muJoseph/Emma-Mk1-DRSSTC/hardware/electrical/Emma Mk1 DRSSTC GDT Driver Rev D/Emma Mk1 DRSSTC GDT Driver Rev D Bottom.png

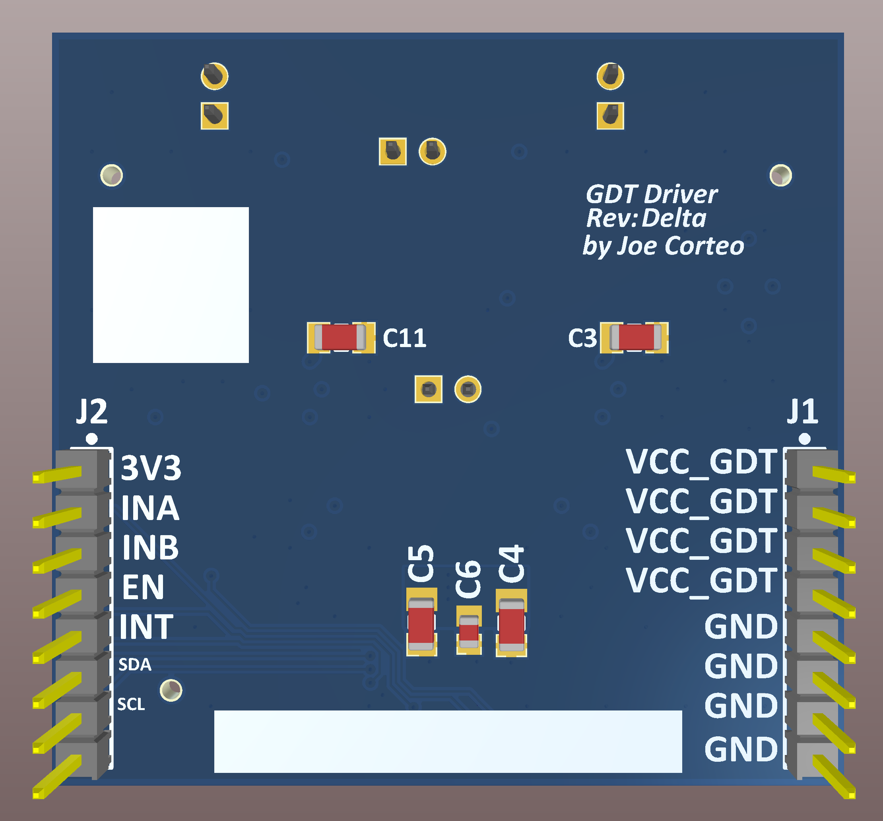
hardware/electrical/Emma Mk1 DRSSTC GDT Driver Rev D/Emma Mk1 DRSSTC GDT Driver Rev D Bottom.png
