muJoseph/Emma-Mk1-DRSSTC/hardware/electrical/Emma Mk1 DRSSTC MB Rev A/Emma Mk1 DRSSTC MB Rev A + GDT Driver Rev D.png

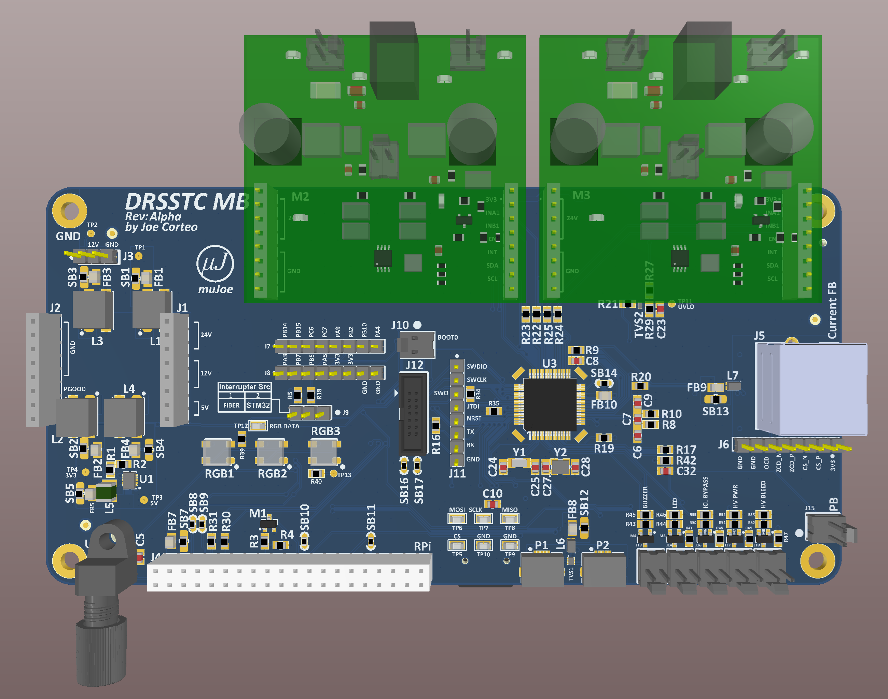
hardware/electrical/Emma Mk1 DRSSTC MB Rev A/Emma Mk1 DRSSTC MB Rev A + GDT Driver Rev D.png
