muJoseph/Emma-Mk1-DRSSTC/hardware/electrical/Emma Mk1 DRSSTC MB Rev A/Emma Mk1 DRSSTC MB Rev A Bottom.png

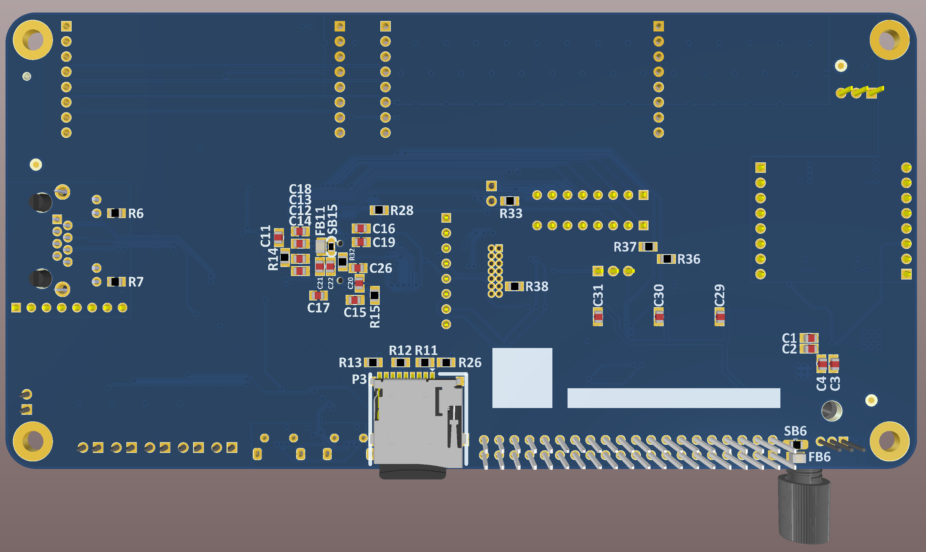
hardware/electrical/Emma Mk1 DRSSTC MB Rev A/Emma Mk1 DRSSTC MB Rev A Bottom.png
