muJoseph/Emma-Mk1-DRSSTC/hardware/electrical/Emma Mk1 DRSSTC MB Rev A/Emma Mk1 DRSSTC MB Rev A Top.png

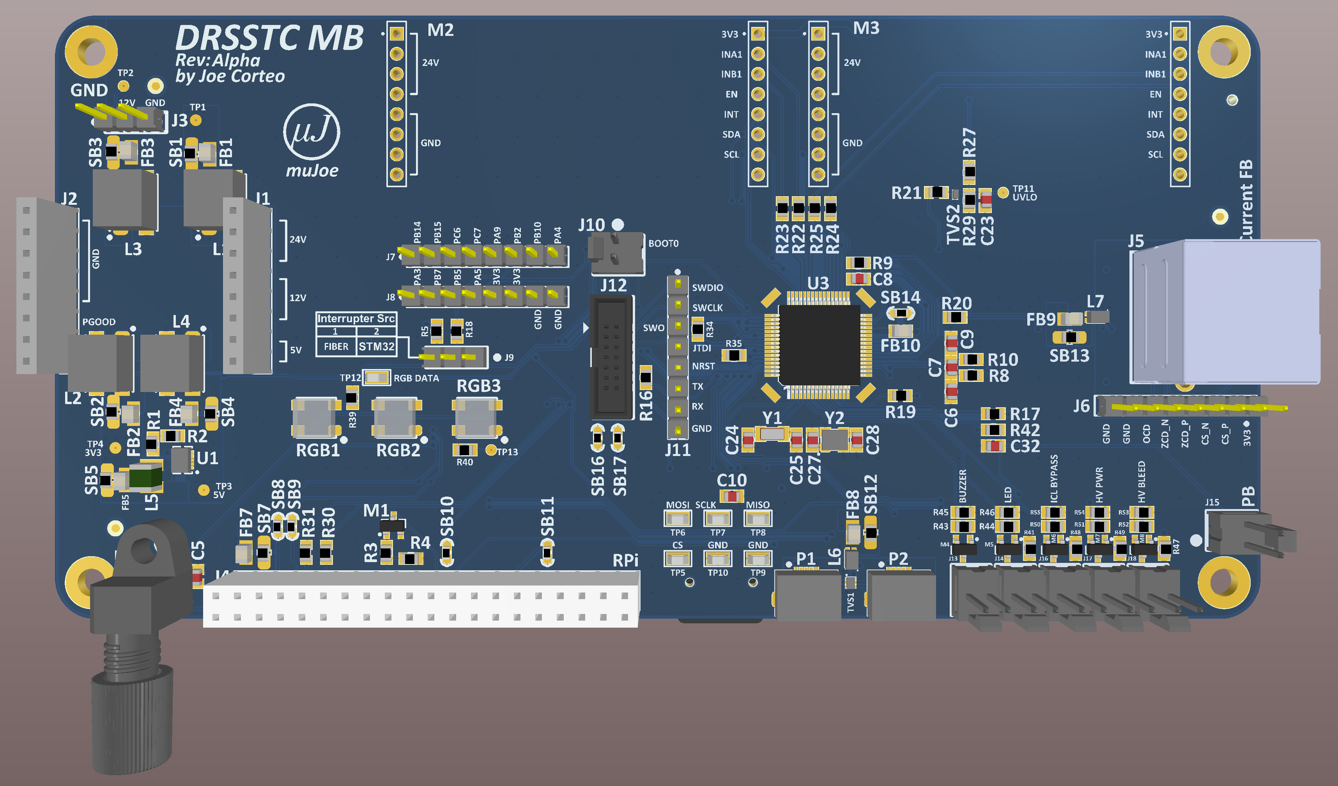
hardware/electrical/Emma Mk1 DRSSTC MB Rev A/Emma Mk1 DRSSTC MB Rev A Top.png
