muJoseph/Emma-Mk1-DRSSTC/hardware/electrical/img/emma-mk1-drsstc-gdt-driver-revd-bottom.png

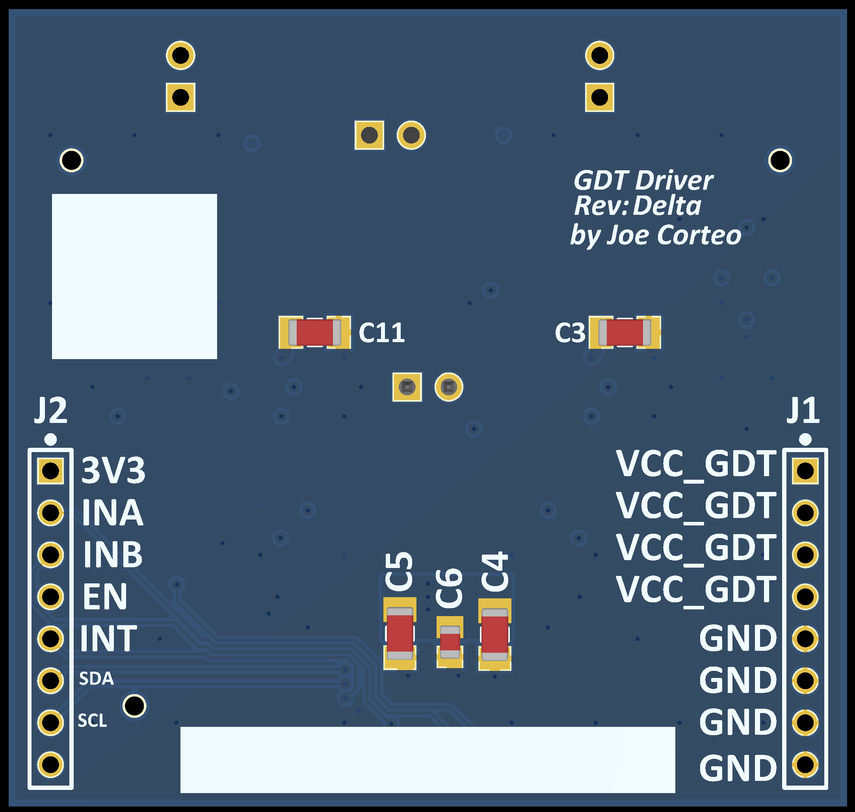
hardware/electrical/img/emma-mk1-drsstc-gdt-driver-revd-bottom.png
