muJoseph/Emma-Mk1-DRSSTC/hardware/electrical/img/emma-mk1-drsstc-gdt-driver-revd-top.png

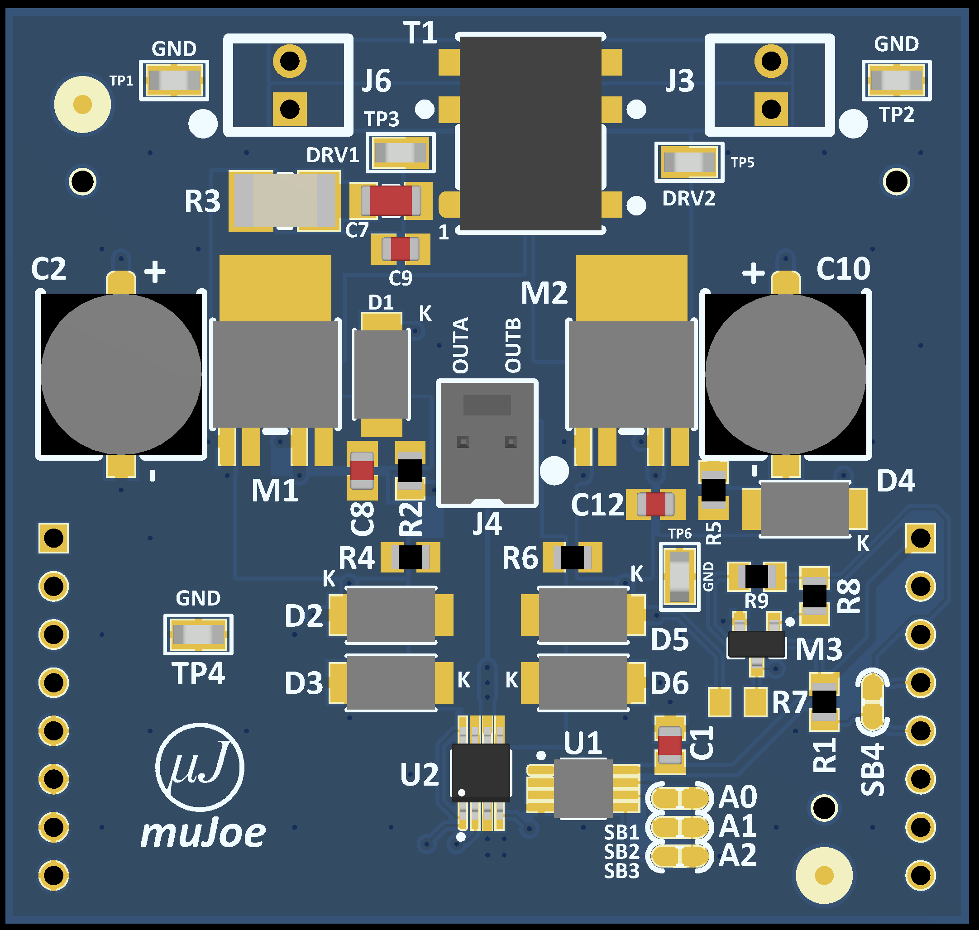
hardware/electrical/img/emma-mk1-drsstc-gdt-driver-revd-top.png
