muJoseph/Emma-Mk1-DRSSTC/hardware/electrical/img/emma-mk1-drsstc-half-bridge-bottom.png

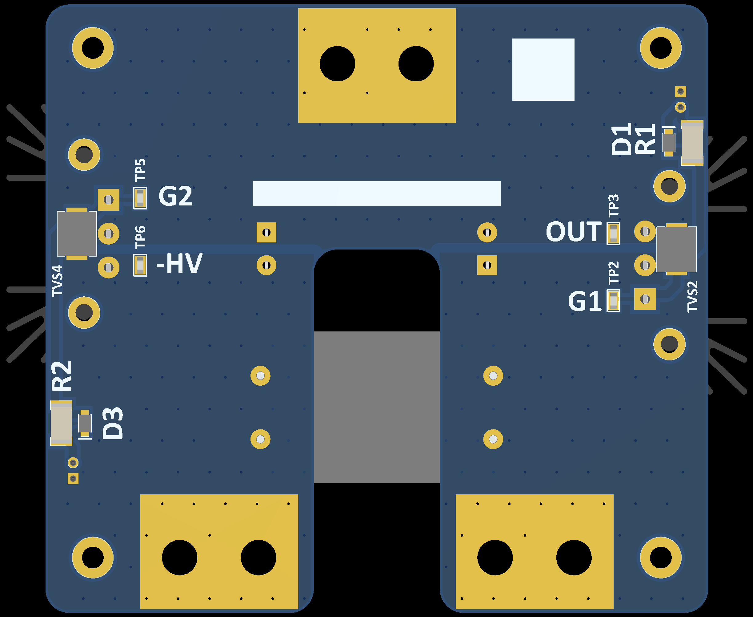
hardware/electrical/img/emma-mk1-drsstc-half-bridge-bottom.png
