muJoseph/Emma-Mk1-DRSSTC/hardware/electrical/img/emma-mk1-drsstc-half-bridge-top.png

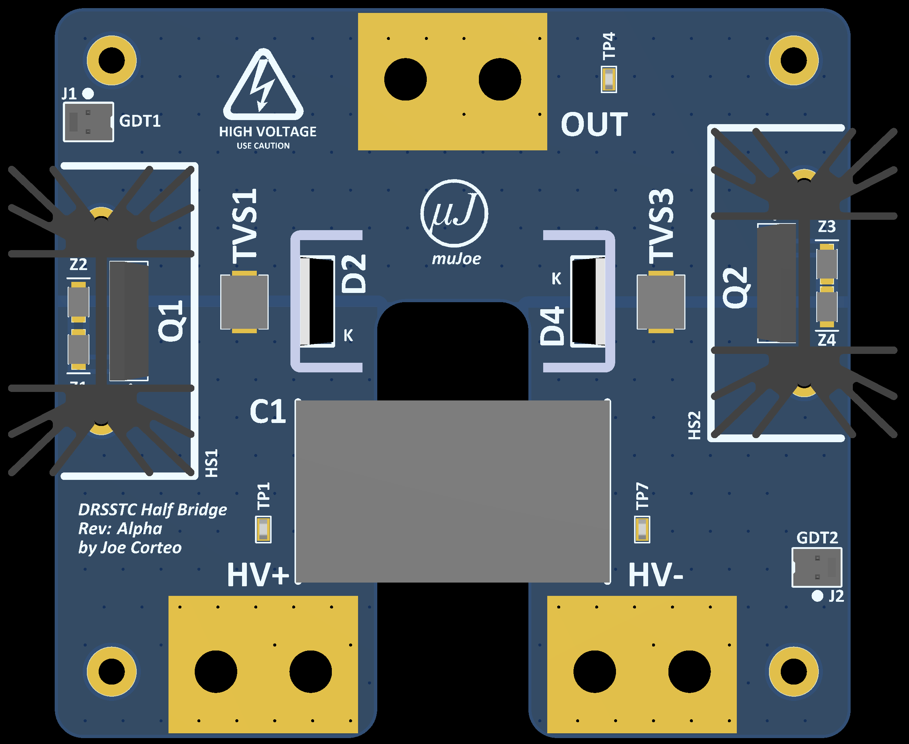
hardware/electrical/img/emma-mk1-drsstc-half-bridge-top.png
