muJoseph/Emma-Mk1-DRSSTC/hardware/electrical/img/emma-mk1-drsstc-mmc-revb-bottom.png

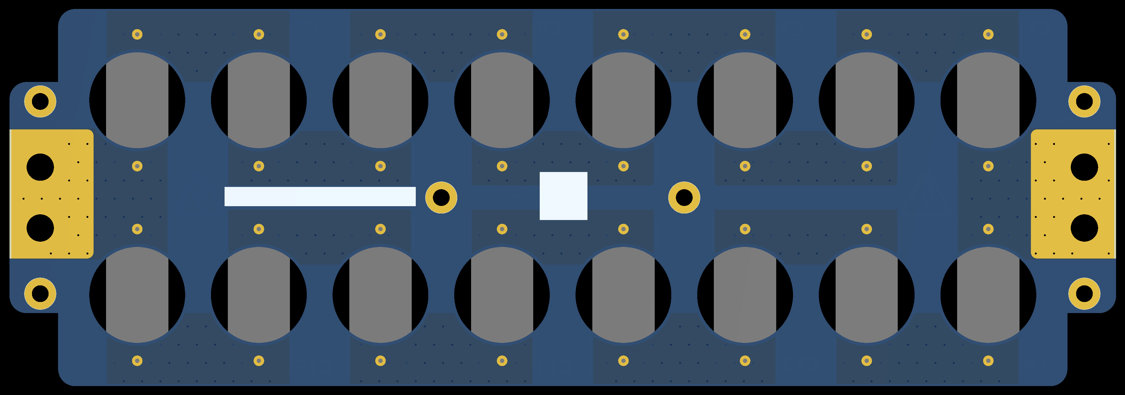
hardware/electrical/img/emma-mk1-drsstc-mmc-revb-bottom.png
