muJoseph/Emma-Mk1-DRSSTC/hardware/electrical/img/emma-mk1-drsstc-motherboard-reva-top.png

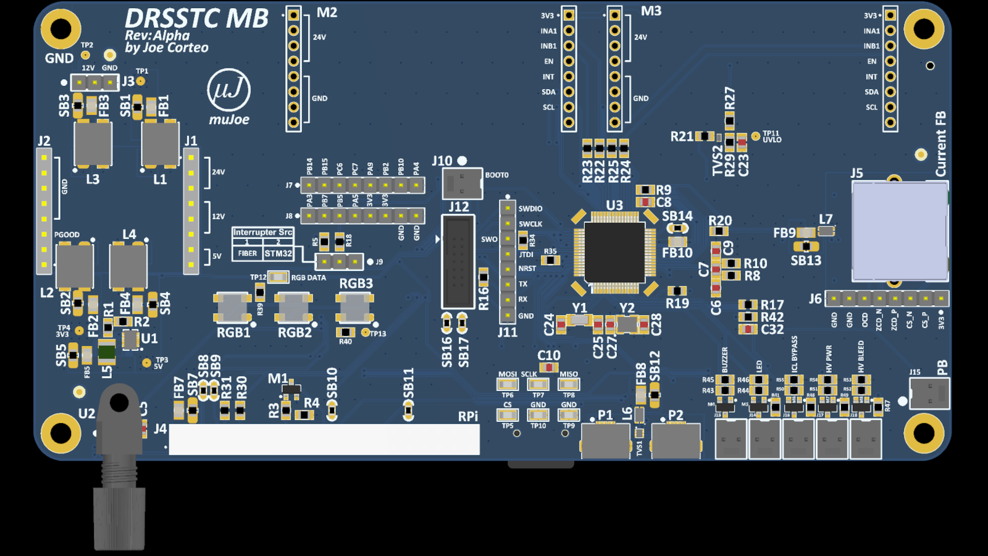
hardware/electrical/img/emma-mk1-drsstc-motherboard-reva-top.png
