muJoseph/Emma-Mk1-DRSSTC/hardware/electrical/img/emma-mk1-drsstc-vdoubler-reva-bottom.png

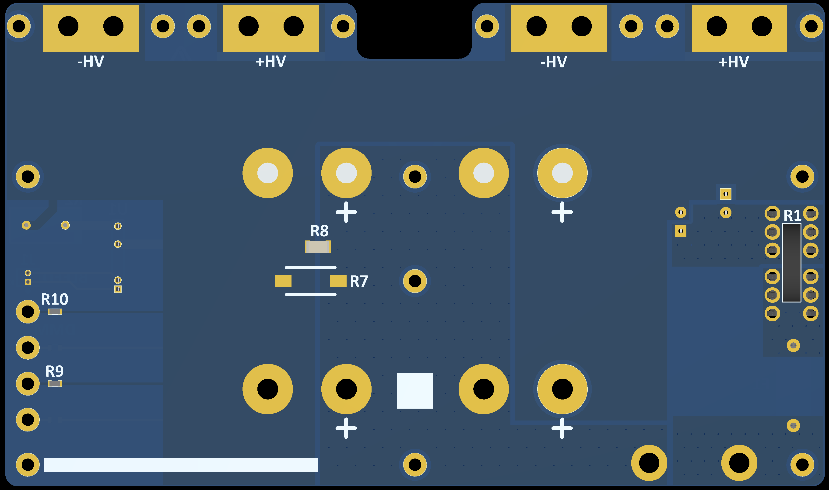
hardware/electrical/img/emma-mk1-drsstc-vdoubler-reva-bottom.png
