muJoseph/Emma-Mk1-DRSSTC/hardware/electrical/img/emma-mk1-drsstc-vdoubler-reva-top.png

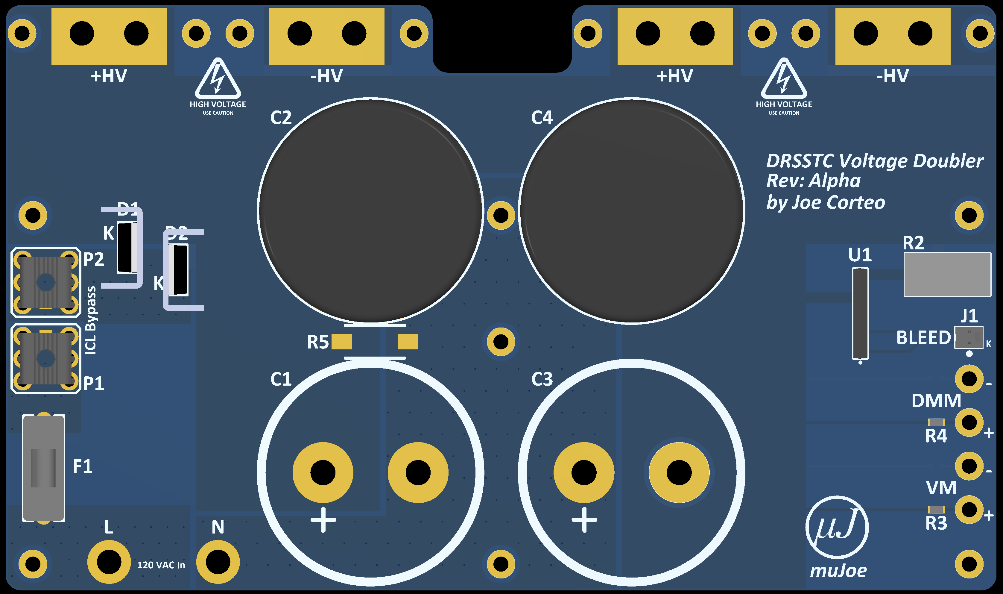
hardware/electrical/img/emma-mk1-drsstc-vdoubler-reva-top.png
