muJoseph/Emma-Mk1-DRSSTC/hardware/mechanical/img/emma-mk1-drsstc-back.png

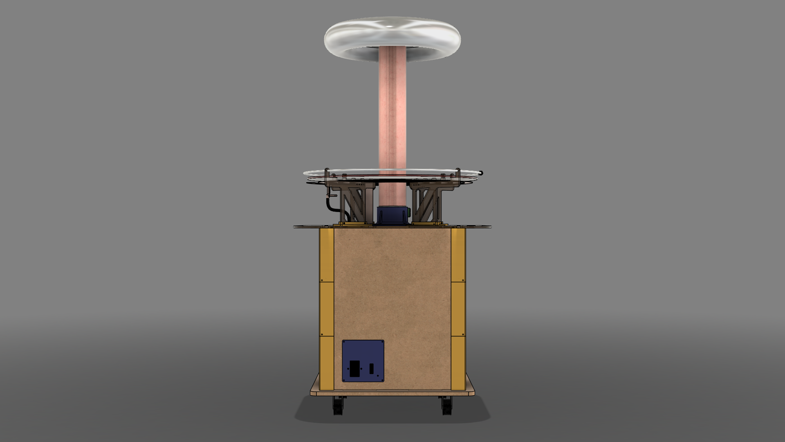
hardware/mechanical/img/emma-mk1-drsstc-back.png
