muJoseph/Emma-Mk1-DRSSTC/hardware/mechanical/img/emma-mk1-drsstc-front.png

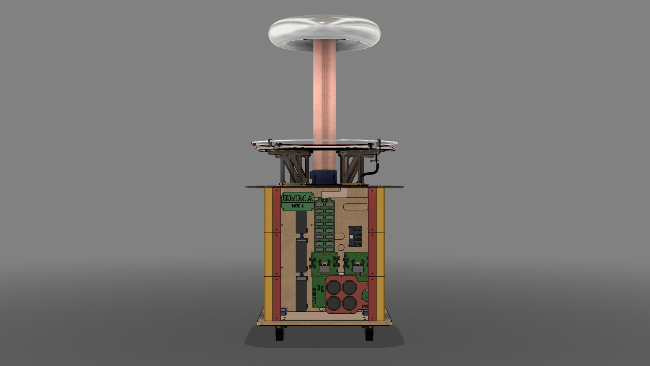
hardware/mechanical/img/emma-mk1-drsstc-front.png
