muJoseph/Emma-Mk1-DRSSTC/hardware/electrical/Emma Mk1 DRSSTC MMC Bank Rev B/BOM-Emma Mk1 DRSSTC MMC Bank Rev B.xlsx

Part Description | Value | MFG P/N | MFG | Designator | Footprint | Quantity | JLCPCB Part #
0.18 µF Film Capacitor 650V 1600V (1.6kV) Polypropylene (PP), Metallized Radial | 0.18uF, 1.6kVDC | R75TR318050H2J | KEMET | C1, C2, C3, C4, C5, C6, C7, C8, C9, C10, C11, C12, C13, C14, C15, C16 | R75TR318050H2J | 16
