muJoseph/Emma-Mk1-DRSSTC/hardware/electrical/Emma Mk1 DRSSTC GDT Driver Rev D/BOM-Emma Mk1 DRSSTC GDT Driver Rev D.xlsx

Part Description | Value | MFG P/N | MFG | Designator | Footprint | Quantity | JLCPCB Part #
100nF 50V X7R ±10% 0805 Multilayer Ceramic Capacitors MLCC - SMD/SMT ROHS | 0.1uF,50V | CL21B104KBCNNNC | Samsung Electro-Mechanics | C1, C6, C8, C12 | CAPC0805(2012)100_N | 4 | C1711
-55℃~+105℃ 10.5mm 100uF 150mA@120Hz 5000hrs@105℃ 50V 8mm ±20% SMD,D8xL10mm Aluminum Electrolytic Capacitors - SMD ROHS | 100uF, 50V | UUD1H101MNL1GS | Nichicon | C2, C10 | UUD1H101MNL1GS | 2 | C116241
4.7µF ±10% 50V Ceramic Capacitor X7R 1206 (3216 Metric) | 4.7uF,50V | CL31B475KBHNNNE | Samsung Electro-Mechanics | C3, C4, C11 | CAPC1206(3216) | 3 | C51205
1µF ±10% 50V Ceramic Capacitor X7R 1206 (3216 Metric) | 1uF,50V | C1206C105K5RACTU | KEMET | C5, C7 | CAPC1206(3216) | 2 | C2167287
2.2uF 50V X5R ±10% 0805 Multilayer Ceramic Capacitors MLCC - SMD/SMT ROHS | 2.2uF,50V | CL21A225KBQNNNE | Samsung Electro-Mechanics | C9 | CAPC0805(2012)100_N | 1 | C377773
-55℃~+125℃ 300uA@60V 3A 500mV@3A 60V 80A Independent SMA Schottky Diodes ROHS |  | SSL36 | hongjiacheng | D1, D2, D3, D4, D5, D6 | SSL36 | 6 | C28646286
Connector Header Through Hole 8 position 0.100" (2.54mm) |  | TSW-108-07-T-S | Samtec Inc. | J1, J2 | TSW-108-07-T-S | 2
Connector Header Through Hole 2 position 0.100" (2.54mm) |  | 22-23-2021 | Molex | J3, J4, J5, J6 | 22-23-2021 | 4 | C234180
-55℃~+150℃ 1 N-Channel + 1 P-Channel 1.5nF 135pF 20A 215pF 24mΩ@10V 24nC@10V 2V@250uA 40V 40W N-Channel + P-Channel TO-252-4L MOSFETs ROHS |  | FDD8424H-HXY | HXY MOSFET | M1, M2 | FDD8424H-HXY | 2 | C22366760
-55℃~+150℃ 1 N-Channel 22pF@25V 2pF@25V 310mA 3V@250uA 4Ω@5V 540mW 60V 870pC@10V SOT-23 MOSFETs ROHS |  | DMN65D8L-7 |  | M3 | DMN65D8L-7_STEP | 1 | C155341
-55℃~+155℃ 125mW 150V 1kΩ Thick Film Resistor ±1% ±100ppm/℃ 0805 Chip Resistor - Surface Mount ROHS | 1k,1/8W | 0805W8F1001T5E | UNI-ROYAL(Uniroyal Elec) | R1, R2, R5, R7, R9 | RESC0805(2012)_N | 5 | C17513
-55℃~+155℃ 15Ω 200V 750mW Thick Film Resistor ±1% ±100ppm/℃ 2010 Chip Resistor - Surface Mount ROHS | 15,3/4W | FRC2010F15R0TS | FOJAN | R3 | RES_2010_Power_Resistor | 1 | C3013300
0 Ohms Jumper Chip Resistor 0805 (2012 Metric) Automotive AEC-Q200 Thick Film | 0 | RMCF0805ZT0R00 | Stackpole Electronics | R4, R6, R8 | RESC0805(2012)_N | 3 | C237773
0 Ohms Jumper 0.1W, 1/10W Chip Resistor 0603 (1608 Metric) Automotive AEC-Q200 Thick Film | 0 | RMCF0603ZT0R00 | Stackpole Electronics | SB1, SB2, SB3, SB4 | SOLDER-BRIDGE-NO-RES0603 | 4
4mH Gate Drive Pulse Transformer 1:1:1 Surface Mount |  | PH9572.111ANLT | Pulse Electronics | T1 | PH9572.111ANLT | 1 | C6147304
2.67mmx1.02mm Ferrite Ring (SMD) Non-Plastic - Test Points / Test Rings ROHS |  | RH-5015 | ronghe | TP1, TP2, TP3, TP4, TP5, TP6 | RH-5015 | 6 | C5199798
Temperature Sensor Digital, Local -55°C ~ 125°C 11 b 8-TSSOP |  | PCT2075DP,118 | NXP USA Inc. | U1 | PCT2075DP,118 | 1 | C192518
-40℃~+150℃ 1.8V~2.3V 2 4.5V~26V 450uA 5A 5A 6ns 800mV~1.2V 9ns IGBT Low Side Under Voltage Protection HVSSOP-8 Gate Drivers ROHS |  | UCC27624DGNR | Texas Instruments | U2 | UCC27624DGNR_JLCPCB | 1 | C6581862
