muJoseph/Emma-Mk1-DRSSTC/hardware/electrical/Emma Mk1 DRSSTC VDoubler Rev A/BOM-Emma Mk1 DRSSTC VDoubler Rev A.xlsx

Part Description | Value | MFG P/N | MFG | Designator | Footprint | Quantity | JLCPCB Part #
3600µF 250V Aluminum Electrolytic Capacitors Radial, Can - Screw Terminals 74mOhm @ 100Hz 18000 Hrs @ 85°C | 3600uF,250V | ALS70A362KE250 | ALS70A362KE250 | C1, C2, C3, C4 | ALS70A362KE250 | 4
Diode Standard 600V 15A Through Hole TO-220AC |  | VS-15ETX06-M3 | Vishay Semiconductor Diodes Division | D1, D2 | VS-15ETX06-M3_WITH_507302B00000G | 2
Fuse Block 20A 250V 1 Circuit Cartridge Through Hole | 20A | 696108003002 | Würth Elektronik | F1 | 696108003002 | 1
Connector Header Through Hole 2 position 0.100" (2.54mm) |  | 22-23-2021 | Molex | J1 | 22-23-2021 | 1
6 Pin Screw Terminal, Power Tap M5 Through Hole |  | 7807 | Keystone Electronics | P1, P2 | 7807 | 2
Inrush Current Limiter 20 Ohms ±25% 7A 0.866" (22.00mm) | 20 | SL22 20007 | Ametherm | R1 | SL22 20007 | 1
1.1 kOhms ±5% 10W Through Hole Resistor Radial Cement Coated, Flame Proof, Moisture Resistant, Safety Wirewound | 1.1k,10W | SQMBW101K1J | TE Connectivity Passive Product | R2 | SQMBW101K1J | 1
60.4 kOhms ±1% 1W Chip Resistor 1206 (3216 Metric) Automotive AEC-Q200, Pulse Withstanding Thick Film | 60.4k,1W | RCS120660K4FKEA | Vishay Dale | R4, R10 | RES1206R | 2
20 kOhms ±5% 5W Chip Resistor 5329 (13573 Metric), J-Lead Flame Retardant Coating, Safety Metal Film | 20k, 5W | SMF520KJT | TE Connectivity Passive Product | R5, R7 | SMF520KJT | 2
60.4 kOhms ±1% 1W Chip Resistor 2512 (6332 Metric) Automotive AEC-Q200 Thick Film | 60.4k,1W | RMCF2512FT60K4 | Stackpole Electronics Inc | R6, R8 | RES2512R | 2 | C2491819
Solid State Photo-Coupled Relay (Photorelay) SPST-NO (1 Form A) 8-SIP, 4 Leads |  | CPC1983Y | IXYS Integrated Circuits Division | U1 | CPC1983Y | 1
