muJoseph/Emma-Mk1-DRSSTC/hardware/electrical/Emma Mk1 DRSSTC CS Rev B/BOM-Emma Mk1 DRSSTC CS Rev B(Low Diff Gain).xlsx

Part Description | Value | MFG P/N | MFG | Designator | Footprint | Quantity | JLCPCB Part #
100nF 50V X7R ±10% 0805 Multilayer Ceramic Capacitors MLCC - SMD/SMT ROHS | 0.1uF,50V | CL21B104KBCNNNC | Samsung Electro-Mechanics | C1, C2, C4 | CAPC0805(2012)100_N | 3 | C1711
Diode 30 V 100mA Surface Mount EMD2 |  | RB500SM-30FHT2R | Rohm Semiconductor | D2, D3, D4, D5, D10, D11 | RB500SM-30FHT2R_JLCPCB | 6 | C5336584
Diode 30 V 2A Surface Mount M-FLAT (2.4x3.8) |  | CMS06(TE12L,Q,M) | Toshiba Semiconductor and Storage | D6, D7, D8, D9 | CMS06(TE12L,Q,M)_JLCPCB | 4 | C261920
600 Ohms @ 100 MHz 1 Power Line Ferrite Bead 0805 (2012 Metric) 2A 90mOhm |  | WLBD2012HCU601TH | Walsin Technology Corporation | FB1 | FERRITE_BEAD_0805 | 1 | C3716924
2 Line Common Mode Choke Surface Mount 90 Ohms @ 100 MHz 500mA DCR 300mOhm |  | BWCU00201212900Y03 | Pulse Electronics | L1 | BWCU00201212900Y03 | 1 | C2838272
1.3 kOhms ±0.1% 0.125W, 1/8W Chip Resistor 0805 (2012 Metric) Automotive AEC-Q200 Thin Film | 1k3, 0.1% | ERA-6AEB132V | Panasonic Electronic Components | R1, R2, R7, R8, R14, R16 | RESC0805(2012)_N | 6 | C473285
500 mOhms ±1% 0.5W, 1/2W Chip Resistor 1206 (3216 Metric) Current Sense Thick Film | 500m, 1/2W | CSR1206FTR500 | Stackpole Electronics Inc | R4, R9, R10 | RES1206R | 3 | C346764
10 kOhms ±0.1% 0.125W, 1/8W Chip Resistor 0805 (2012 Metric) Thin Film | 10k, 0.1% | RT0805BRD0710KL | YAGEO | R5, R6, R11, R12 | RESC0805(2012)_N | 4 | C110775
-55℃~+155℃ 100V 100mW 3.92kΩ Thin Film Resistor ±0.1% ±10ppm/℃ 0805 Chip Resistor - Surface Mount ROHS | 3.92k, 0.1% | RN73C2A3K92BTD | TE Connectivity | R13, R17 | RESC0805(2012)_N | 2 | C2089962
33 mOhms ±1% 0.25W, 1/4W Chip Resistor 0805 (2012 Metric) Automotive AEC-Q200, Current Sense, Moisture Resistant Thick Film | 33m, 1/4W | RCWE080533L0FNEA | Vishay Dale | R15 | RESC0805(2012)_N | 1 | C3989910
2.67mmx1.02mm Ferrite Ring (SMD) Non-Plastic - Test Points / Test Rings ROHS |  | RH-5015 | ronghe | TP1, TP2, TP3, TP4, TP5, TP6, TP7, TP8, TP9 | RH-5015 | 9 | C5199798
6.2V Clamp 17A (8/20µs) Ipp Tvs Diode Surface Mount 0402C/SOD-923F | 3V3 | CPDQC3V3T-HF | Comchip Technology | TVS1, TVS2, TVS3, TVS4 | CPDQC3V3T-HF | 4 | C2443363
CMOS Amplifier 2 Circuit Rail-to-Rail 8-SOIC |  | TLV9062IDR | Texas Instruments | U1, U2 | TLV9062IDR | 2 | C398355
