muJoseph/Emma-Mk1-DRSSTC/hardware/electrical/Emma Mk1 DRSSTC CS Rev B/BOM-Emma Mk1 DRSSTC CS Rev B.xlsx

Part Description | Value | MFG P/N | MFG | Designator | Footprint | Quantity | JLCPCB Part #
100nF 50V X7R ±10% 0805 Multilayer Ceramic Capacitors MLCC - SMD/SMT ROHS | 0.1uF,50V | CL21B104KBCNNNC | Samsung Electro-Mechanics | C1, C2, C4 | CAPC0805(2012)100_N | 3 | C1711
Yellow-Green 572nm LED Indication - Discrete 2.2V 0603 (1608 Metric) |  | SML-D12M1WT86 | Rohm Semiconductor | D1 | SML-D12M1WT86 | 1
Diode 30 V 100mA Surface Mount EMD2 |  | RB500SM-30FHT2R | Rohm Semiconductor | D2, D3, D4, D5, D10, D11 | RB500SM-30FHT2R_JLCPCB | 6 | C5336584
Diode 30 V 2A Surface Mount M-FLAT (2.4x3.8) |  | CMS06(TE12L,Q,M) | Toshiba Semiconductor and Storage | D6, D7, D8, D9 | CMS06(TE12L,Q,M)_JLCPCB | 4 | C261920
600 Ohms @ 100 MHz 1 Power Line Ferrite Bead 0805 (2012 Metric) 2A 90mOhm |  | WLBD2012HCU601TH | Walsin Technology Corporation | FB1 | FERRITE_BEAD_0805 | 1 | C3716924
Jack Modular Connector 8p8c (RJ45, Ethernet) 90° Angle (Right) Shielded |  | MTJ-88ARX1-FSM-LG | Adam Tech | J1 | MTJ-88ARX1-FSM-LG | 1
Connector Header Through Hole 8 position 0.100" (2.54mm) |  | TSW-108-07-T-S | Samtec Inc. | J2 | TSW-108-07-T-S | 1
Connector Header Through Hole 2 position 0.100" (2.54mm) |  | 22-23-2021 | Molex | J3, J4, J5 | 22-23-2021 | 3
2 Line Common Mode Choke Surface Mount 90 Ohms @ 100 MHz 500mA DCR 300mOhm |  | BWCU00201212900Y03 | Pulse Electronics | L1 | BWCU00201212900Y03 | 1 | C2838272
1.3 kOhms ±0.1% 0.125W, 1/8W Chip Resistor 0805 (2012 Metric) Automotive AEC-Q200 Thin Film | 1k3, 0.1% | ERA-6AEB132V | Panasonic Electronic Components | R1, R2, R3, R7, R8, R14, R16 | RESC0805(2012)_N | 7 | C473285
500 mOhms ±1% 0.5W, 1/2W Chip Resistor 1206 (3216 Metric) Current Sense Thick Film | 500m, 1/2W | CSR1206FTR500 | Stackpole Electronics Inc | R4, R9, R10 | RES1206R | 3 | C346764
10 kOhms ±0.1% 0.125W, 1/8W Chip Resistor 0805 (2012 Metric) Thin Film | 10k, 0.1% | RT0805BRD0710KL | YAGEO | R5, R6, R11, R12 | RESC0805(2012)_N | 4 | C110775
21 kOhms ±0.1% 0.125W, 1/8W Chip Resistor 0805 (2012 Metric) Automotive AEC-Q200 Thin Film | 21k, 0.1% | ERA-6AEB2102V | Panasonic Electronic Components | R13, R17 | RESC0805(2012)_N | 2
33 mOhms ±1% 0.25W, 1/4W Chip Resistor 0805 (2012 Metric) Automotive AEC-Q200, Current Sense, Moisture Resistant Thick Film | 33m, 1/4W | RCWE080533L0FNEA | Vishay Dale | R15 | RESC0805(2012)_N | 1 | C3989910
0 Ohms Jumper 0.1W, 1/10W Chip Resistor 0603 (1608 Metric) Automotive AEC-Q200 Thick Film | 0 | RMCF0603ZT0R00 | Stackpole Electronics | SB1, SB2 | SOLDER-BRIDGE-NO-RES0603 | 2 | C2441282
110 A Current Sense Transformer 20kHz ~ 200kHz 580mOhm Max 14 mH Through Hole |  | CST206-1A | Triad Magnetics | T1, T2, T3 | CST206-1A | 3
2.67mmx1.02mm Ferrite Ring (SMD) Non-Plastic - Test Points / Test Rings ROHS |  | RH-5015 | ronghe | TP1, TP2, TP3, TP4, TP5, TP6, TP7, TP8, TP9 | RH-5015 | 9 | C5199798
6.2V Clamp 17A (8/20µs) Ipp Tvs Diode Surface Mount 0402C/SOD-923F | 3V3 | CPDQC3V3T-HF | Comchip Technology | TVS1, TVS2, TVS3, TVS4 | CPDQC3V3T-HF | 4 | C2443363
CMOS Amplifier 2 Circuit Rail-to-Rail 8-SOIC |  | TLV9062IDR | Texas Instruments | U1, U2 | TLV9062IDR | 2 | C398355
