muJoseph/Emma-Mk1-DRSSTC/hardware/electrical/Emma Mk1 DRSSTC Half Bridge Rev A/BOM-Emma Mk1 DRSSTC Half Bridge Rev A(IGBT Screw On Heatsink).xlsx

Part Description | Value | MFG P/N | MFG | Designator | Footprint | Quantity | JLCPCB Part #
5 µF Film Capacitor 1000V (1kV) Polypropylene (PP), Metallized Radial - 4 Leads | 5uF, 1kVDC | C4AQNLW4500M33J | KEMET | C1 | C4AQNLW4500M33J | 1
Diode Schottky 50V 1A Surface Mount SOD-123FL |  | DSS15UTR | SMC Diode Solutions | D1, D3 | DSS15UTR | 2
Diode Standard 600V 15A Through Hole TO-220AC |  | VS-15ETX06-M3 | Vishay Semiconductor Diodes Division | D2, D4 | VS-15ETX06-M3_WITH_507302B00000G | 2
Heat Sink TO-218, TO-220, TO-247 Aluminum Alloy 6.5W @ 75°C Board Level, Vertical |  | HSE17-252525P | Same Sky (Formerly CUI Devices) | HS1, HS2 | HSE17-252525P | 2
Connector Header Through Hole 2 position 0.100" (2.54mm) |  | 22-23-2021 | Molex | J1, J2 | 22-23-2021 | 2
IGBT Trench Field Stop 600 V 140 A 714 W Through Hole PG-TO247-3 |  | IGW100N60H3FKSA1 | Infineon Technologies | Q1, Q2 | IGW100N60H3FKSA1 | 2
15 Ohms ±5% 2W Chip Resistor 2512 (6432 Metric) Thick Film | 15,2W | CRGH2512J15R | TE Connectivity Passive Product | R1, R2 | RES2512R | 2
2.67mmx1.02mm Ferrite Ring (SMD) Non-Plastic - Test Points / Test Rings ROHS |  | RH-5015 | ronghe | TP1, TP2, TP3, TP4, TP5, TP6, TP7 | RH-5015 | 7 | C5199798
567V Clamp 2.6A Ipp Tvs Diode Surface Mount DO-214AB (SMCJ) | 350V | SMCJ350CA | Littelfuse Inc. | TVS1, TVS3 | SMCJ350CA | 2
45.7V Clamp 33.3A Ipp Tvs Diode Surface Mount DO-214AB (SMCJ) | 28V2 | 1.5SMC33CA | Littelfuse Inc. | TVS2, TVS4 | 1.5SMC33CA | 2
Zener Diode 33V 1W ±6.06% Surface Mount PMDTM | 33V | PDZVTFTR33B | Rohm Semiconductor | Z1, Z2, Z3, Z4 | PDZVTFTR33B | 4
