muJoseph/Emma-Mk1-DRSSTC/hardware/electrical/Emma Mk1 DRSSTC MB Rev A/BOM-Emma Mk1 DRSSTC MB Rev A(JLCPCB Fabrication).xlsx

Part Description | Value | MFG P/N | MFG | Designator | Footprint | Quantity | JLCPCB Part #
2.2 µF ±10% 16V Ceramic Capacitor X7R 0805 (2012 Metric) | 2.2uF, 16V | CL21B225KOFNNNE | Samsung Electro-Mechanics | C2 | CAPC0805(2012)100_N | 1 | C28234
22µF ±20% 16V Ceramic Capacitor X5R 0805 (2012 Metric) | 22uF,16V | CL21A226MOCLRNC | Samsung Electro-Mechanics | C3 | CAPC0805(2012)100_N | 1 | C398815
100nF 50V X7R ±10% 0805 Multilayer Ceramic Capacitors MLCC - SMD/SMT ROHS | 0.1uF,50V | CL21B104KBCNNNC | Samsung Electro-Mechanics | C5, C10, C11, C13, C14, C17, C18, C19, C20, C21, C23, C26, C32 | CAPC0805(2012)100_N | 13 | C1711
1.2nF 50V NP0 ±2% 0805 Multilayer Ceramic Capacitors MLCC - SMD/SMT ROHS | 1.2nF,50V | CC0805GRNPO9BN122 | YAGEO | C6, C8, C9 | CAPC0805(2012)100_N | 3 | C541552
50V 6.8nF C0G ±5% 0805 Multilayer Ceramic Capacitors MLCC - SMD/SMT ROHS | 6.8nF,50V | GRM2195C1H682JA01D | Murata Electronics | C7 | CAPC0805(2012)100_N | 1 | C77068
1uF 50V X7R ±10% 0805 Multilayer Ceramic Capacitors MLCC - SMD/SMT ROHS | 1uF,50V | CL21B105KBFNNNE | Samsung Electro-Mechanics | C12, C15, C22, C29, C30, C31 | CAPC0805(2012)100_N | 6 | C28323
35V 4.7uF X7R ±10% 0805 Multilayer Ceramic Capacitors MLCC - SMD/SMT ROHS | 4.7uF,35V | CGA0805X7R475K350MT | HRE | C16 | CAPC0805(2012)100_N | 1 | C6119943
5.1pF 50V C0G 0805 Multilayer Ceramic Capacitors MLCC - SMD/SMT ROHS | 5.1pF,50V | 0805CG5R1C500NT | FH (Guangdong Fenghua Advanced Tech) | C24, C25 | CAPC0805(2012)100_N | 2 | C1825
10pF 50V C0G ±5% 0805 Multilayer Ceramic Capacitors MLCC - SMD/SMT ROHS | 10pF,50V | 0805CG100J500NT | FH (Guangdong Fenghua Advanced Tech) | C27, C28 | CAPC0805(2012)100_N | 2 | C157608
1 100Ω@100MHz 150mΩ 800mA ±25% 0805 Ferrite Beads ROHS |  | GZ2012D101TF | Sunlord | FB1, FB2, FB3, FB4, FB5, FB8, FB9, FB10, FB11 | FERRITE_BEAD_0805 | 9 | C1015
-40℃~+125℃ 1.02kΩ 10MΩ 125V 17mΩ 2 3A SMD,7x6mm Common Mode Filters ROHS |  | SMCM7060-102T | SXN(Shun Xiang Nuo Elec) | L1, L2, L3, L4 | SMCM7060-102T | 4 | C381615
10µH Unshielded Wirewound Inductor 900mA 172.9mOhm Max 1210 (3225 Metric) | 10 uH | CBC3225T100KR | Taiyo Yuden | L5 | IND1210 (3225 Metric) | 1 | C90321
2 Line Common Mode Choke Surface Mount 90 Ohms @ 100 MHz 500mA DCR 300mOhm |  | BWCU00201212900Y03 | Pulse Electronics | L6, L7 | BWCU00201212900Y03 | 2 | C2838272
-55℃~+150℃ 1 N-Channel 22pF@25V 2pF@25V 310mA 3V@250uA 4Ω@5V 540mW 60V 870pC@10V SOT-23 MOSFETs ROHS |  | DMN65D8L-7 |  | M1, M4, M5, M6, M7, M8 | DMN65D8L-7_STEP | 6 | C155341
-20℃~+85℃ 1 1.8A 30V 5,000 times 5P Black Female Micro-B Surface Mount, Right Angle USB 2.0 SMD USB Connectors ROHS |  | MicroXNJ | SHOU HAN | P1, P2 | MicroXNJ | 2 | C404969
1.85mm Connector and Ejector MicroSD Card (TF Card) Push-Push With Locating Post SMD SD Card / Memory Card Connector ROHS |  | TF-01A | Korean Hroparts Elec | P3 | TF-01A | 1 | C91145
0 Ohms Jumper Chip Resistor 0805 (2012 Metric) Automotive AEC-Q200 Thick Film | 0 | RMCF0805ZT0R00 | Stackpole Electronics | R2, R3, R14, R15, R17, R18, R19, R20, R21, R22, R23, R24, R25, R26, R28, R30, R31, R39, R40, R43, R44, R50, R51, R52 | RESC0805(2012)_N | 24 | C237773
-55℃~+155℃ 125mW 150V 1kΩ Thick Film Resistor ±1% ±100ppm/℃ 0805 Chip Resistor - Surface Mount ROHS | 1k,1/8W | 0805W8F1001T5E | UNI-ROYAL(Uniroyal Elec) | R4, R36, R37, R42, R45, R46, R53, R54, R55 | RESC0805(2012)_N | 9 | C17513
-55℃~+155℃ 125mW 150V 300Ω Thick Film Resistor ±1% ±100ppm/℃ 0805 Chip Resistor - Surface Mount ROHS | 300,1/8W | 0805W8F3000T5E | UNI-ROYAL(Uniroyal Elec) | R5, R41, R47, R48, R49 | RESC0805(2012)_N | 5 | C17617
1.3 kOhms ±0.1% 0.125W, 1/8W Chip Resistor 0805 (2012 Metric) Automotive AEC-Q200 Thin Film | 1k3, 0.1% | ERA-6AEB132V | Panasonic Electronic Components | R6, R7 | RESC0805(2012)_N | 2
-55℃~+155℃ 100Ω 125mW 150V Thick Film Resistor ±1% ±100ppm/℃ 0805 Chip Resistor - Surface Mount ROHS | 100,1/8W | 0805W8F1000T5E | UNI-ROYAL(Uniroyal Elec) | R8, R9, R10, R38 | RESC0805(2012)_N | 4 | C17408
10 kOhms ±1% 0.125W, 1/8W Chip Resistor 0805 (2012 Metric) Automotive AEC-Q200 Thick Film | 10k | RMCF0805FT10K0 | Stackpole Electronics Inc | R13, R33 | RESC0805(2012)_N | 2 | C237755
-40℃~+85℃ 0.25mA 1.6mm 2000V 3.7V~5.5V 4.8mm 4kHz 5mm 620nm~625nm 800Kbit/s G:815mcd~1275mcd SMD5050-4P RGB LEDs(Built-in IC) ROHS |  | SKC6812RV | OPSCO Optoelectronics | RGB1, RGB2, RGB3 | SKC6812RV | 3 | C2890040
-55℃~+155℃ 0Ω 125mW 150V Thick Film Resistor ±1% ±800ppm/℃ 0805 Chip Resistor - Surface Mount ROHS | 0 | 0805W8F0000T5E | UNI-ROYAL(Uniroyal Elec) | SB1, SB3, SB6, SB7, SB12 | SOLDER-BRIDGE-NO-RES0805 | 5 | C17477
0 Ohms Jumper 0.1W, 1/10W Chip Resistor 0603 (1608 Metric) Automotive AEC-Q200 Thick Film | 0 | RMCF0603ZT0R00 | Stackpole Electronics | SB8, SB9, SB10, SB11, SB16, SB17 | SOLDER-BRIDGE-NO-RES0603 | 6 | C2441282, [NoParam]
2.67mmx1.02mm Ferrite Ring (SMD) Non-Plastic - Test Points / Test Rings ROHS |  | RH-5015 | ronghe | TP5, TP6, TP7, TP8, TP9, TP10, TP12 | RH-5015 | 7 | C5199798
ESD SON-6(1x1.5) ESD and Surge Protection (TVS/ESD) ROHS |  | TPD4E004DRYR-TP | TECH PUBLIC | TVS1 | TPD4E004DRYR-TP | 1 | C2937000
6.2V Clamp 17A (8/20µs) Ipp Tvs Diode Surface Mount 0402C/SOD-923F | 3V3 | CPDQC3V3T-HF | Comchip Technology | TVS2 | CPDQC3V3T-HF | 1 | C2443363
Buck Switching Regulator IC Positive Fixed 3.3V 1 Output 500mA 10-WFDFN Exposed Pad |  | TPS62177DQCR | Texas Instruments | U1 | TPS62175DQCR | 1 | C91241
ARM® Cortex®-M4F STM32G4 Microcontroller IC 32-Bit 170MHz 512KB (512K x 8) FLASH 64-LQFP (10x10) |  | STM32G474RET6 | STMicroelectronics | U3 | ICC_LQFP64_10X10_P050_SOCKET_YAMAICHI_IC149-064-069-B5_NM | 1 | C521608
-40℃~+85℃ 32.768kHz 50kΩ 6pF SMD3215-2P Crystals ROHS | 32.768kHz | NX3215SA 32.768KHZ EXS00A-MU00525 | NDK | Y1 | NX3215SA 32.768KHZ EXS00A-MU00525 | 1 | C528987
-20℃~+70℃ 24MHz 30Ω 9pF Crystal Oscillator ±10ppm ±10ppm SMD3225-4P Crystals ROHS | 24MHz | XTM32024000FT00351001 | TOGNJING | Y2 | XTM32024000FT00351001 | 1 | C41383244
