muJoseph/Emma-Mk1-DRSSTC/hardware/mechanical/fab/PCB Standoffs/DRSSTC PCB Standoff Kit Complete Rev A1.3mf

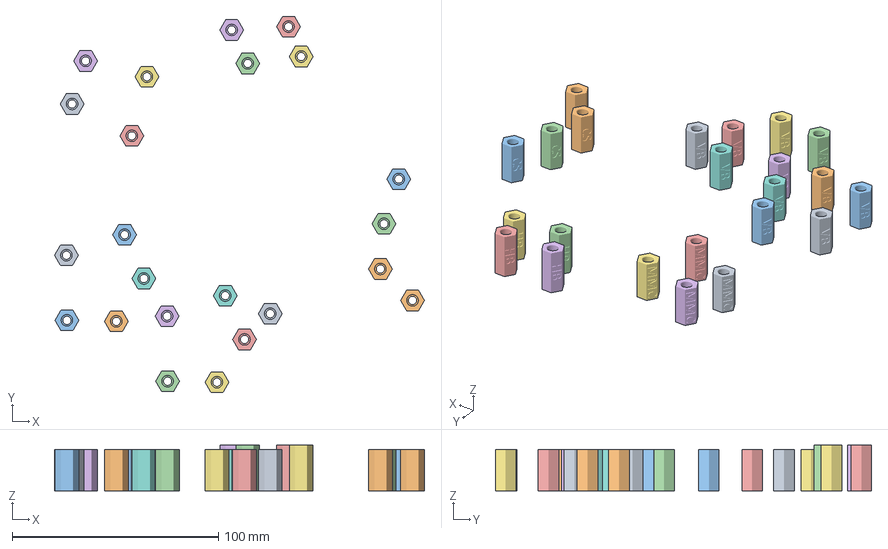
[picture p22: CAD file, 2026-07-29]
hardware/mechanical/fab/PCB Standoffs/DRSSTC PCB Standoff Kit Complete Rev A1.3mf
179.6 x 182.6 x 22.1 mm
MMC Bank PCB Standoff Rev A1 x 4
CS PCB Standoff Rev A1 x 4
VDoubler PCB Standoff Rev A1 x 11
HB Standoff Rev A1 x 4
