muJoseph/Emma-Mk1-DRSSTC/hardware/mechanical/fab/Air Vent Cover/Air Vent Cover Rev A1.3mf

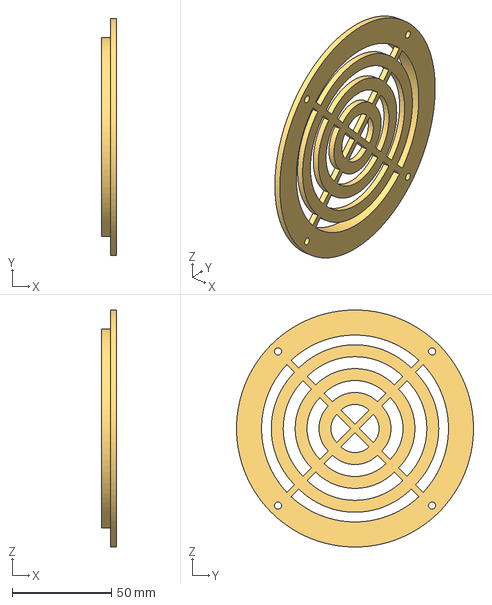
[picture p23: CAD file, 2026-07-29]
hardware/mechanical/fab/Air Vent Cover/Air Vent Cover Rev A1.3mf
7.50 x 119.2 x 119.2 mm
