muJoseph/Emma-Mk1-DRSSTC/hardware/mechanical/fab/Cap Cradle/Cap Cradle Top Foot Rev A1.3mf

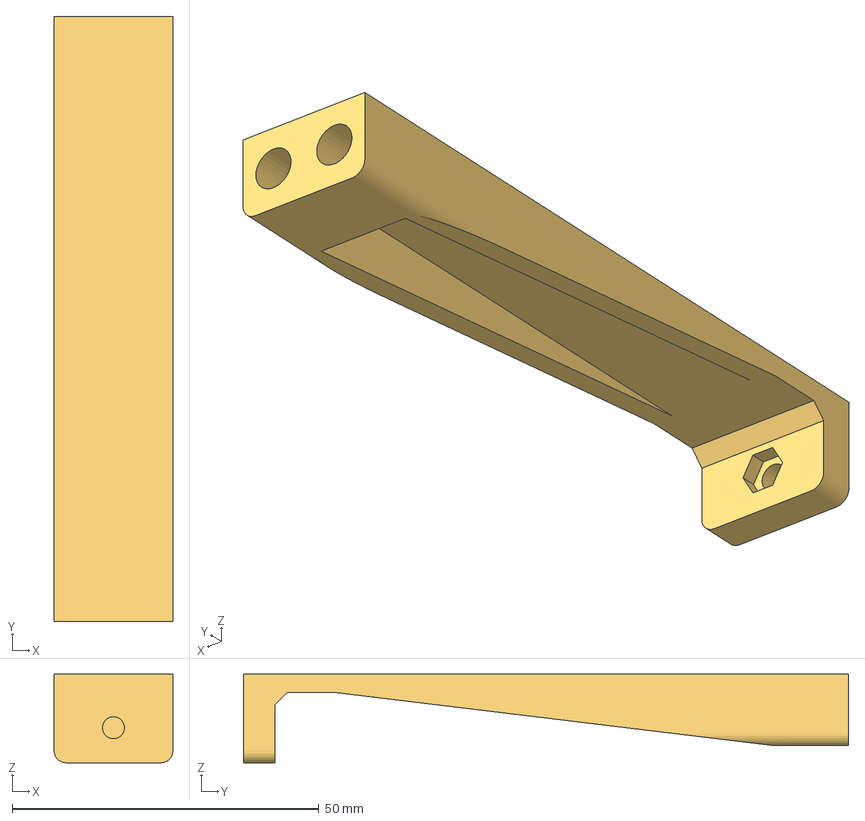
[picture p24: CAD file, 2026-07-29]
hardware/mechanical/fab/Cap Cradle/Cap Cradle Top Foot Rev A1.3mf
19.4 x 98.6 x 14.5 mm
