muJoseph/Emma-Mk1-DRSSTC/hardware/mechanical/fab/Cooling Fan Mount/Cooling Fan Mount B Rev A2.3mf

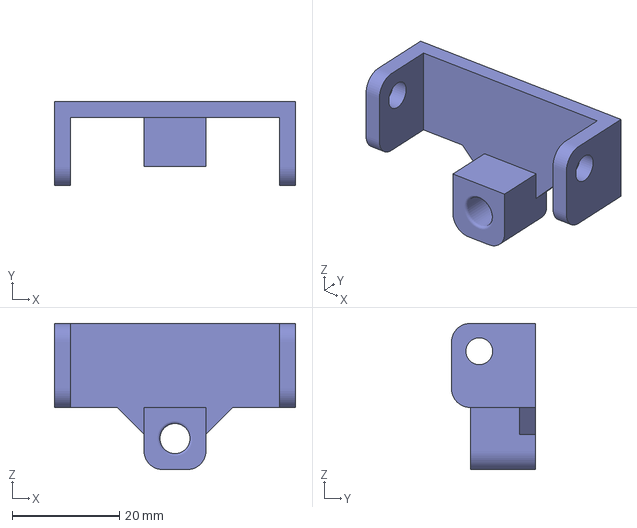
[picture p25: CAD file, 2026-07-29]
hardware/mechanical/fab/Cooling Fan Mount/Cooling Fan Mount B Rev A2.3mf
45.0 x 15.7 x 27.3 mm
