muJoseph/Emma-Mk1-DRSSTC/hardware/mechanical/fab/Ebox Back Hatch/Back Hatch Rev A2.3mf

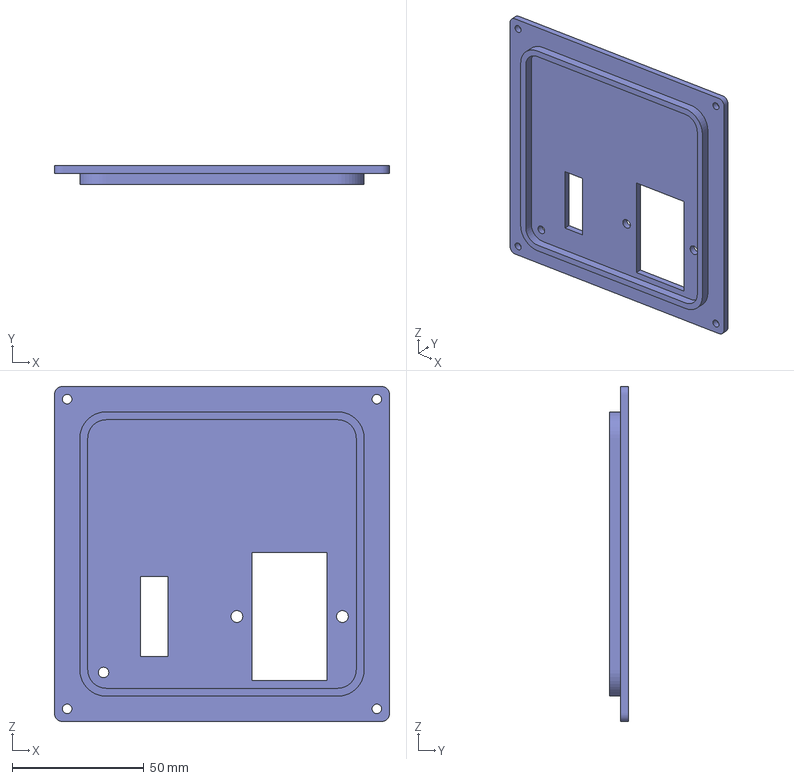
[picture p26: CAD file, 2026-07-29]
hardware/mechanical/fab/Ebox Back Hatch/Back Hatch Rev A2.3mf
127.0 x 7.17 x 127.0 mm
