muJoseph/Emma-Mk1-DRSSTC/hardware/mechanical/fab/Ebox Back/DRSSTC Alpha Ebox Back Rev A1.step

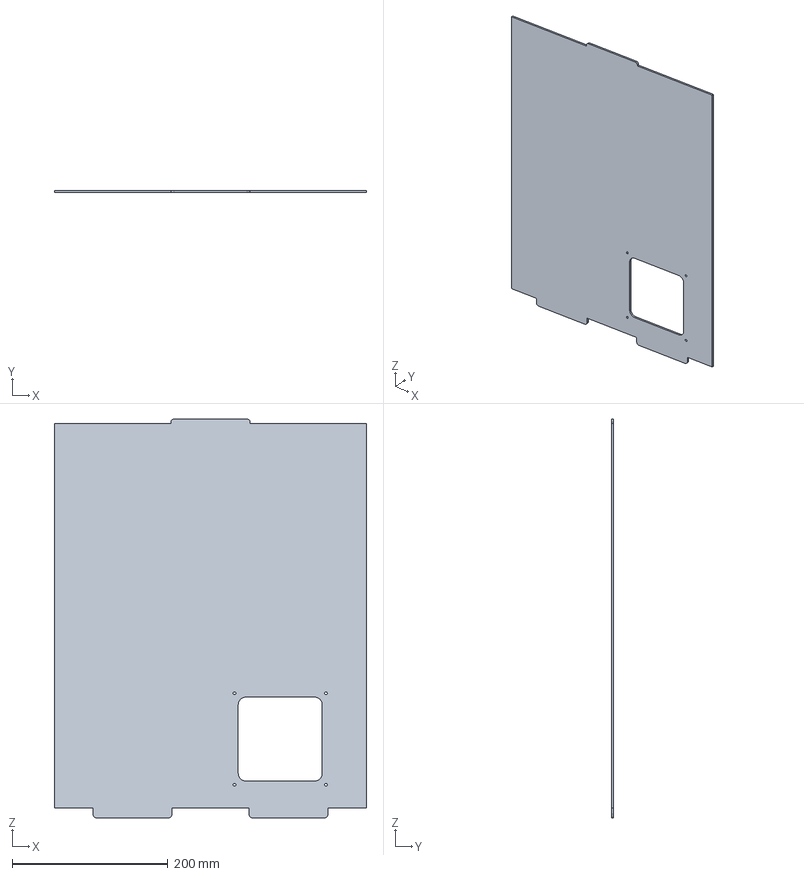
[picture p27: CAD file, 2026-07-29]
hardware/mechanical/fab/Ebox Back/DRSSTC Alpha Ebox Back Rev A1.step
400.6 x 3.18 x 512.1 mm
