muJoseph/Emma-Mk1-DRSSTC/hardware/mechanical/fab/Ebox Bottom/DRSSTC Alpha Ebox Bottom Rev A2.step

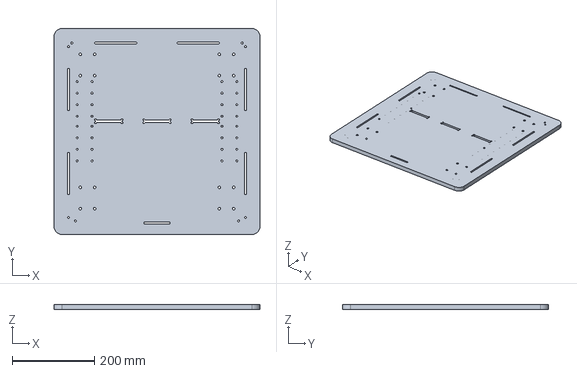
[picture p28: CAD file, 2026-07-29]
hardware/mechanical/fab/Ebox Bottom/DRSSTC Alpha Ebox Bottom Rev A2.step
500.0 x 500.0 x 12.7 mm
