muJoseph/Emma-Mk1-DRSSTC/hardware/mechanical/fab/Ebox Columns/Ebox BR Column/Ebox BR Column Top Rev A1.3mf

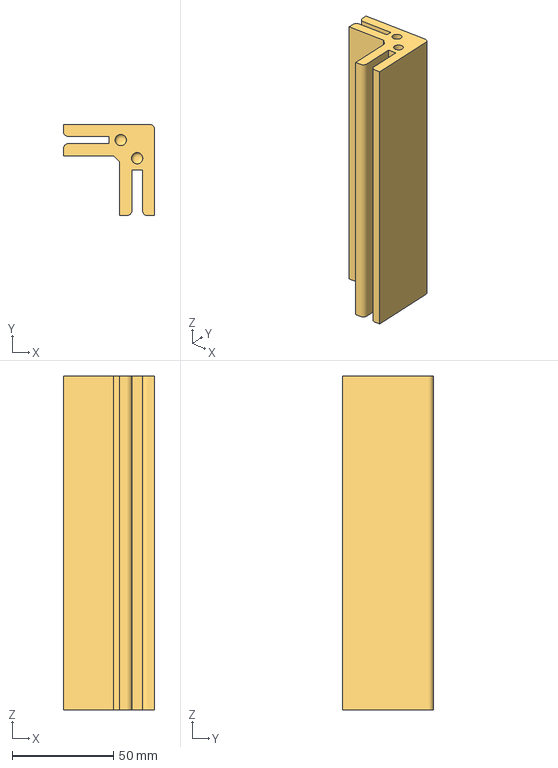
[picture p30: CAD file, 2026-07-29]
hardware/mechanical/fab/Ebox Columns/Ebox BR Column/Ebox BR Column Top Rev A1.3mf
45.0 x 45.0 x 164.7 mm
