muJoseph/Emma-Mk1-DRSSTC/hardware/mechanical/fab/Ebox Columns/Ebox FL Column/Ebox Column FL Top Rev A1.3mf

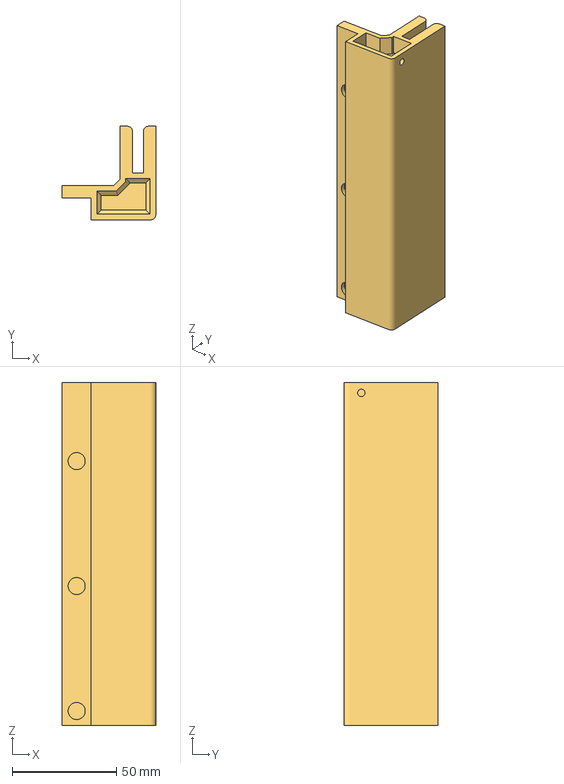
[picture p31: CAD file, 2026-07-29]
hardware/mechanical/fab/Ebox Columns/Ebox FL Column/Ebox Column FL Top Rev A1.3mf
45.0 x 45.0 x 164.7 mm
