muJoseph/Emma-Mk1-DRSSTC/hardware/mechanical/fab/Ebox Instrument Panel/Instrument Panel Rev A1.3mf

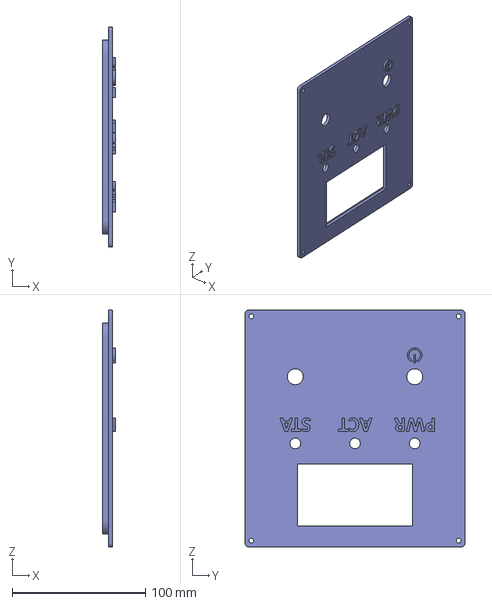
[picture p33: CAD file, 2026-07-29]
hardware/mechanical/fab/Ebox Instrument Panel/Instrument Panel Rev A1.3mf
9.50 x 165.1 x 177.8 mm
