muJoseph/Emma-Mk1-DRSSTC/hardware/mechanical/fab/Ebox Side Left/DRSSTC Alpha Ebox Left Rev A1.step

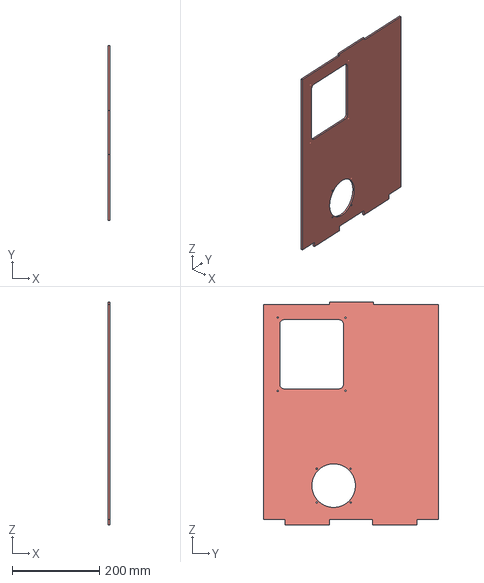
[picture p34: CAD file, 2026-07-29]
hardware/mechanical/fab/Ebox Side Left/DRSSTC Alpha Ebox Left Rev A1.step
4.50 x 401.4 x 511.7 mm
