muJoseph/Emma-Mk1-DRSSTC/hardware/mechanical/fab/Ebox Side Right/DRSSTC Alpha Ebox Right Rev A1.step

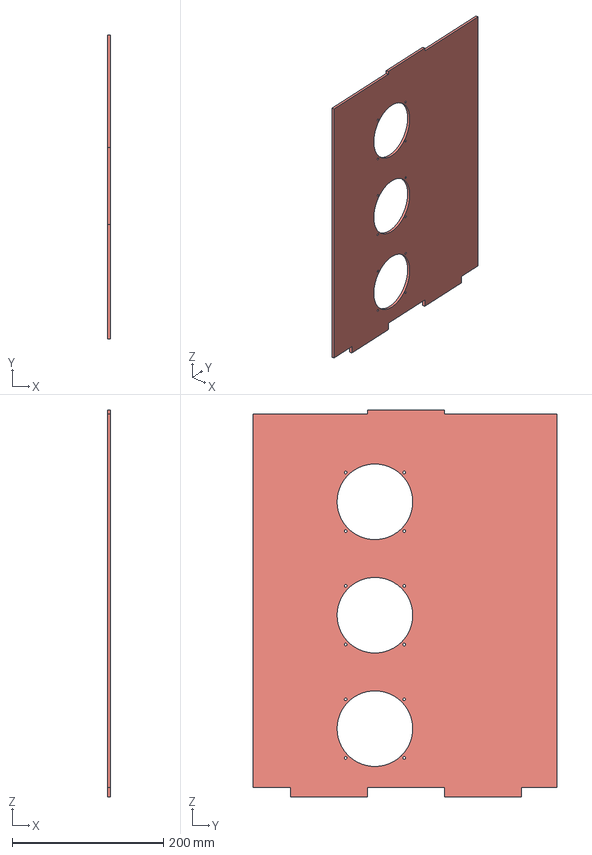
[picture p35: CAD file, 2026-07-29]
hardware/mechanical/fab/Ebox Side Right/DRSSTC Alpha Ebox Right Rev A1.step
4.50 x 401.4 x 511.7 mm
