muJoseph/Emma-Mk1-DRSSTC/hardware/mechanical/fab/Ebox Top Hatch/Ebox Top Hatch Rev A1.3mf

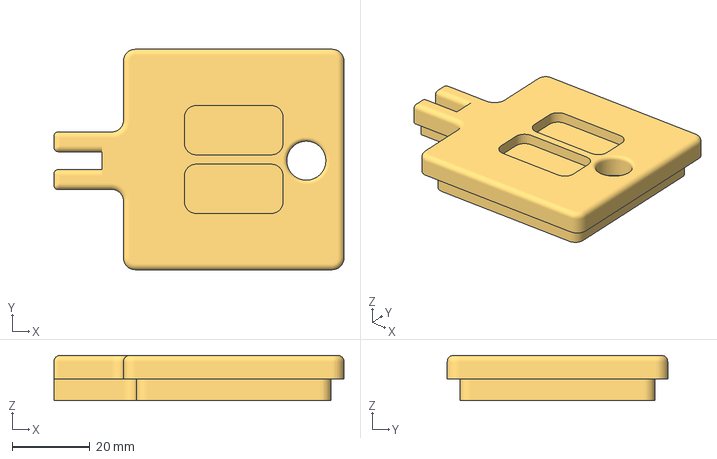
[picture p36: CAD file, 2026-07-29]
hardware/mechanical/fab/Ebox Top Hatch/Ebox Top Hatch Rev A1.3mf
74.7 x 56.8 x 11.6 mm
