muJoseph/Emma-Mk1-DRSSTC/hardware/mechanical/fab/MB Enclosure/DRSSTC MB Enclosure Standoff Rev A.3mf

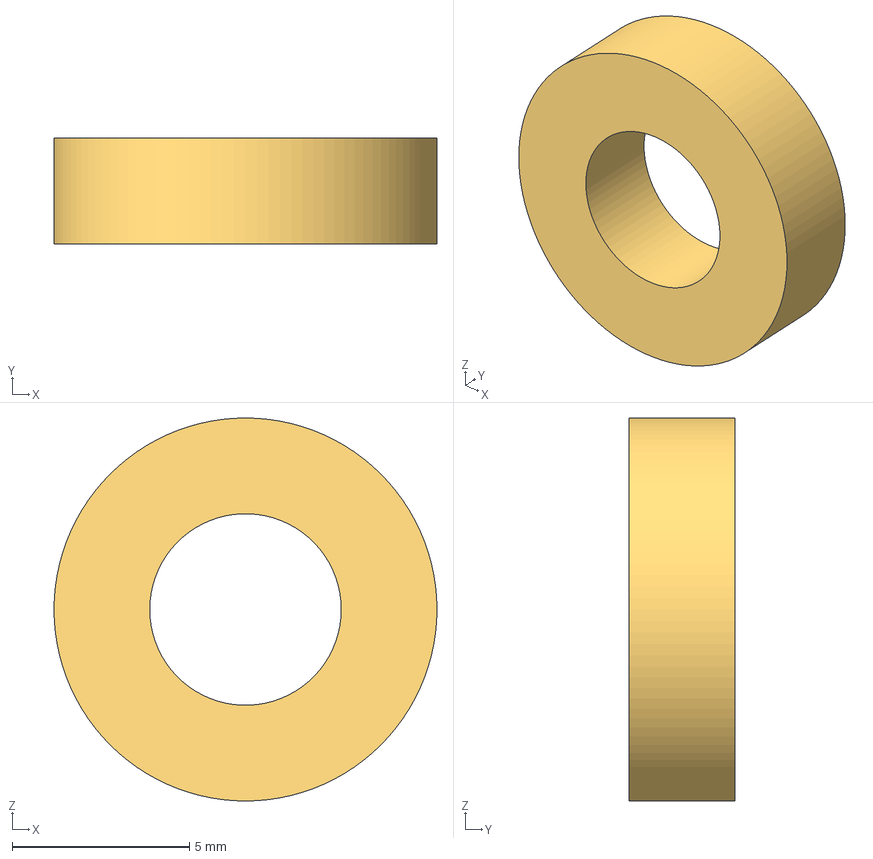
[picture p37: CAD file, 2026-07-29]
hardware/mechanical/fab/MB Enclosure/DRSSTC MB Enclosure Standoff Rev A.3mf
10.8 x 3.00 x 10.8 mm
