muJoseph/Emma-Mk1-DRSSTC/hardware/mechanical/fab/PCB Rack Mounts/PCB Rack Mount BR Rev A1.3mf

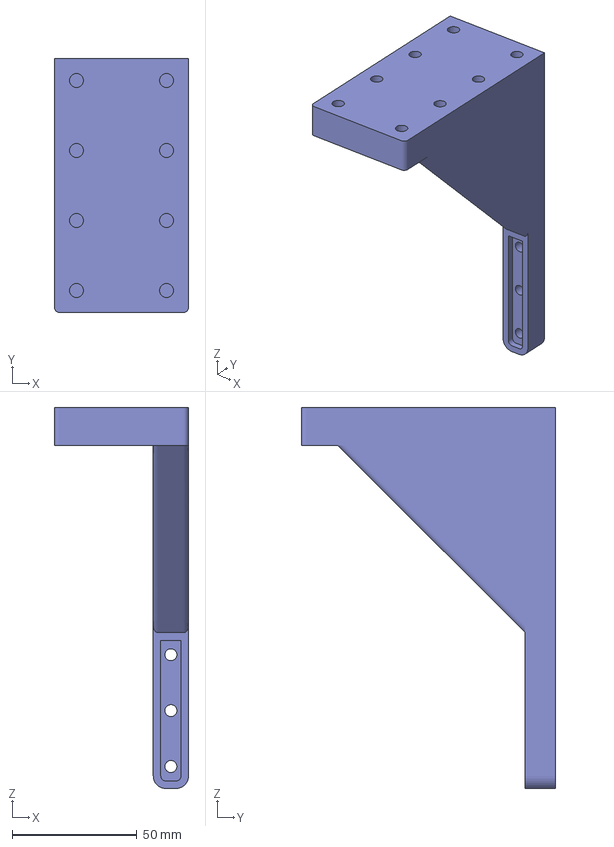
[picture p38: CAD file, 2026-07-29]
hardware/mechanical/fab/PCB Rack Mounts/PCB Rack Mount BR Rev A1.3mf
53.7 x 101.6 x 152.4 mm
