muJoseph/Emma-Mk1-DRSSTC/hardware/mechanical/fab/PCB Rack/DRSSTC Alpha PCB Rack Rev A1.step

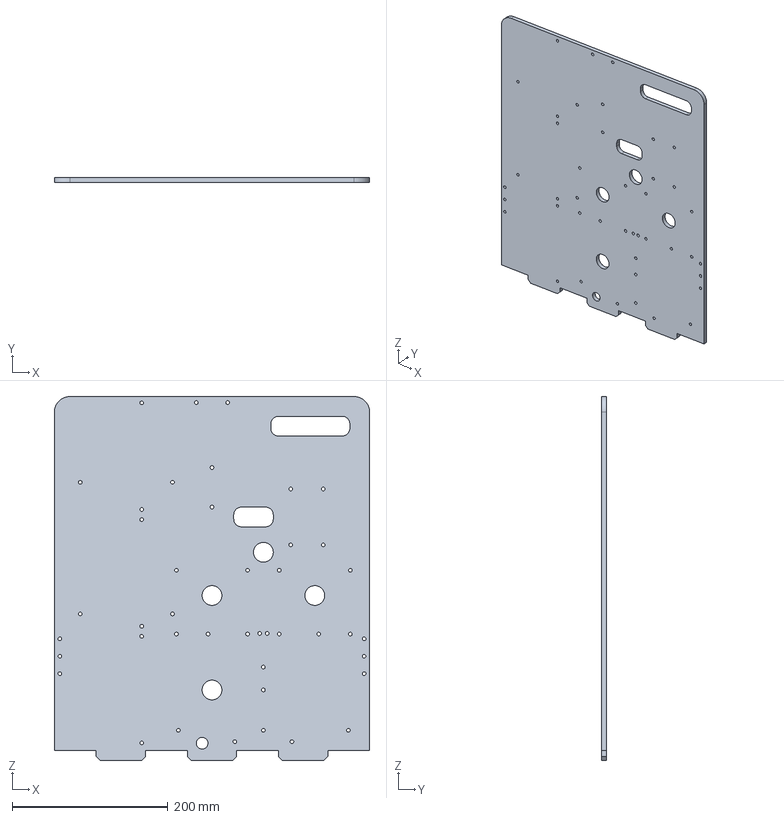
[picture p39: CAD file, 2026-07-29]
hardware/mechanical/fab/PCB Rack/DRSSTC Alpha PCB Rack Rev A1.step
405.1 x 6.73 x 467.7 mm
