muJoseph/Emma-Mk1-DRSSTC/hardware/mechanical/fab/PCB Standoffs/VDoubler PCB Standoff Rev A1.3mf

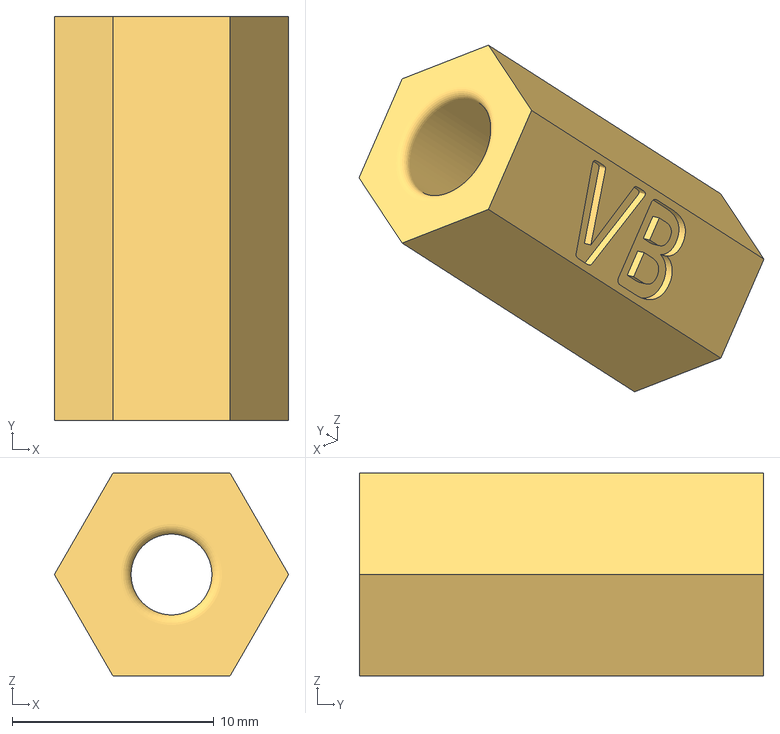
[picture p40: CAD file, 2026-07-29]
hardware/mechanical/fab/PCB Standoffs/VDoubler PCB Standoff Rev A1.3mf
11.6 x 20.0 x 10.0 mm
