muJoseph/Emma-Mk1-DRSSTC/hardware/mechanical/fab/Primary Coil Clamp/Pri Coil Clamp Bottom Jaw Rev A1.dxf

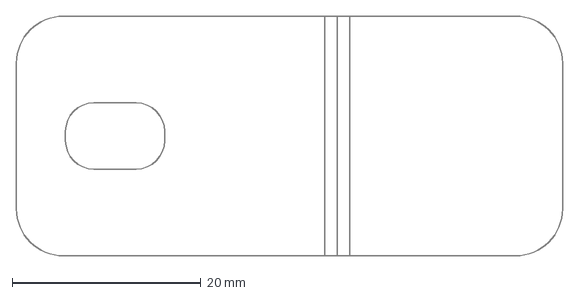
[picture p41: CAD file, 2026-07-29]
hardware/mechanical/fab/Primary Coil Clamp/Pri Coil Clamp Bottom Jaw Rev A1.dxf
57.8 x 25.4 mm
