muJoseph/Emma-Mk1-DRSSTC/hardware/mechanical/fab/Primary Coil Support Feet/Pri Coil Holder Foot NW Rev A1.3mf

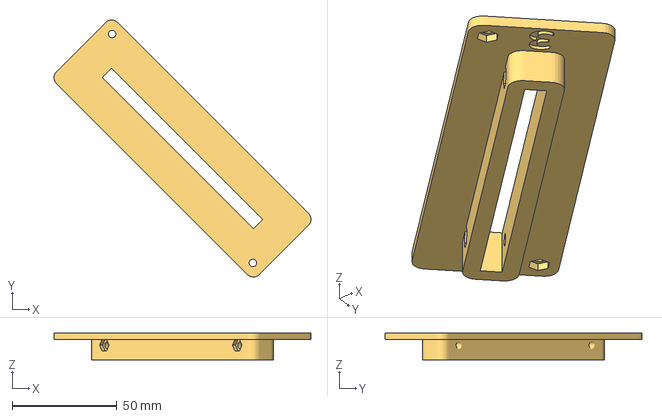
[picture p42: CAD file, 2026-07-29]
hardware/mechanical/fab/Primary Coil Support Feet/Pri Coil Holder Foot NW Rev A1.3mf
122.9 x 122.9 x 12.7 mm
