muJoseph/Emma-Mk1-DRSSTC/hardware/mechanical/fab/Primary Coil Supports/EmmaMk1_Pri_Coil_Holder_SE_Rev_A1.step

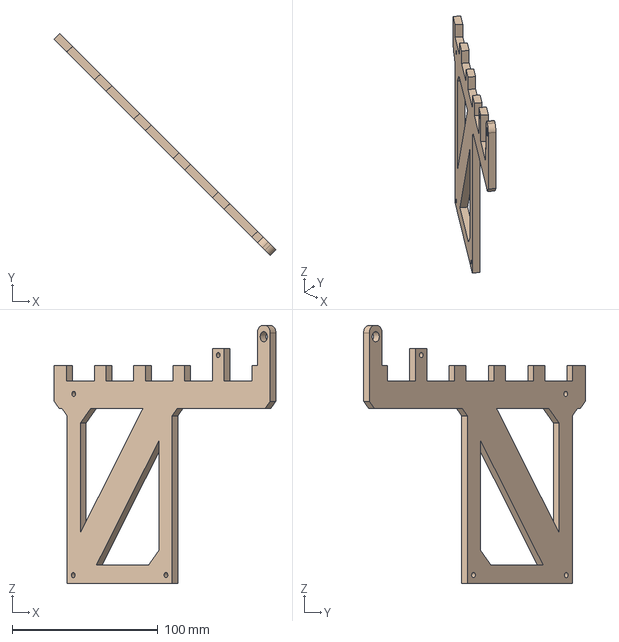
[picture p43: CAD file, 2026-10-23]
hardware/mechanical/fab/Primary Coil Supports/EmmaMk1_Pri_Coil_Holder_SE_Rev_A1.step
152.0 x 152.0 x 176.8 mm
