muJoseph/Emma-Mk1-DRSSTC/hardware/mechanical/fab/Primary Coil/Primary Coil.step

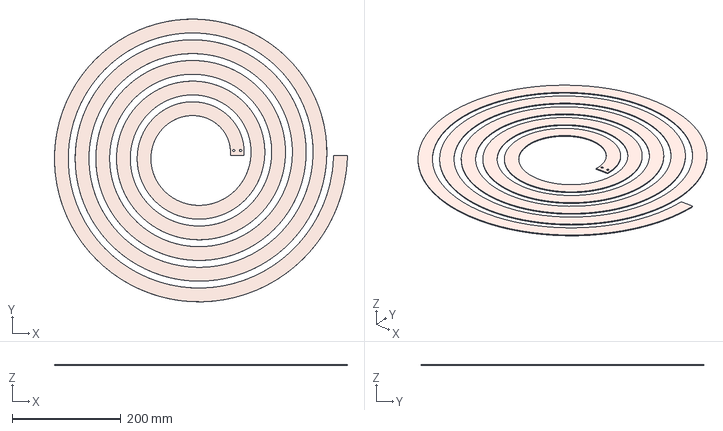
[picture p44: CAD file, 2026-10-07]
hardware/mechanical/fab/Primary Coil/Primary Coil.step
539.7 x 520.6 x 1.60 mm
