muJoseph/Emma-Mk1-DRSSTC/hardware/mechanical/fab/Secondary Coil Ground Lug/Sec Coil Gnd Lug Rev A2.3mf

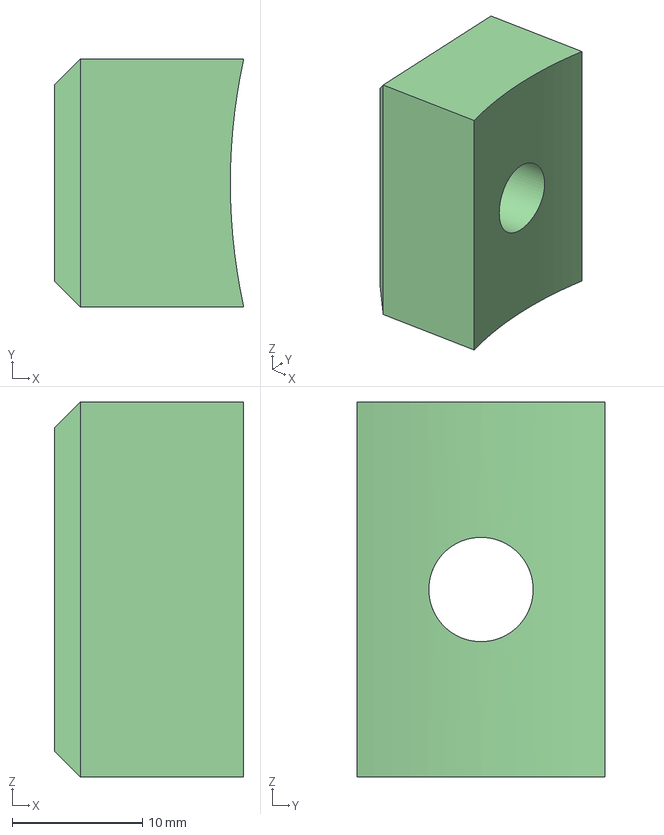
[picture p45: CAD file, 2026-07-29]
hardware/mechanical/fab/Secondary Coil Ground Lug/Sec Coil Gnd Lug Rev A2.3mf
14.5 x 19.0 x 28.8 mm
