muJoseph/Emma-Mk1-DRSSTC/hardware/mechanical/fab/Secondary Coil Holder Extension/Sec Coil Holder Extender Rev A5.3mf

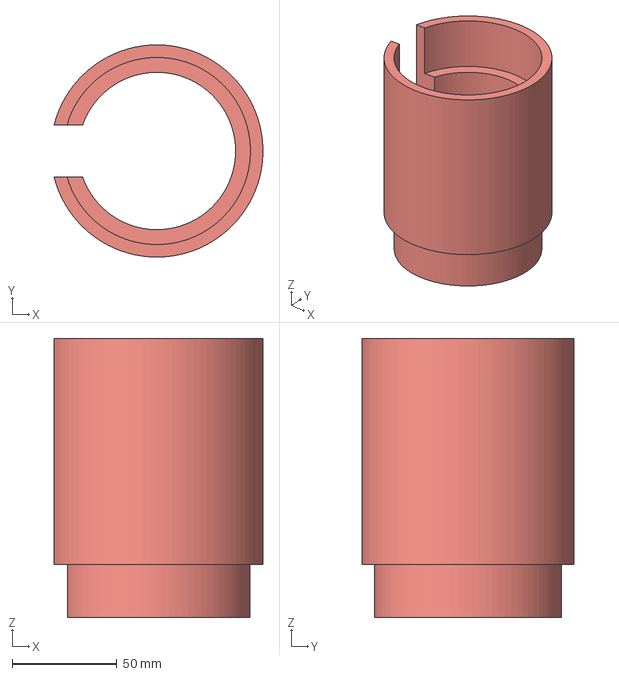
[picture p46: CAD file, 2026-10-09]
hardware/mechanical/fab/Secondary Coil Holder Extension/Sec Coil Holder Extender Rev A5.3mf
99.9 x 101.5 x 133.4 mm
