muJoseph/Emma-Mk1-DRSSTC/hardware/mechanical/fab/Secondary Coil Holder/Sec Coil Holder.3mf

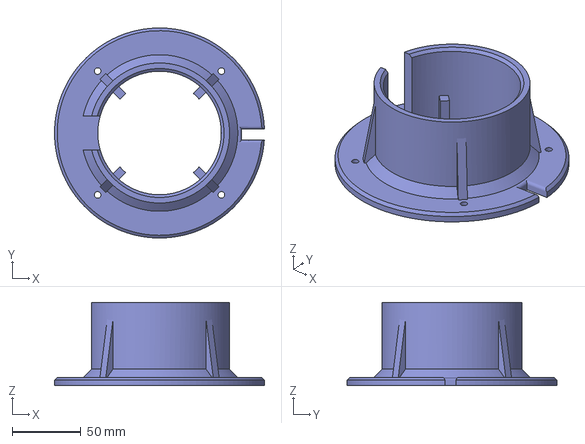
[picture p47: CAD file, 2026-10-07]
hardware/mechanical/fab/Secondary Coil Holder/Sec Coil Holder.3mf
152.2 x 152.3 x 60.3 mm
