muJoseph/Emma-Mk1-DRSSTC/hardware/mechanical/fab/Secondary Coil Sleeve/Sec Coil Sleeve Rev A2.3mf

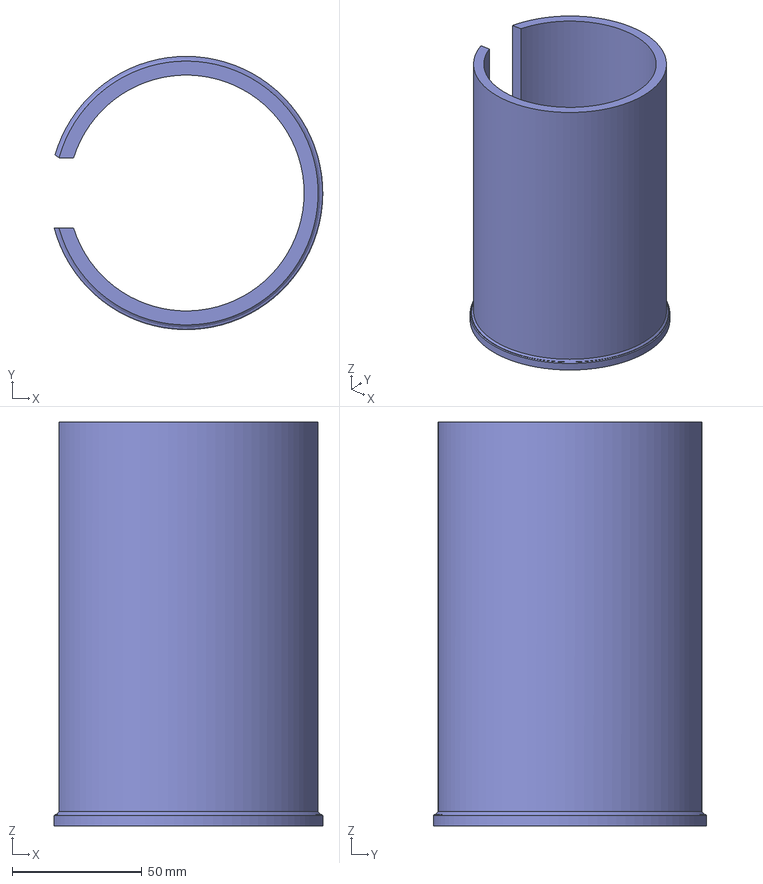
[picture p48: CAD file, 2026-10-07]
hardware/mechanical/fab/Secondary Coil Sleeve/Sec Coil Sleeve Rev A2.3mf
103.3 x 105.1 x 155.4 mm
