muJoseph/Emma-Mk1-DRSSTC/hardware/mechanical/fab/Strike Rail/Strike Rail Gnd Wire Lug Rev A1.3mf

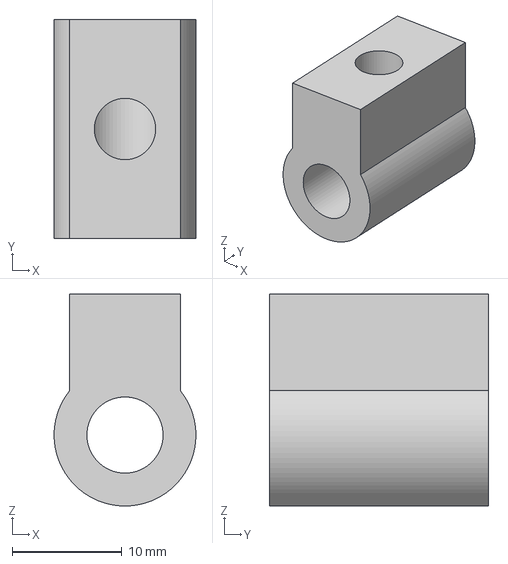
[picture p49: CAD file, 2026-07-29]
hardware/mechanical/fab/Strike Rail/Strike Rail Gnd Wire Lug Rev A1.3mf
12.9 x 20.0 x 19.3 mm
