muJoseph/Emma-Mk1-DRSSTC/hardware/mechanical/fab/Cap Cradle/Cap Cradle Bottom Foot Rev A1.3mf

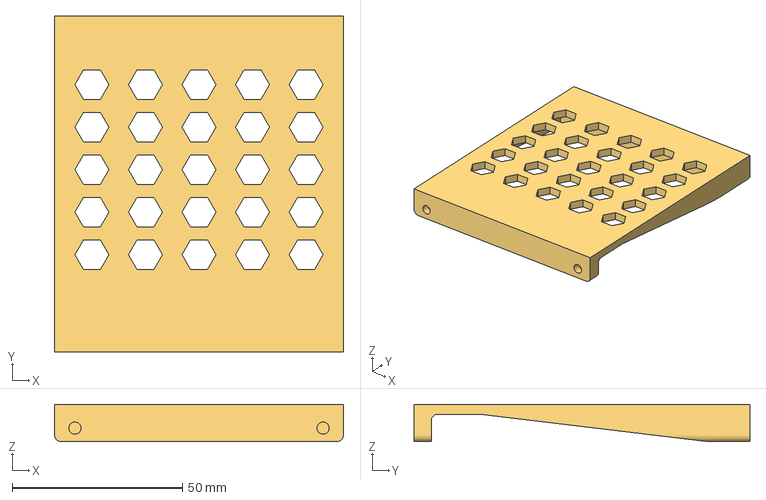
[picture p50: CAD file, 2026-07-29]
hardware/mechanical/fab/Cap Cradle/Cap Cradle Bottom Foot Rev A1.3mf
85.0 x 98.6 x 11.0 mm
