muJoseph/Emma-Mk1-DRSSTC/hardware/mechanical/fab/MB Enclosure/MB Enclosure Lid Shim Rev A1.3mf

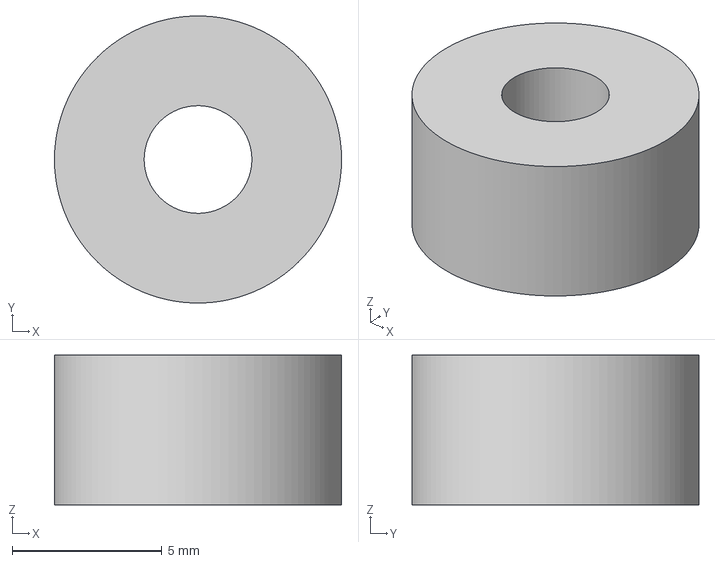
[picture p51: CAD file, 2026-07-29]
hardware/mechanical/fab/MB Enclosure/MB Enclosure Lid Shim Rev A1.3mf
9.60 x 9.60 x 5.00 mm
