muJoseph/Emma-Mk1-DRSSTC/hardware/mechanical/fab/Primary Coil Clamp/Pri Coil Clamp Top Jaw Rev A1.dxf

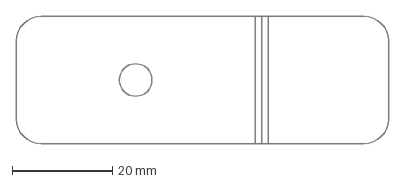
[picture p52: CAD file, 2026-07-29]
hardware/mechanical/fab/Primary Coil Clamp/Pri Coil Clamp Top Jaw Rev A1.dxf
74.4 x 25.4 mm
