muJoseph/Emma-Mk1-DRSSTC/hardware/mechanical/fab/Secondary Coil Holder Extension/Sec Coil Holder Extender Rev A4.3mf

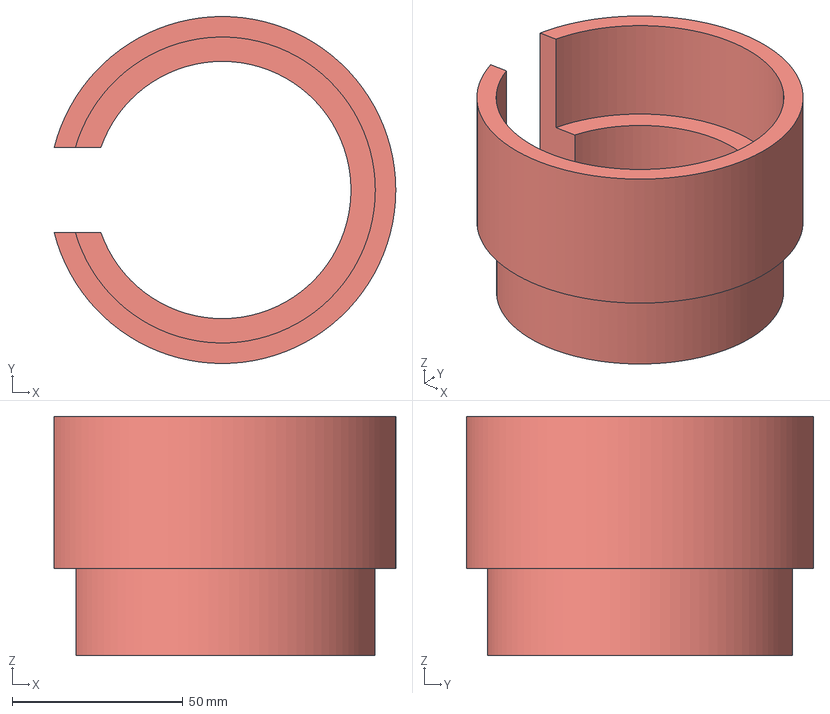
[picture p53: CAD file, 2026-10-09]
hardware/mechanical/fab/Secondary Coil Holder Extension/Sec Coil Holder Extender Rev A4.3mf
99.9 x 101.5 x 69.9 mm
