muJoseph/Emma-Mk1-DRSSTC/hardware/mechanical/fab/Strike Rail/Strike Rail Terminal Rev A1.3mf

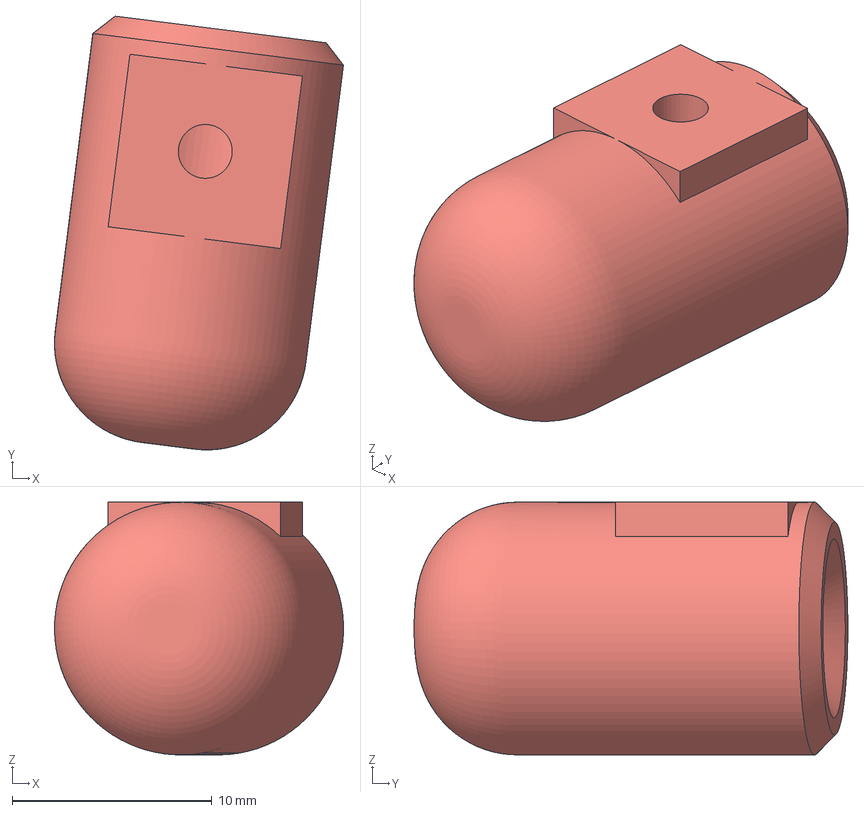
[picture p54: CAD file, 2026-07-29]
hardware/mechanical/fab/Strike Rail/Strike Rail Terminal Rev A1.3mf
14.5 x 21.7 x 12.6 mm
