muJoseph/Emma-Mk1-DRSSTC/hardware/mechanical/fab/Cap Cradle/Capacitor Cradle Top Rev A1.3mf

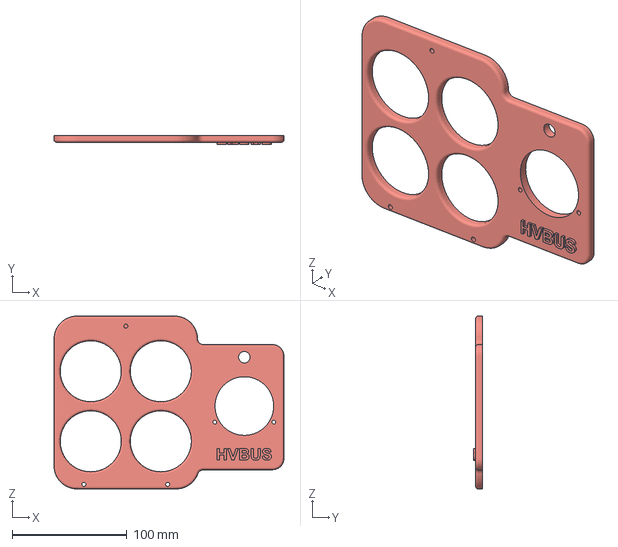
[picture p55: CAD file, 2026-07-29]
hardware/mechanical/fab/Cap Cradle/Capacitor Cradle Top Rev A1.3mf
200.1 x 8.00 x 150.4 mm
