muJoseph/Emma-Mk1-DRSSTC/hardware/mechanical/fab/Cooling Fan Mount/Cooling Fan Mount B Rev A1.3mf

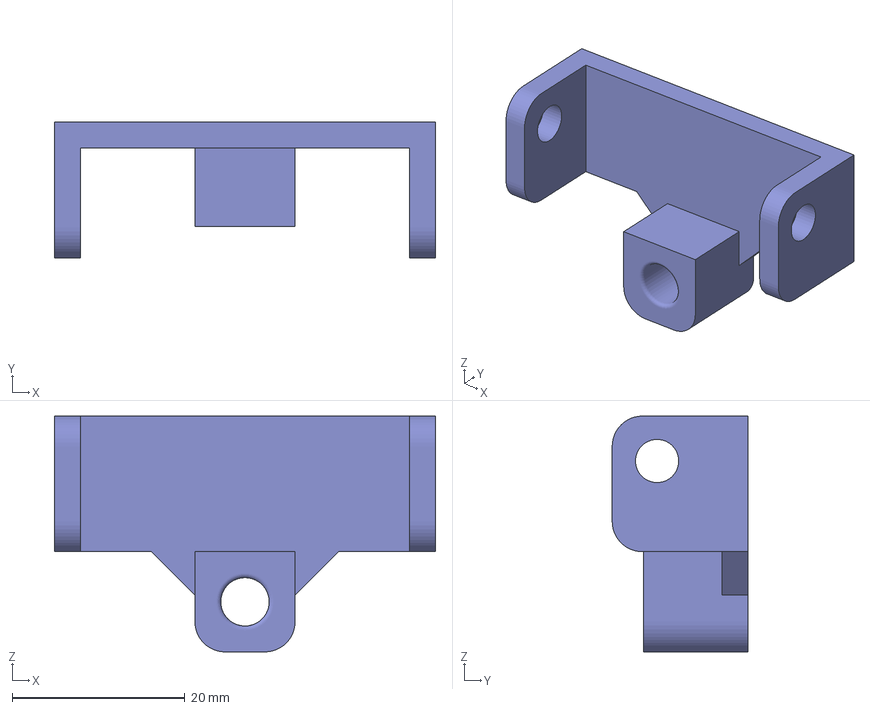
[picture p56: CAD file, 2026-07-29]
hardware/mechanical/fab/Cooling Fan Mount/Cooling Fan Mount B Rev A1.3mf
44.1 x 15.7 x 27.3 mm
