muJoseph/Emma-Mk1-DRSSTC/hardware/mechanical/fab/Ebox Columns/Ebox BL Column/Ebox BL Column Mid Rev A1.3mf

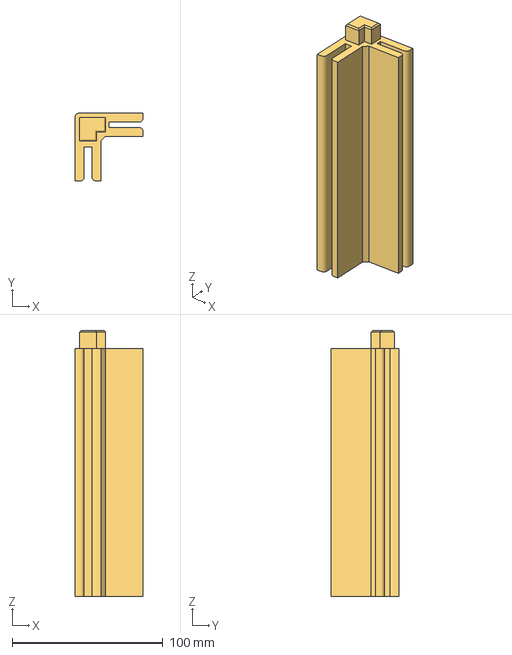
[picture p57: CAD file, 2026-07-29]
hardware/mechanical/fab/Ebox Columns/Ebox BL Column/Ebox BL Column Mid Rev A1.3mf
45.0 x 45.0 x 176.7 mm
