muJoseph/Emma-Mk1-DRSSTC/hardware/mechanical/fab/Secondary Coil Holder Extension/Sec Coil Holder Extender Rev A1.3mf

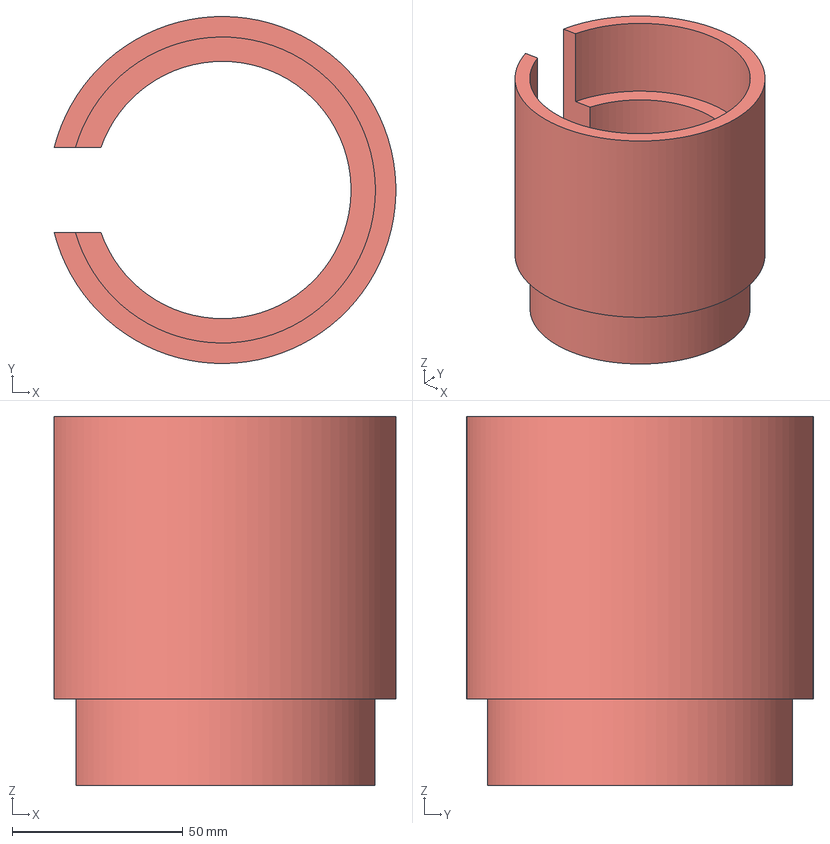
[picture p59: CAD file, 2026-10-07]
hardware/mechanical/fab/Secondary Coil Holder Extension/Sec Coil Holder Extender Rev A1.3mf
99.9 x 101.5 x 108.0 mm
