muJoseph/Emma-Mk1-DRSSTC/hardware/mechanical/fab/MB Enclosure/RPI Standoff Rev A1.3mf

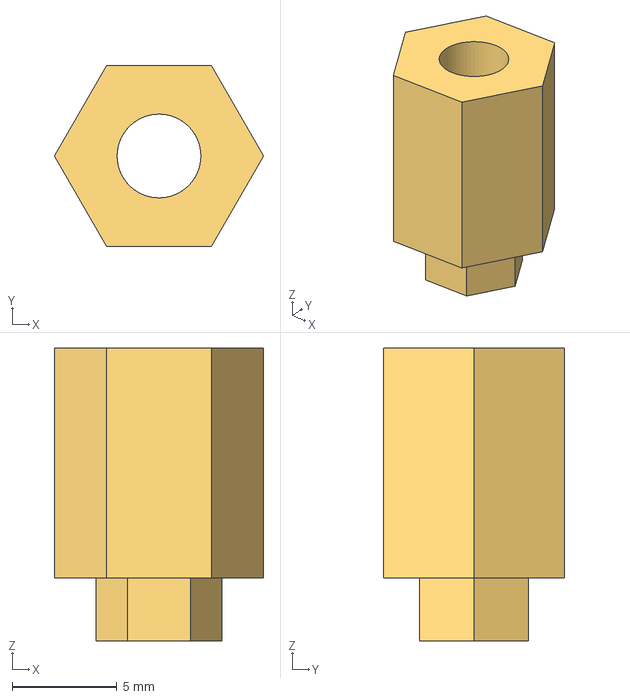
[picture p60: CAD file, 2026-07-29]
hardware/mechanical/fab/MB Enclosure/RPI Standoff Rev A1.3mf
10.0 x 8.66 x 14.0 mm
