muJoseph/Emma-Mk1-DRSSTC/hardware/mechanical/fab/PCB Rack Mounts/PCB Rack Kickstand Rev A1.3mf

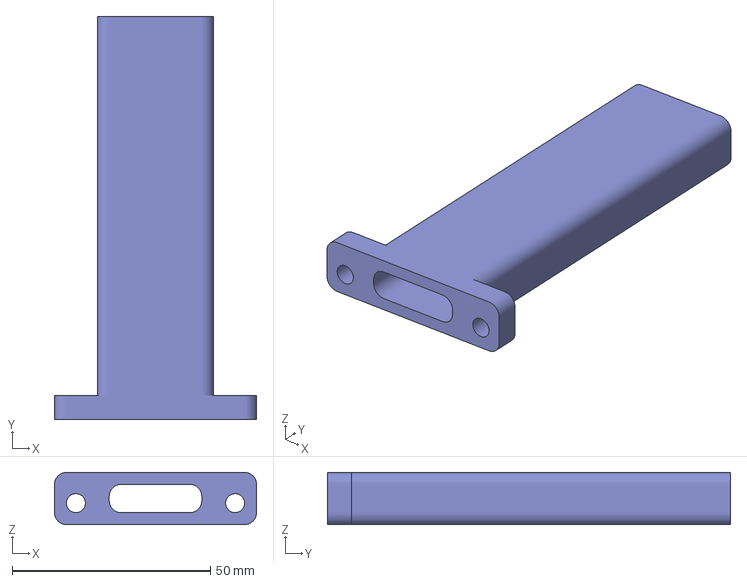
[picture p61: CAD file, 2026-07-29]
hardware/mechanical/fab/PCB Rack Mounts/PCB Rack Kickstand Rev A1.3mf
50.9 x 101.6 x 13.2 mm
