muJoseph/Emma-Mk1-DRSSTC/hardware/mechanical/fab/PCB Standoffs/HB Standoff Rev A1.3mf

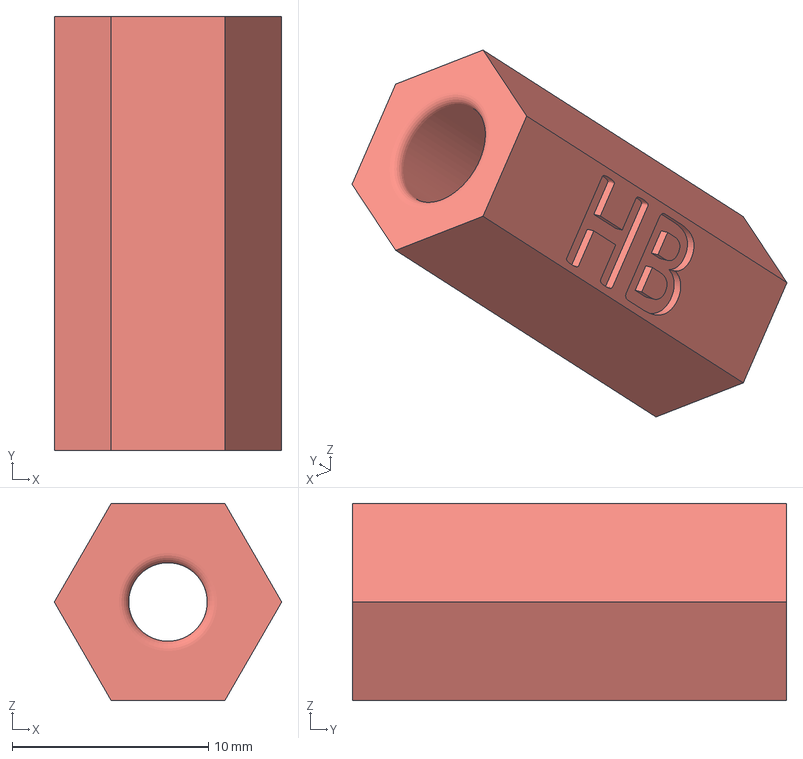
[picture p62: CAD file, 2026-07-29]
hardware/mechanical/fab/PCB Standoffs/HB Standoff Rev A1.3mf
11.6 x 22.1 x 10.0 mm
