muJoseph/Emma-Mk1-DRSSTC/hardware/mechanical/fab/Secondary Coil Holder Extension/Sec Coil Holder Extender Rev A3.3mf

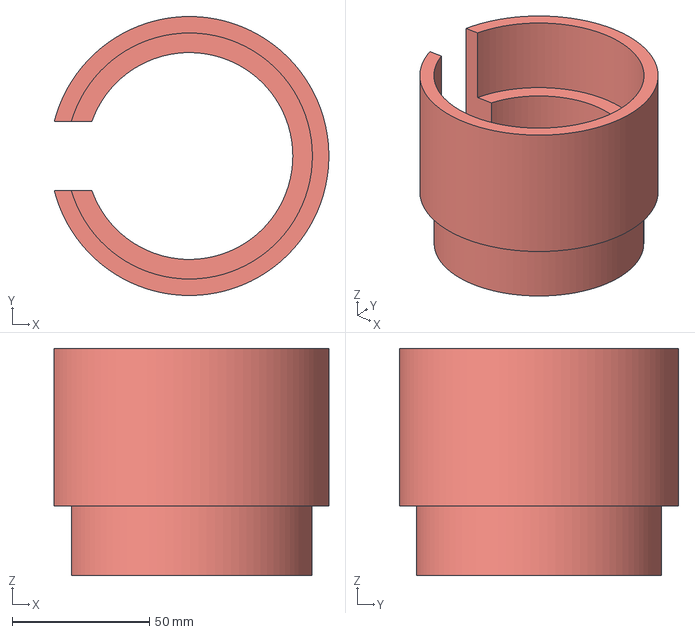
[picture p63: CAD file, 2026-10-07]
hardware/mechanical/fab/Secondary Coil Holder Extension/Sec Coil Holder Extender Rev A3.3mf
99.9 x 101.5 x 82.6 mm
