muJoseph/Emma-Mk1-DRSSTC/hardware/mechanical/fab/Secondary Coil Holder Extension/Sec Coil Holder Extender Rev A2.3mf

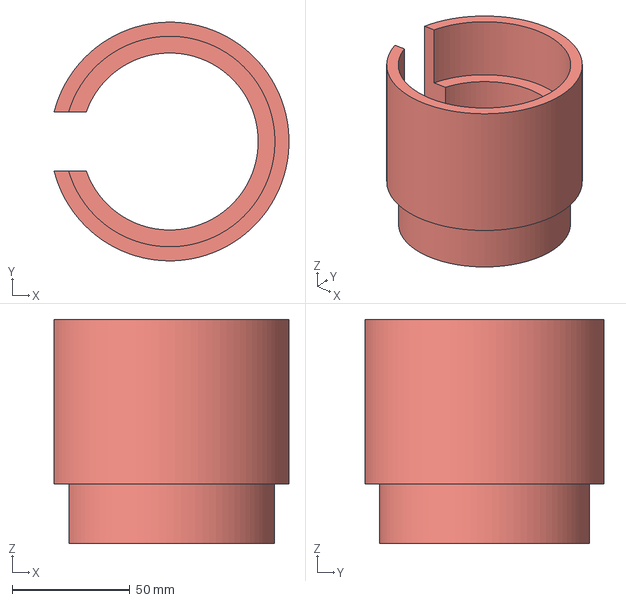
[picture p64: CAD file, 2026-10-07]
hardware/mechanical/fab/Secondary Coil Holder Extension/Sec Coil Holder Extender Rev A2.3mf
99.9 x 101.5 x 95.3 mm
