muJoseph/Emma-Mk1-DRSSTC/(list of files, cad)

Other CAD files:
hardware/mechanical/fab/Cooling Fan Mount/Cooling Fan Mount T Rev A2.3mf
hardware/mechanical/fab/Ebox Columns/Ebox BL Column/Ebox BL Column Bottom Rev A1 Project.3mf
hardware/mechanical/fab/Ebox Columns/Ebox BR Column/Ebox BR Column Bottom Rev A1.3mf
hardware/mechanical/fab/Ebox Columns/Ebox FL Column/Ebox Column FL Middle Rev A1.3mf
hardware/mechanical/fab/Ebox Columns/Ebox FR Column/Ebox Column FR Top Rev A1.3mf
hardware/mechanical/fab/PCB Rack Mounts/PCB Rack Mount FR Rev A1.3mf
hardware/mechanical/fab/Primary Coil Support Feet/Pri Coil Holder Foot SW Rev A1.3mf
hardware/mechanical/fab/Primary Coil Supports/EmmaMk1_Pri_Coil_Holder_NE_Rev_A1.step
hardware/mechanical/fab/Ebox Columns/Ebox BR Column/Ebox BR Column Mid Rev A1.3mf
hardware/mechanical/fab/Ebox Columns/Ebox FL Column/Ebox Column FL Bottom Rev A1.3mf
hardware/mechanical/fab/Ebox Columns/Ebox FR Column/Ebox Column FR Bottom Rev A1.3mf
hardware/mechanical/fab/PCB Rack Mounts/PCB Rack Mount FL Rev A1.3mf
hardware/mechanical/fab/PCB Standoffs/MMC Bank PCB Standoff Rev A1.3mf
hardware/mechanical/fab/Primary Coil Support Feet/Pri Coil Holder Foot SE Rev A1.3mf
hardware/mechanical/fab/Primary Coil Supports/EmmaMk1_Pri_Coil_Holder_NW_Rev_A1.step
hardware/mechanical/fab/Cooling Fan Mount/Cooling Fan Mount T Rev A1.3mf
hardware/mechanical/fab/Ebox Columns/Ebox BL Column/Ebox BL Column Top Rev A1.3mf
hardware/mechanical/fab/Primary Coil Support Feet/Pri Coil Holder Foot NE Rev A1.3mf
hardware/mechanical/fab/Primary Coil Supports/EmmaMk1_Pri_Coil_Holder_SW_Rev_A1.step
hardware/mechanical/fab/PCB Rack Mounts/PCB Rack Mount BL Rev A1.3mf
hardware/mechanical/fab/PCB Standoffs/CS PCB Standoff Rev A1.3mf
