muJoseph/Emma-Mk1-DRSSTC/hardware/electrical/img/hv-pcbs-isolated-assembly-front.png

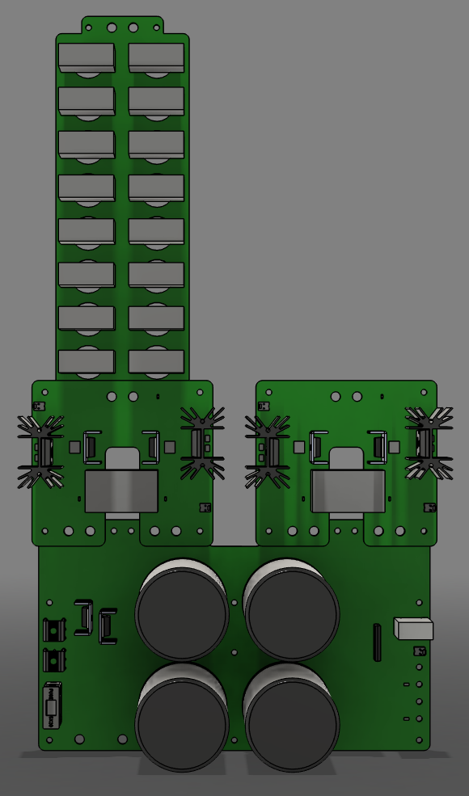
hardware/electrical/img/hv-pcbs-isolated-assembly-front.png
