muJoseph/Emma-Mk1-DRSSTC/hardware/electrical/Emma Mk1 DRSSTC MMC Bank Rev B/SCHEM-Emma Mk1 DRSSTC MMC Bank Rev B.pdf

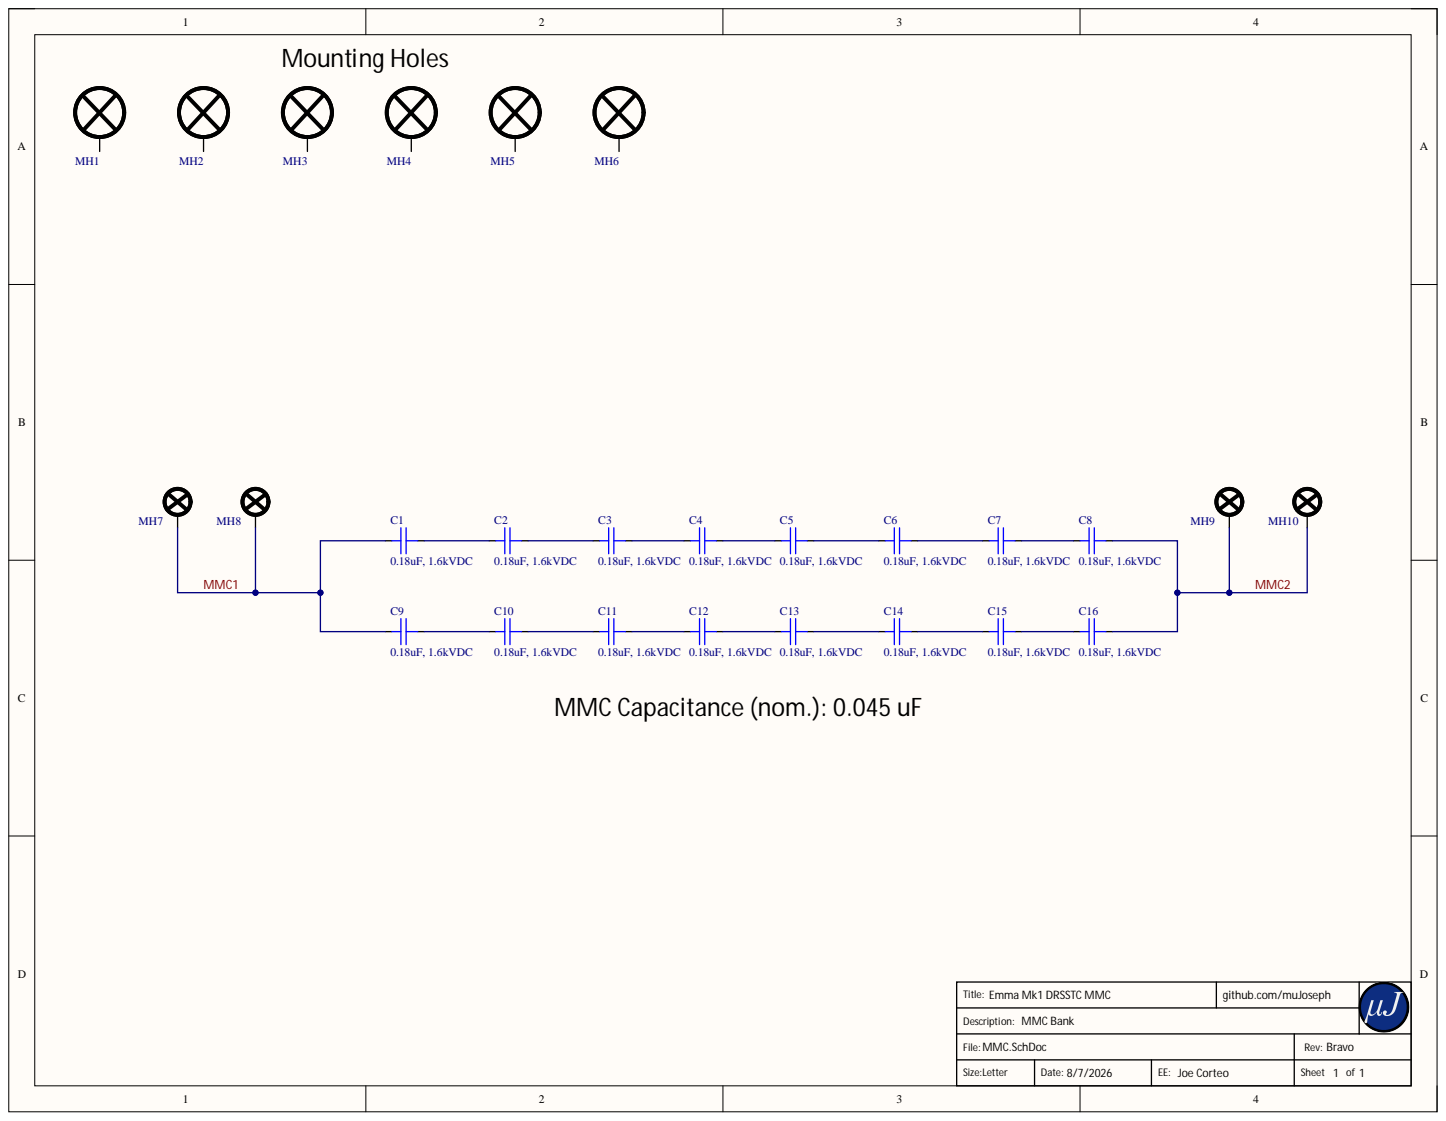
[picture p66: page 1]

0.18uF, 1.6kVDC
MMC Capacitance (nom.): 0.045 uF

Title: Emma Mk1 DRSSTC MMC

MMC.SchDoc File: | Rev: Bravo

Size: Letter | Date: 8/7/2026 | EE: Joe Corteo | Sheet 1 of 1

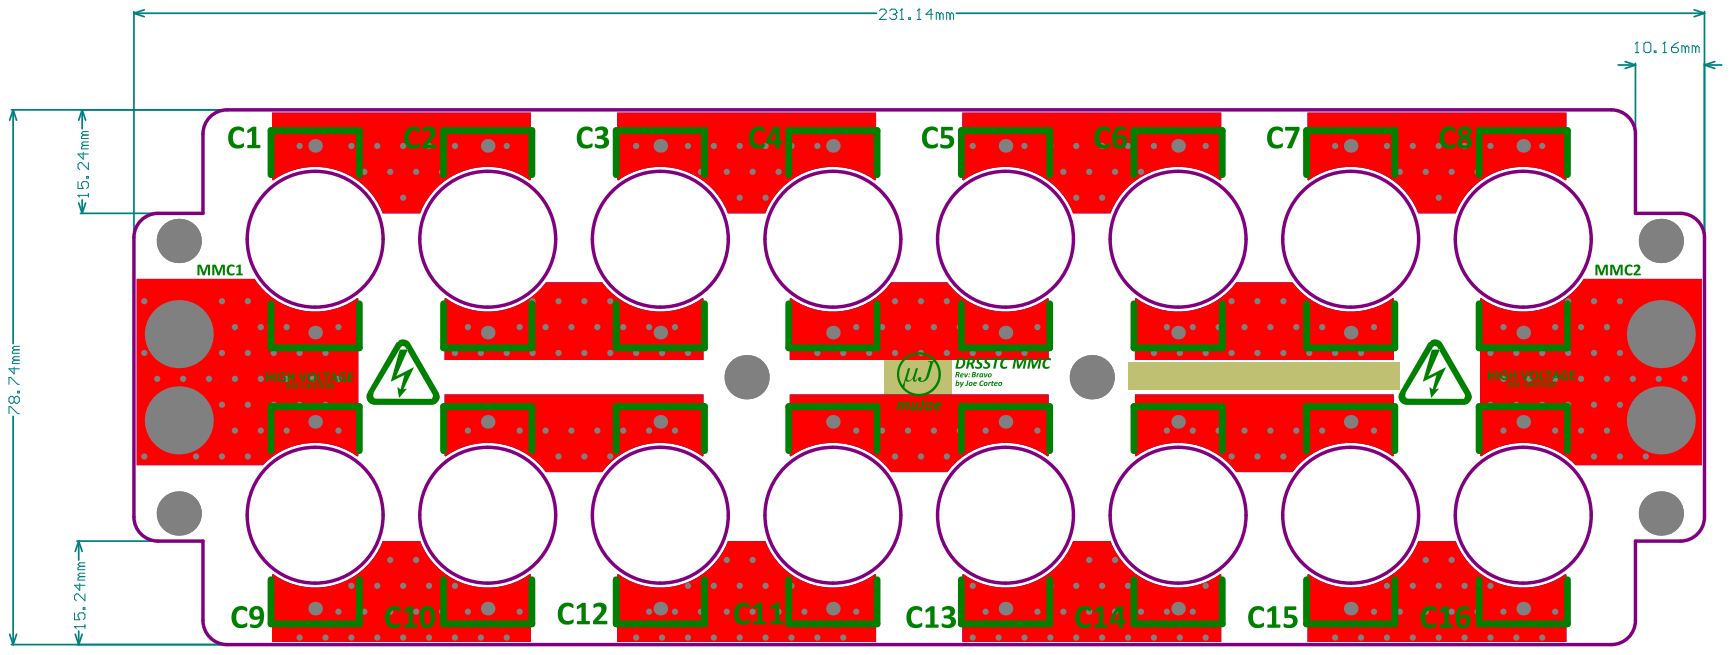
[picture p67: page 2]
