muJoseph/Emma-Mk1-DRSSTC/hardware/electrical/Emma Mk1 DRSSTC GDT Driver Rev D/SCHEM-Emma Mk1 DRSSTC GDT Driver Rev D.pdf

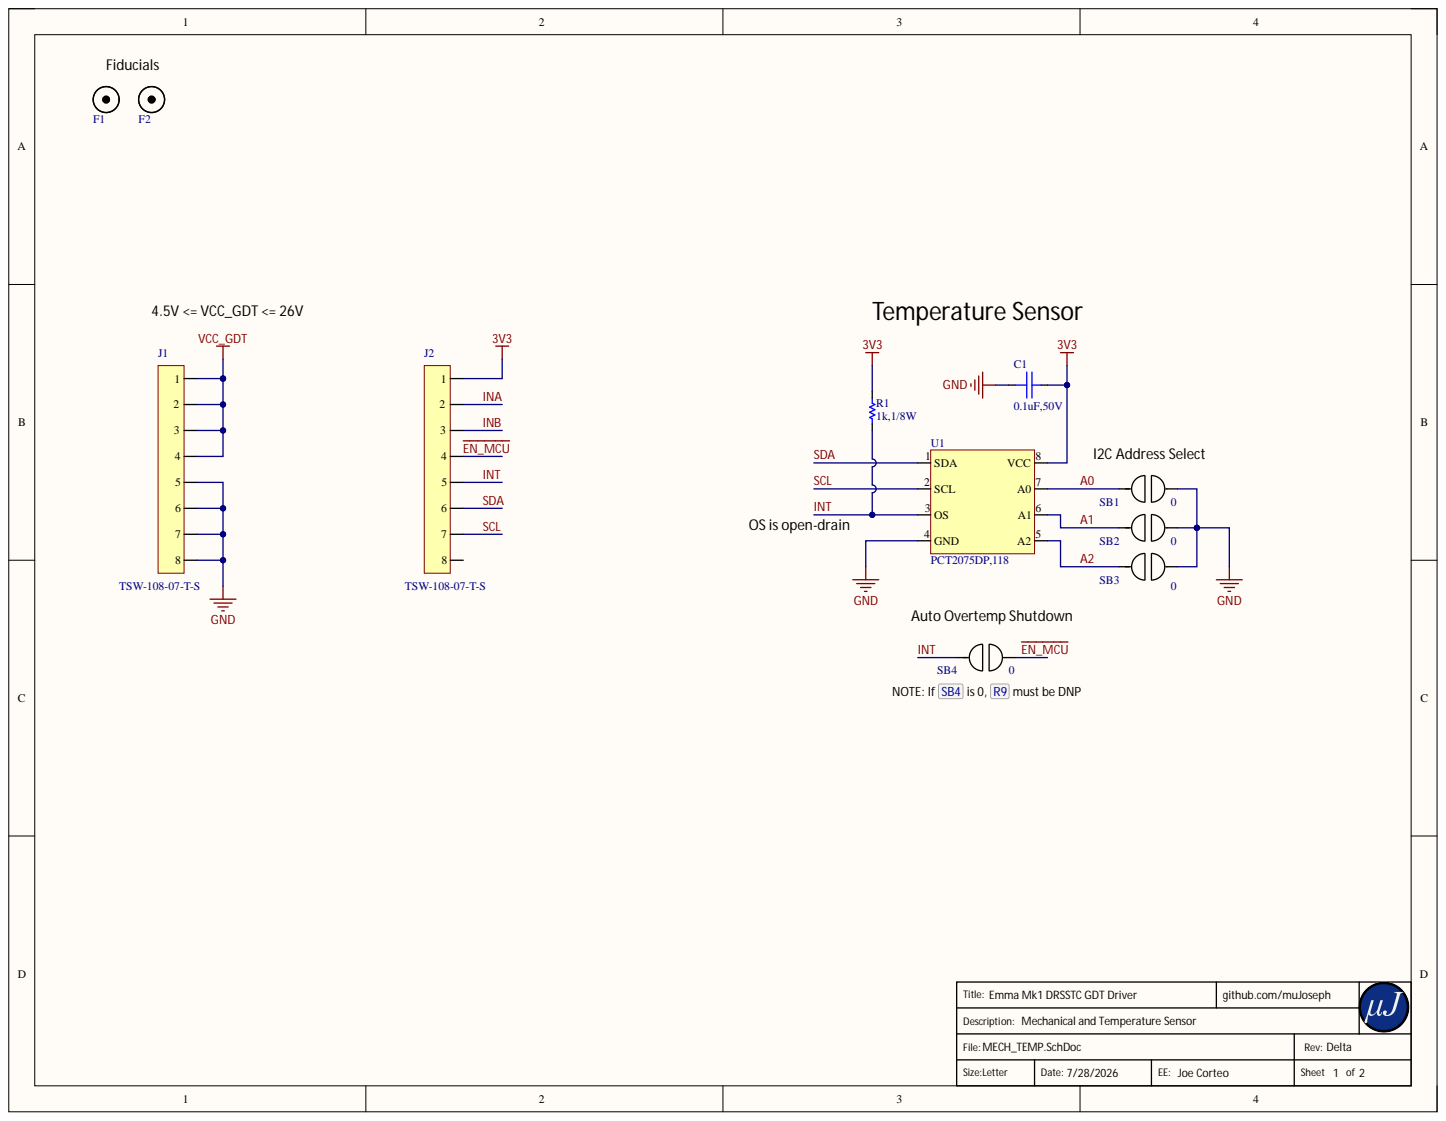
[picture p68: page 1]

OS is open-drain

NOTE: If SB4 is 0, R9 must be DNP

Mechanical and Temperature Sensor
ion:

MECH_TEMP.SchDoc | Rev: Delta

Size: Let ter | 7/28/2026 | 1 of 2

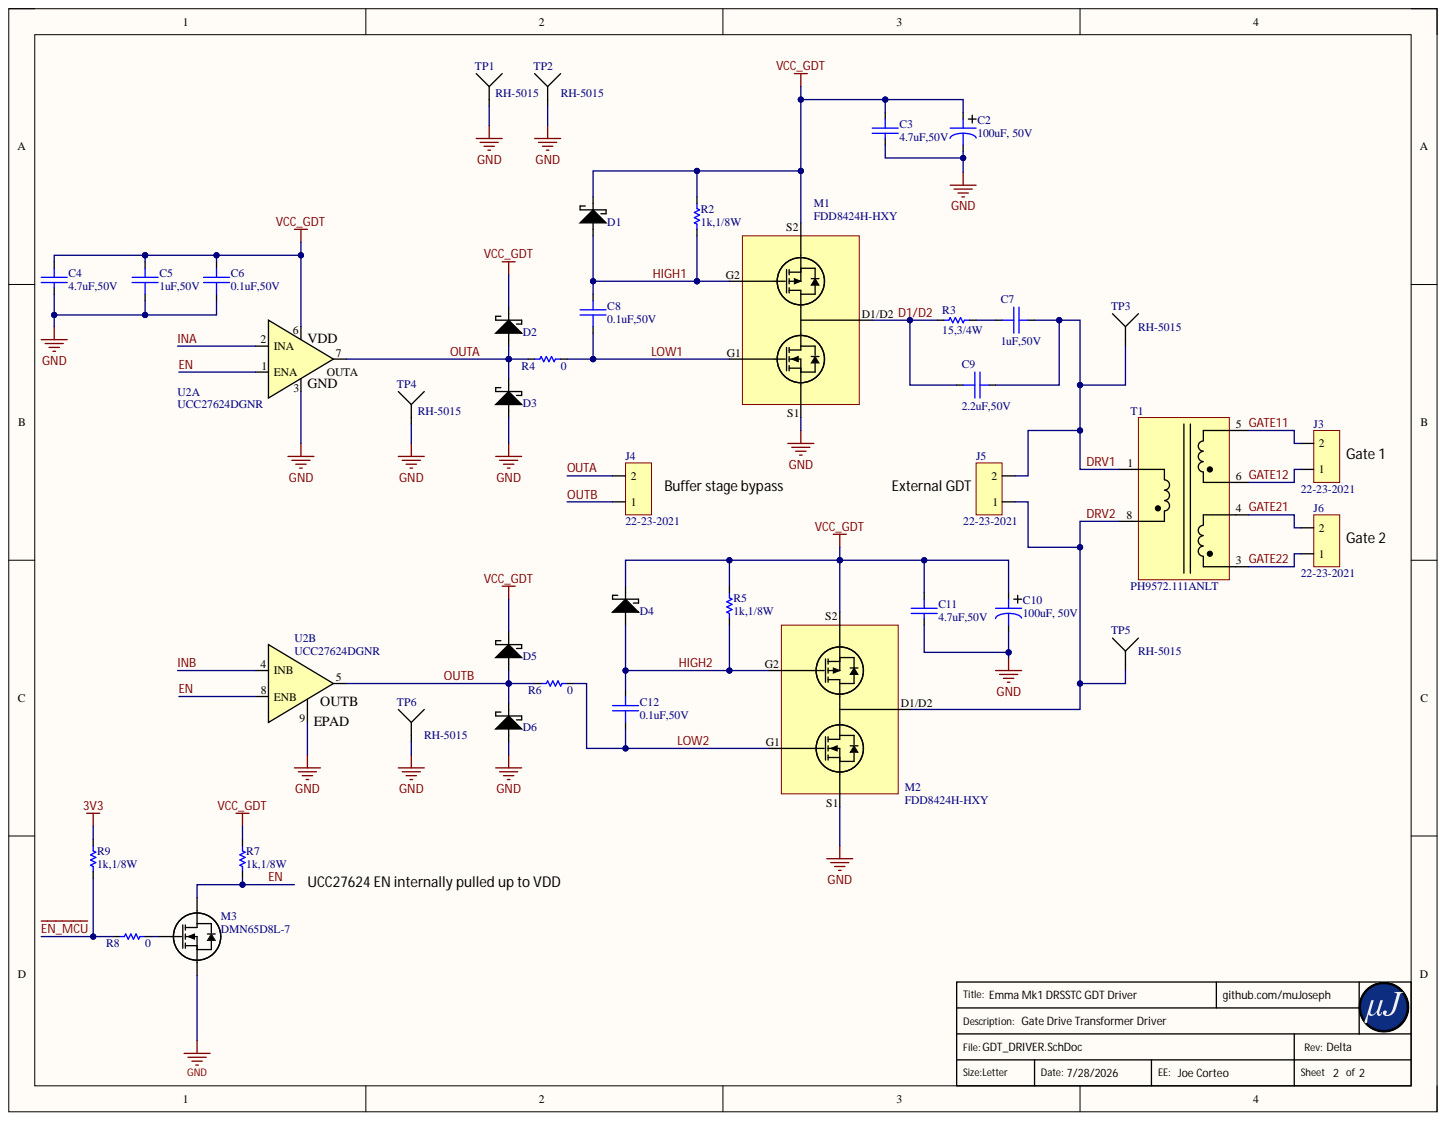
[picture p69: page 2]

Title: Emma Mk1 DRSSTC GDT Driver

Gate Drive Transformer Driver

GDT_DRIVER.SchDoc File: | Rev: Delta

Size: Letter | Date: 7/28/2026 | EE: Joe Corteo | Sheet 2 of 2

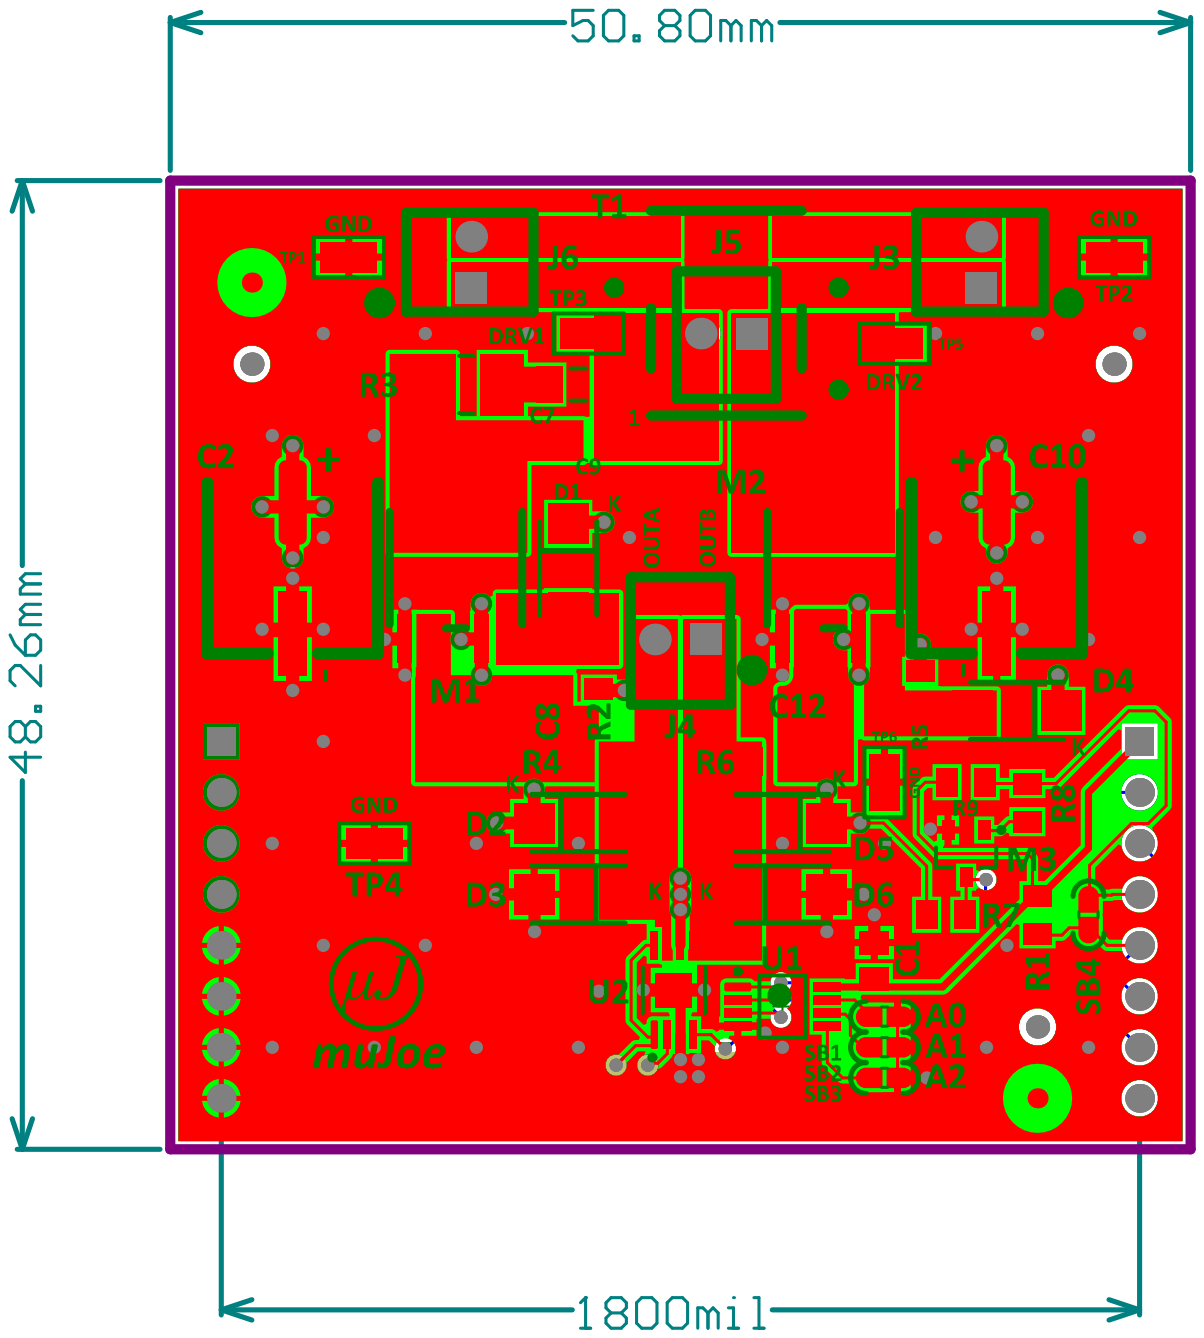
[picture p70: page 3]
