muJoseph/Emma-Mk1-DRSSTC/hardware/electrical/Emma Mk1 DRSSTC VDoubler Rev A/SCHEM-Emma Mk1 DRSSTC VDoubler Rev A.pdf

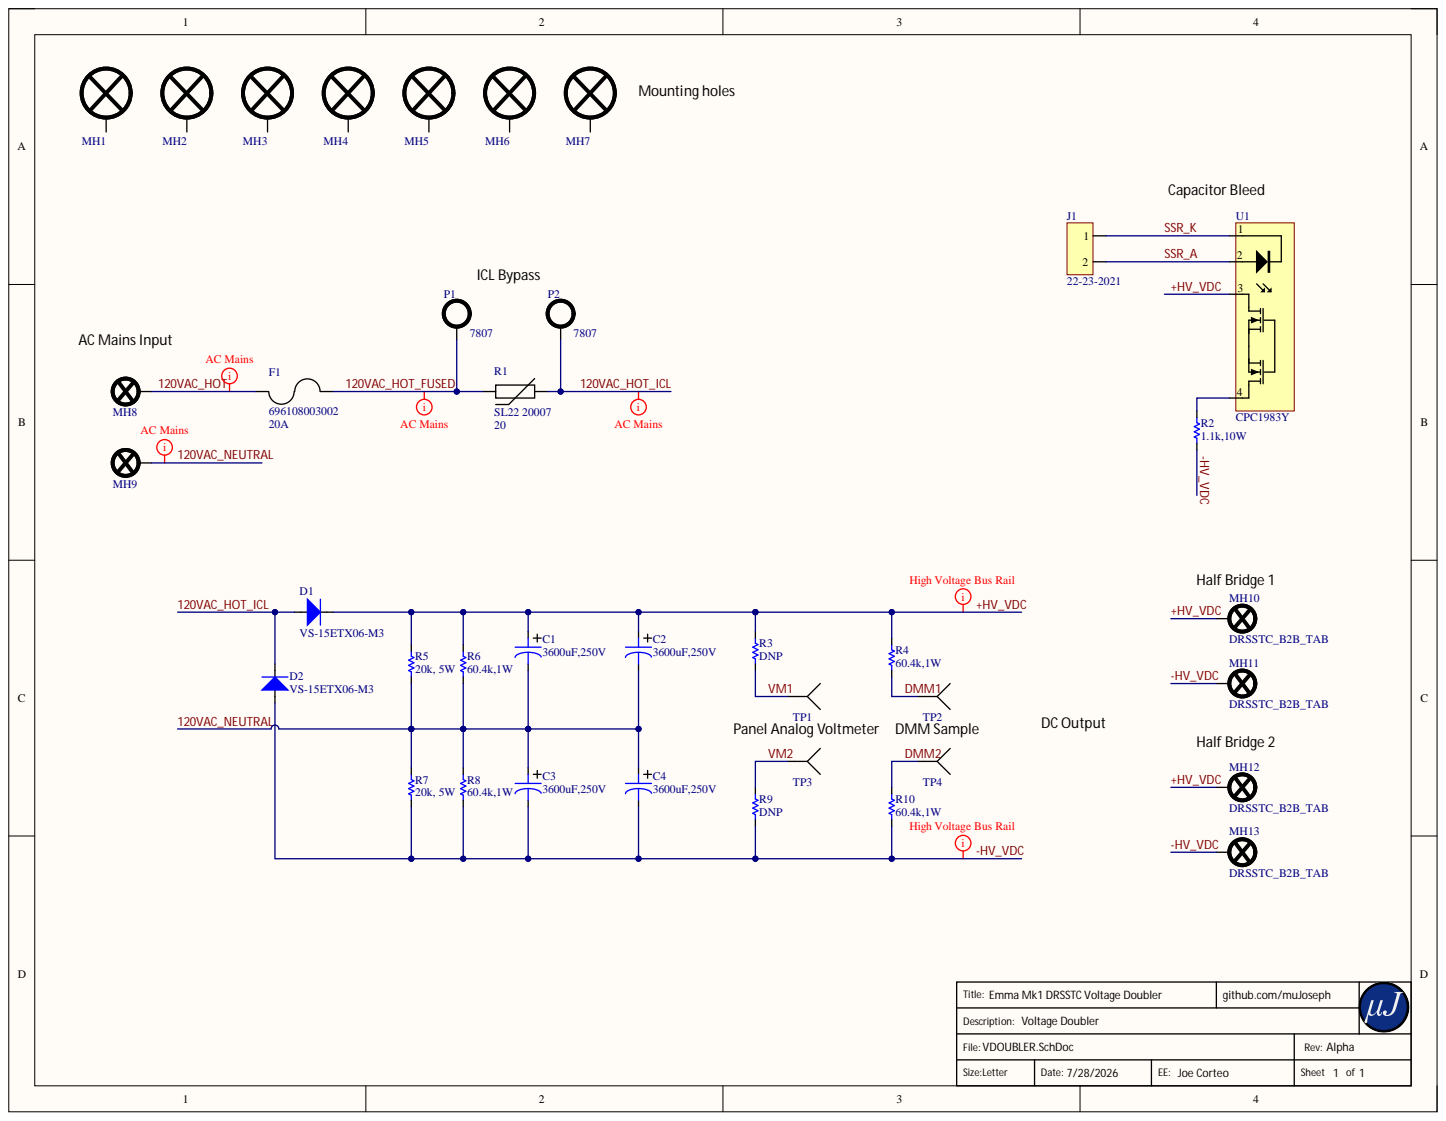
[picture p71: page 1]

High Voltage Bus Rail

Panel Analog Voltmeter DMM Sample

Title: Emma Mk1 DRSSTC Voltage Doubler

VDOUBLER.SchDoc File: | Rev: Alpha

Size: Letter | Date: 7/28/2026 | EE: Joe Corteo | Sheet 1 of 1

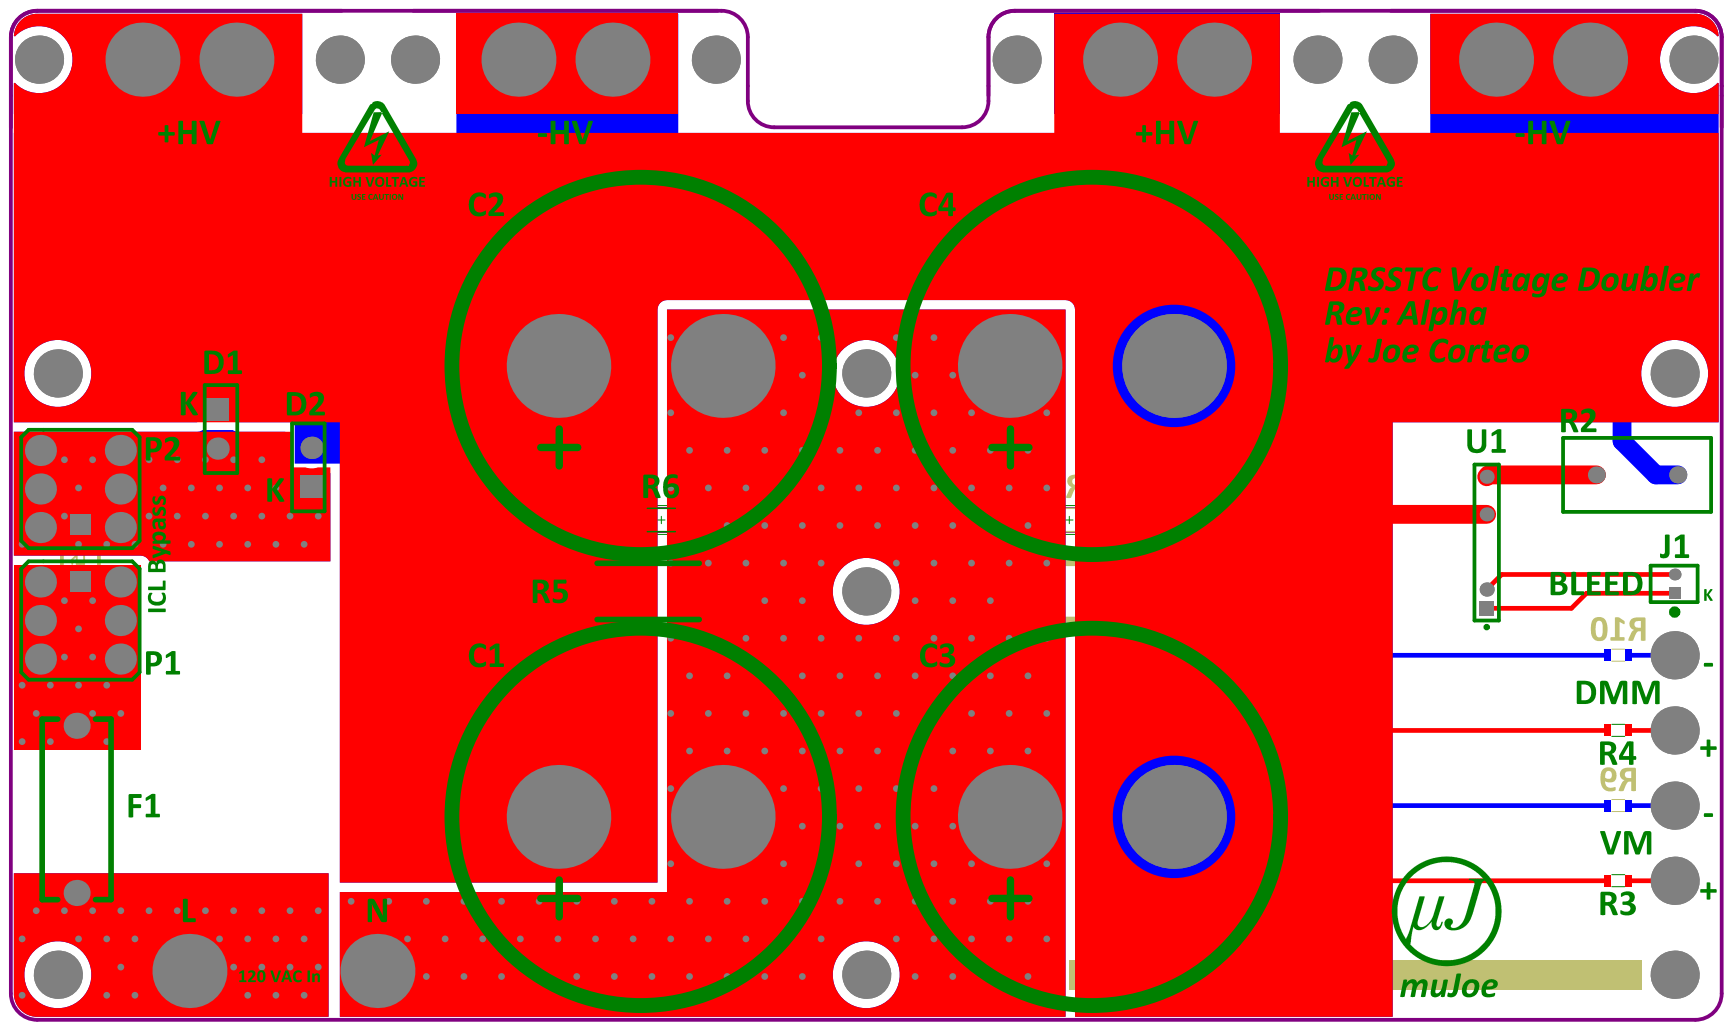
[picture p72: page 2]
