muJoseph/Emma-Mk1-DRSSTC/hardware/electrical/Emma Mk1 DRSSTC CS Rev B/SCHEM-Emma Mk1 DRSSTC CS Rev B.pdf

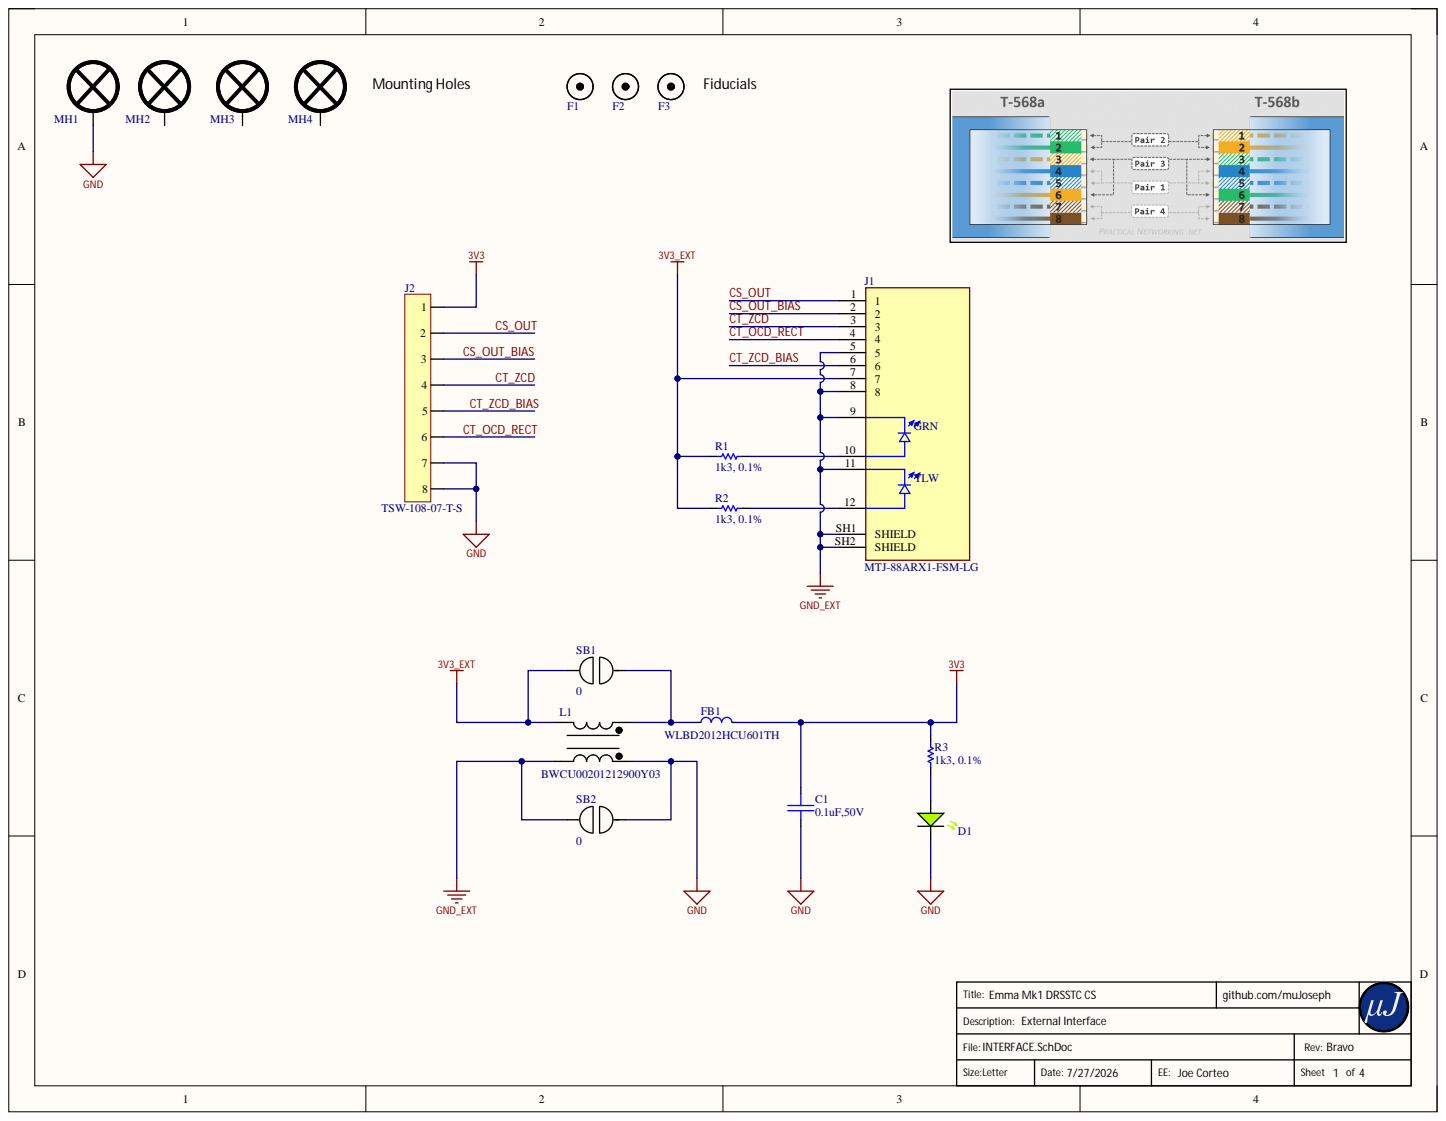
[picture p73: page 1]

Title: Emma Mk1 DRSSTC CS

INTERFACE.SchDoc File: | Rev: Bravo

Size: Letter | Date: 7/27/2026 | EE: Joe Corteo | Sheet 1 of 4

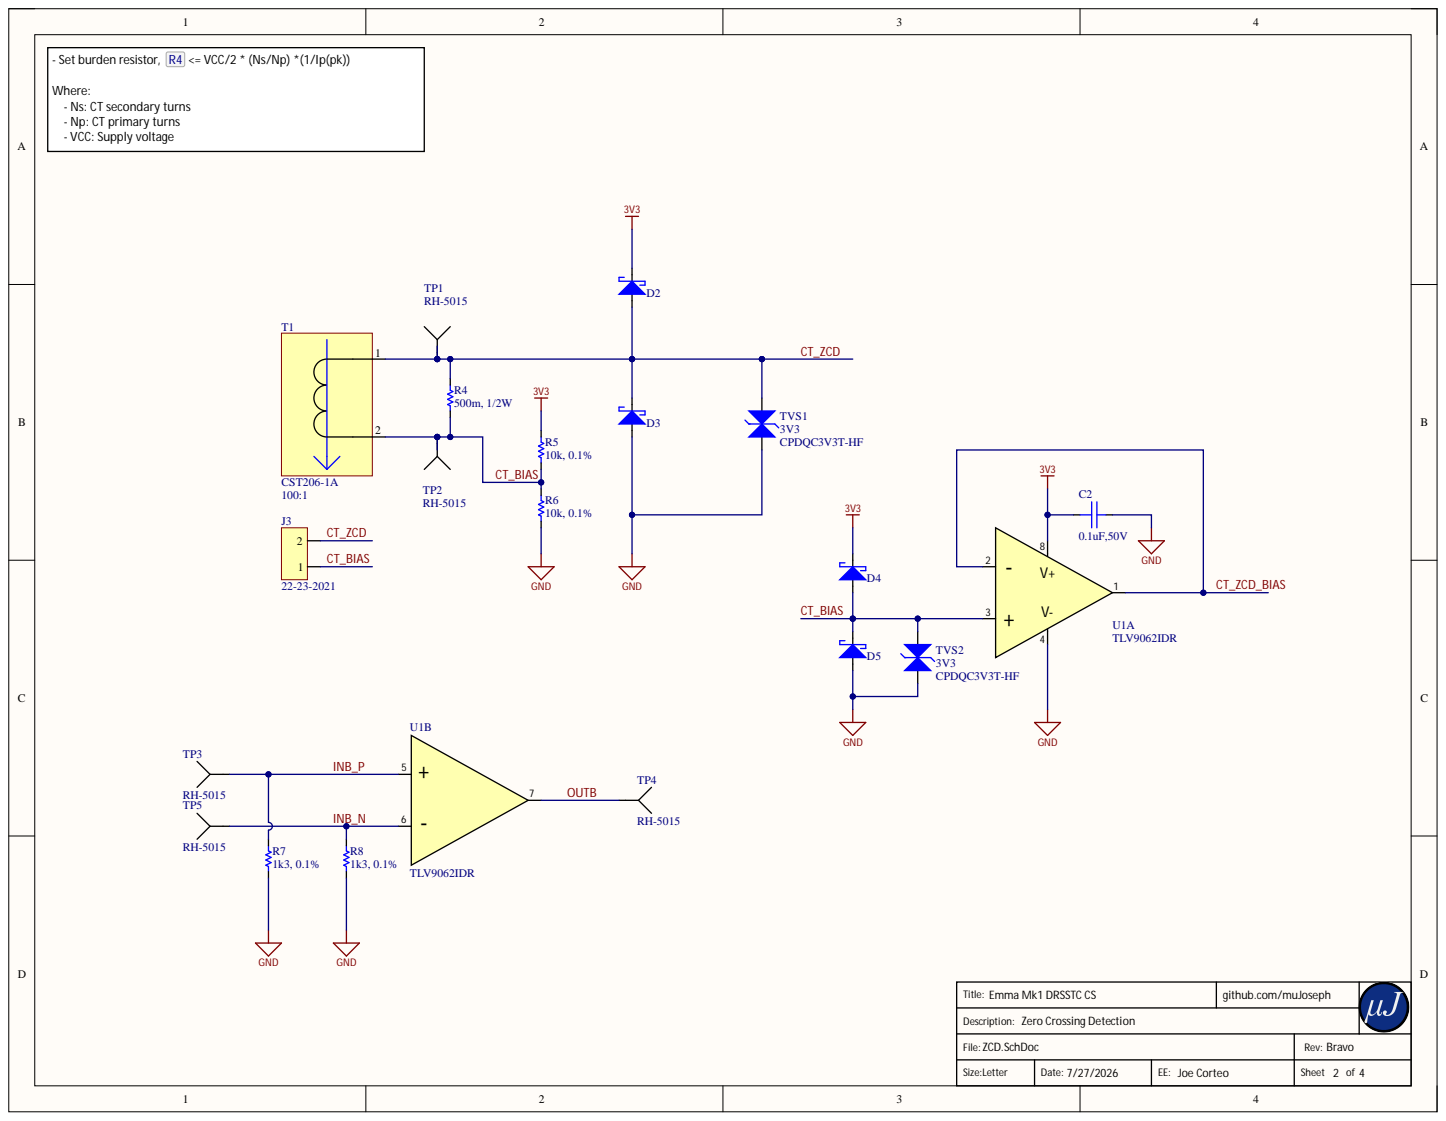
[picture p74: page 2]

- Set burden resistor, R4 <= VCC/2 * (Ns/Np) *(1/Ip(pk))

Where:
- Ns: CT secondary turns
- Np: CT primary turns
- VCC: Supply voltage

ZCD.SchDoc

Let ter | 2 of 4

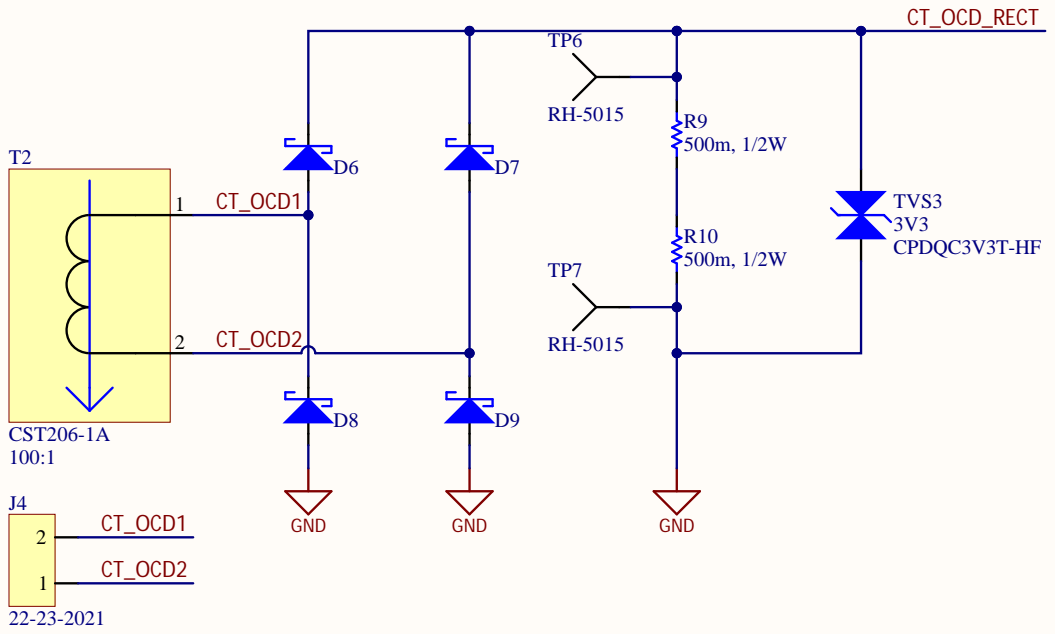
[picture p75: page 3]

OCD.SchDoc

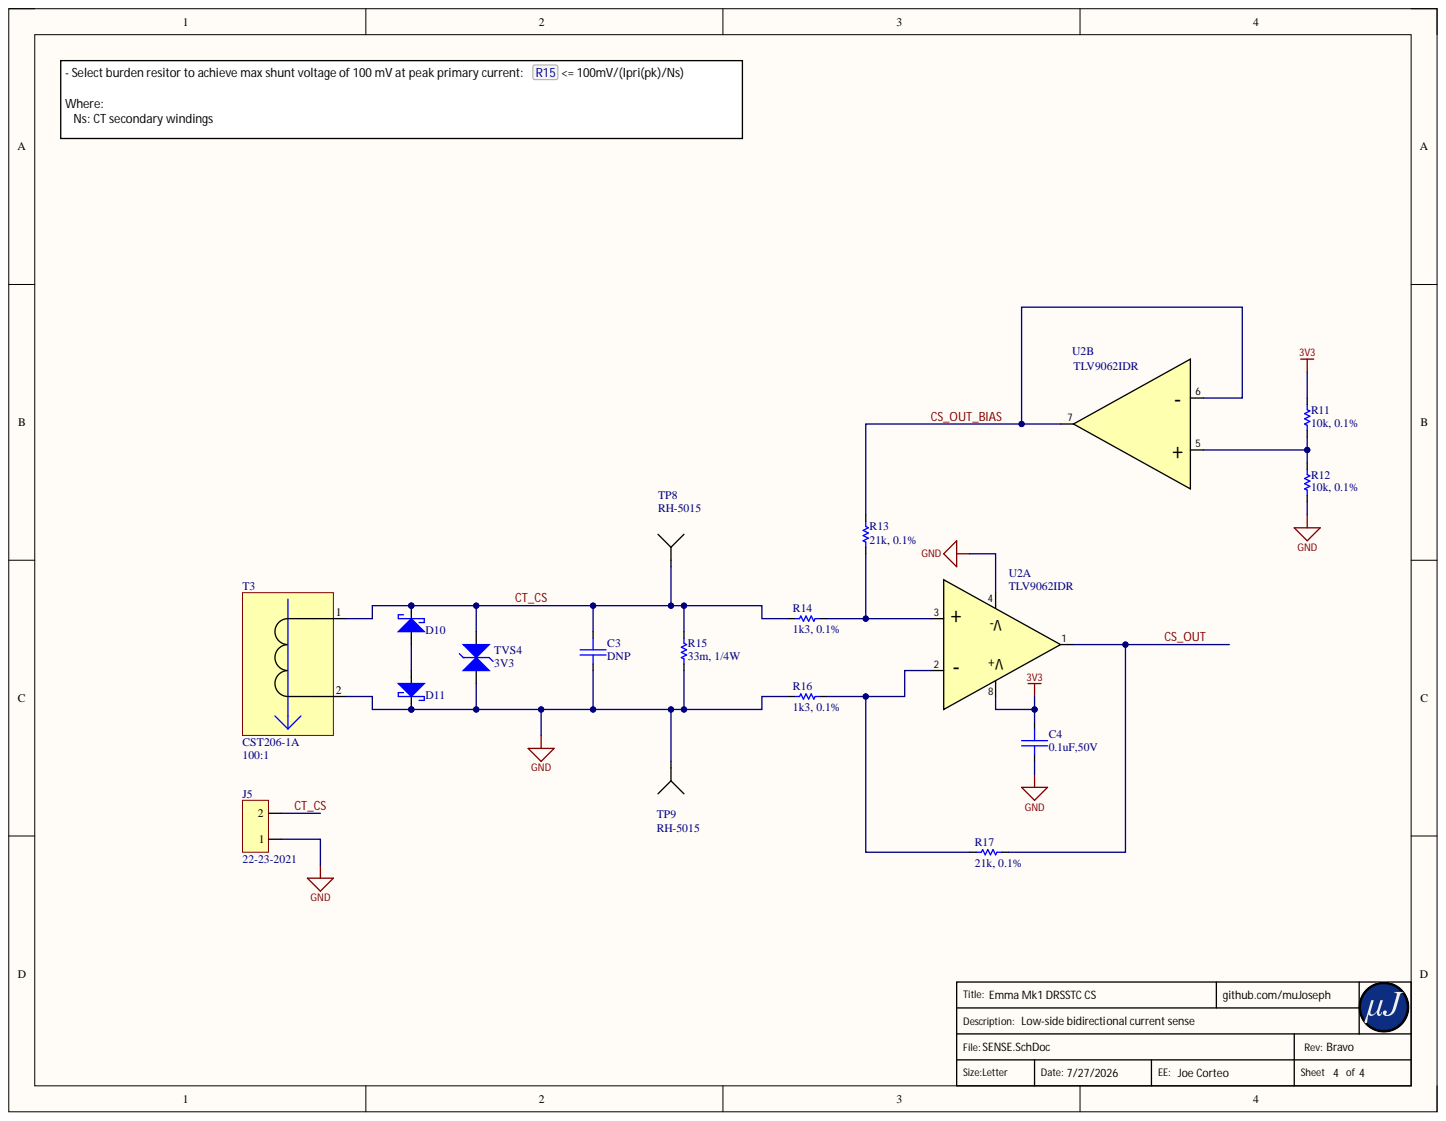
[picture p76: page 4]

- Select burden resitor to achieve max shunt voltage of 100 mV at peak primary current: R15 <= 100mV/(Ipri(pk)/Ns)

Where:
Ns: CT secondary windings

SENSE.SchDoc

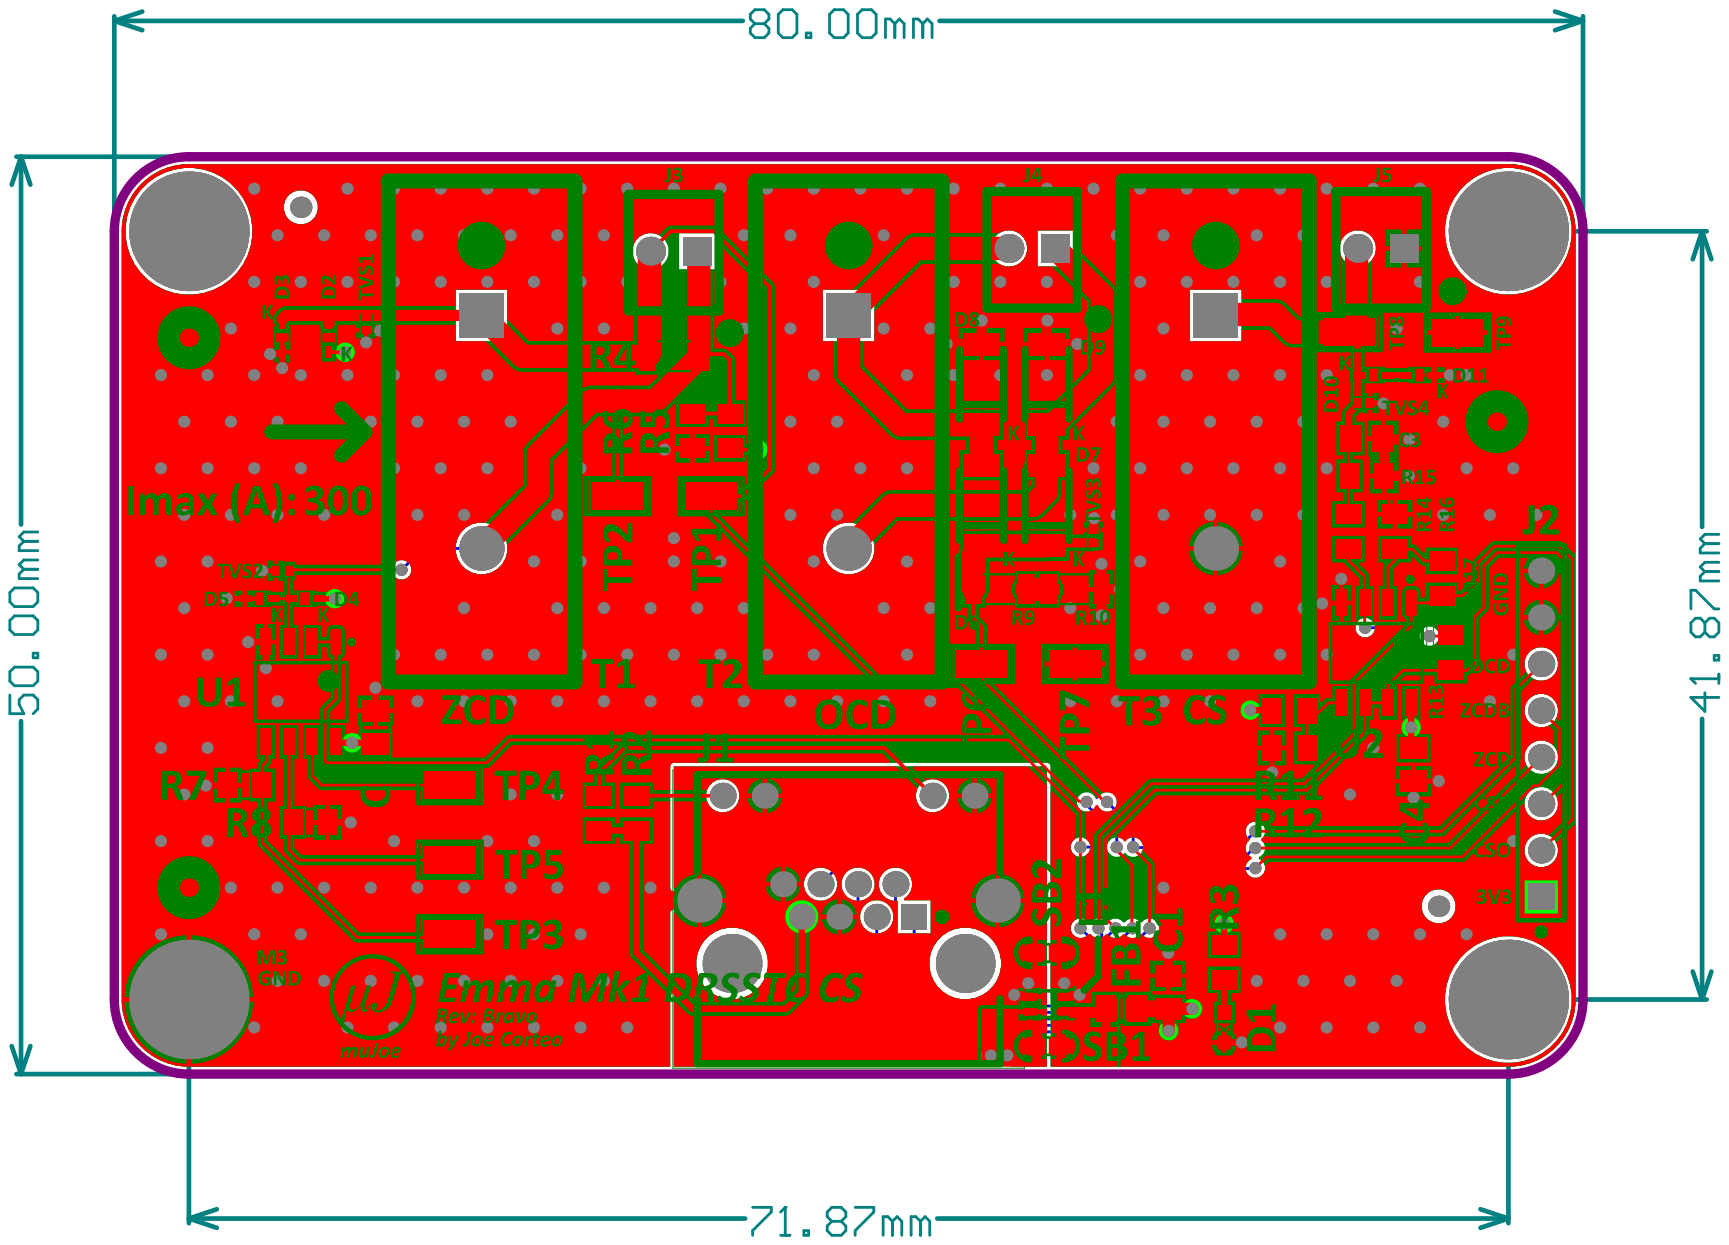
[picture p77: page 5]
