muJoseph/Emma-Mk1-DRSSTC/hardware/electrical/Emma Mk1 DRSSTC Half Bridge Rev A/SCHEM-Emma Mk1 DRSSTC Half Bridge Rev A.pdf

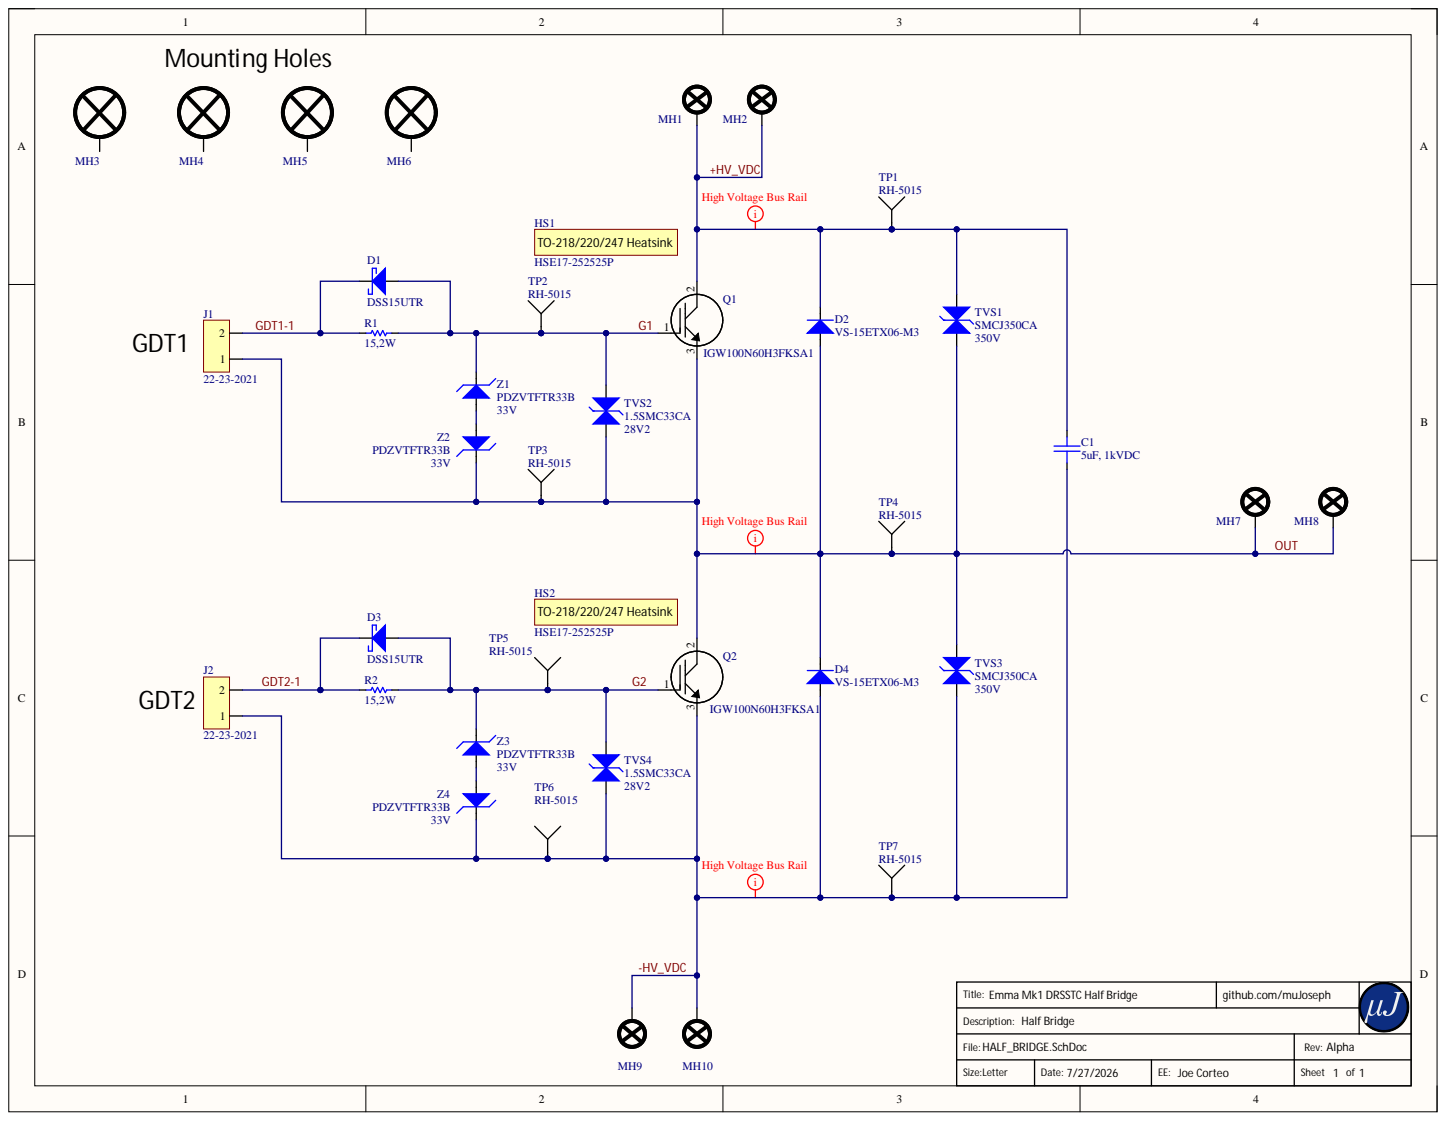
[picture p78: page 1]

High Voltage Bus Rail

HALF_BRIDGE.SchDoc | Rev: Alpha

Size: Let ter | Date: 7/27/2026 | EE: Joe Corteo | Sheet 1 of 1

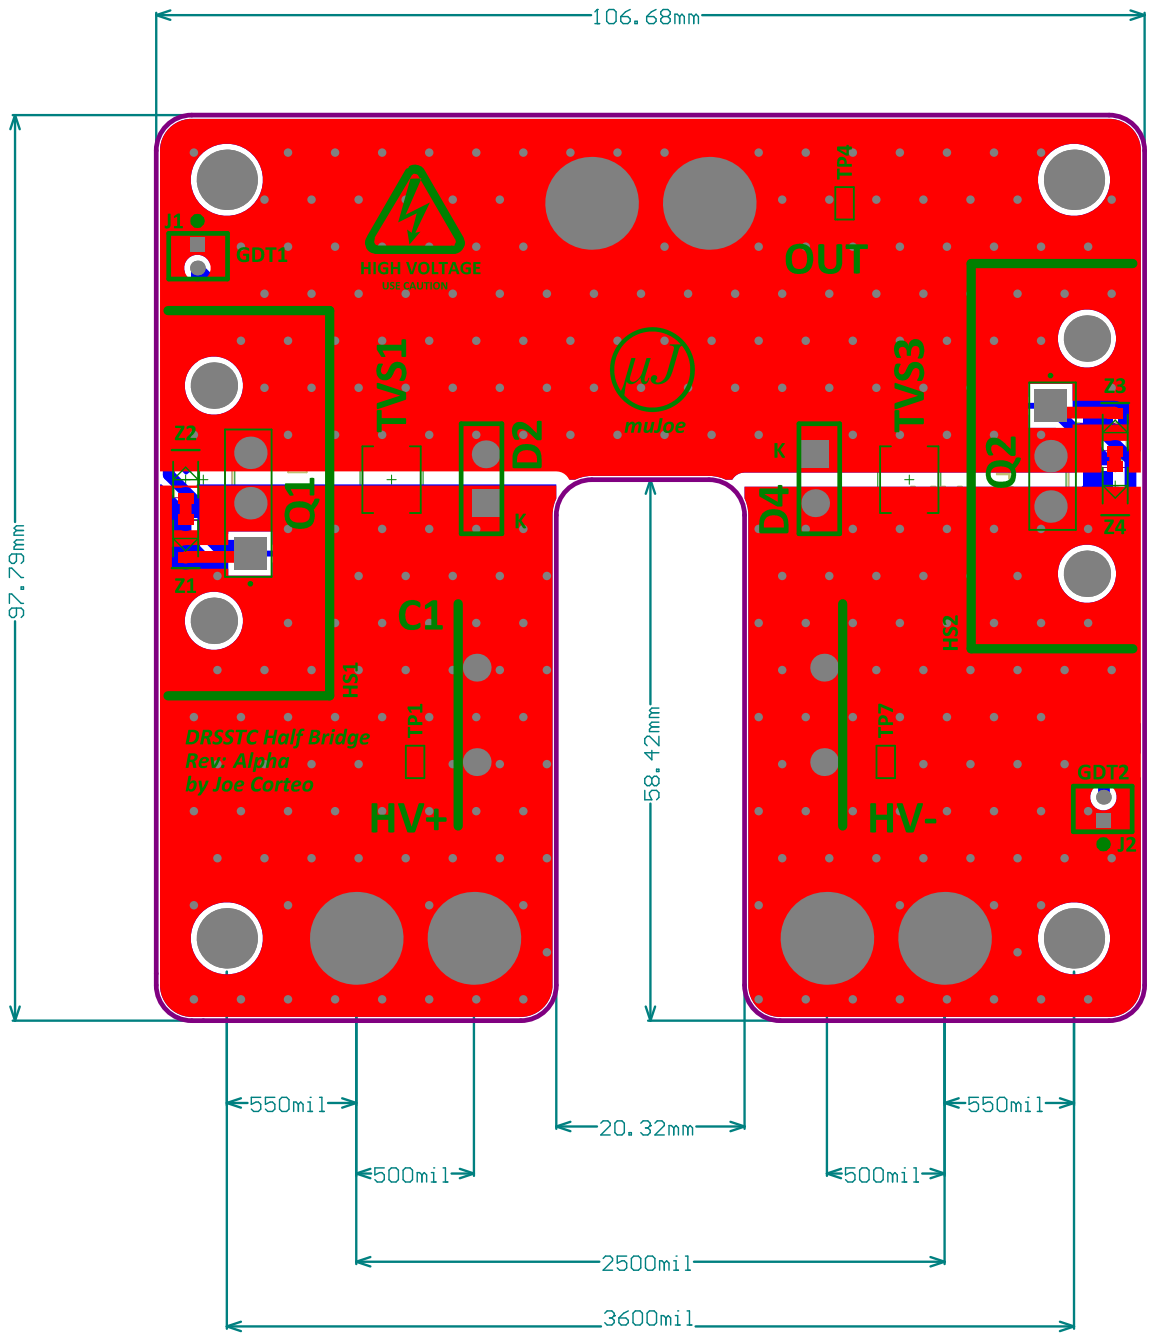
[picture p79: page 2]
