muJoseph/Emma-Mk1-DRSSTC/hardware/electrical/Emma Mk1 DRSSTC MB Rev A/SCHEM-Emma Mk1 DRSSTC MB Rev A.pdf

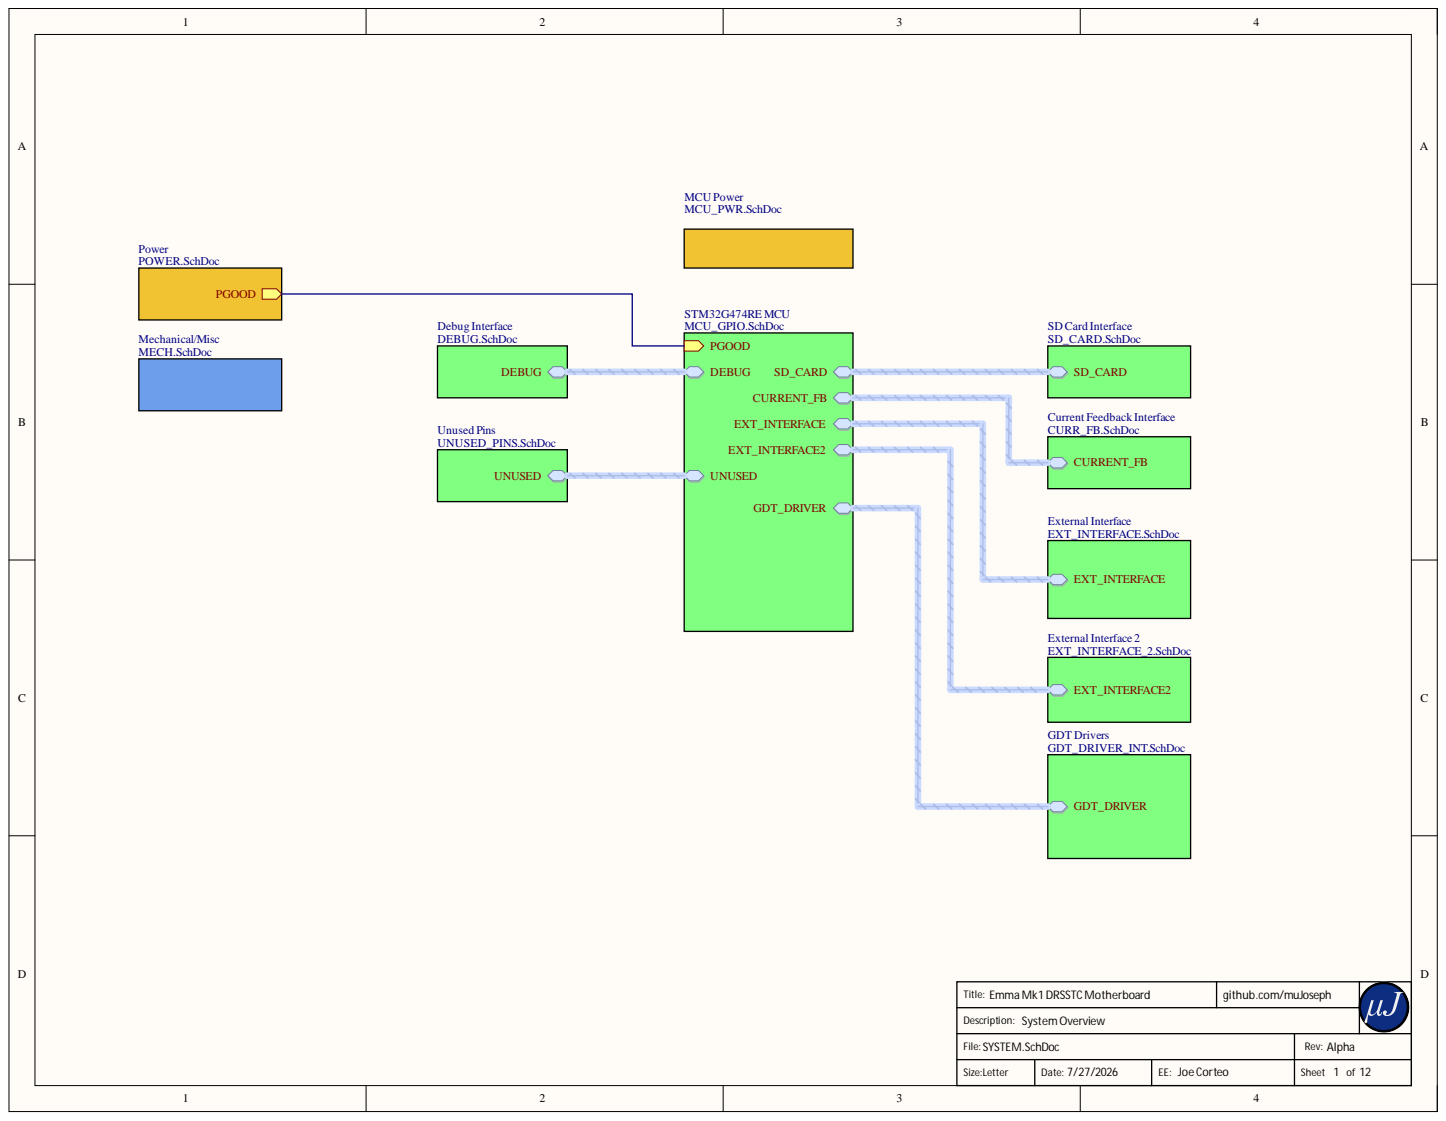
[picture p80: page 1]

File: SYSTEM.SchDoc | Rev: Alpha

Size: Letter | Date: 7/27/2026 | EE: Joe Corteo | Sheet 1 of 12

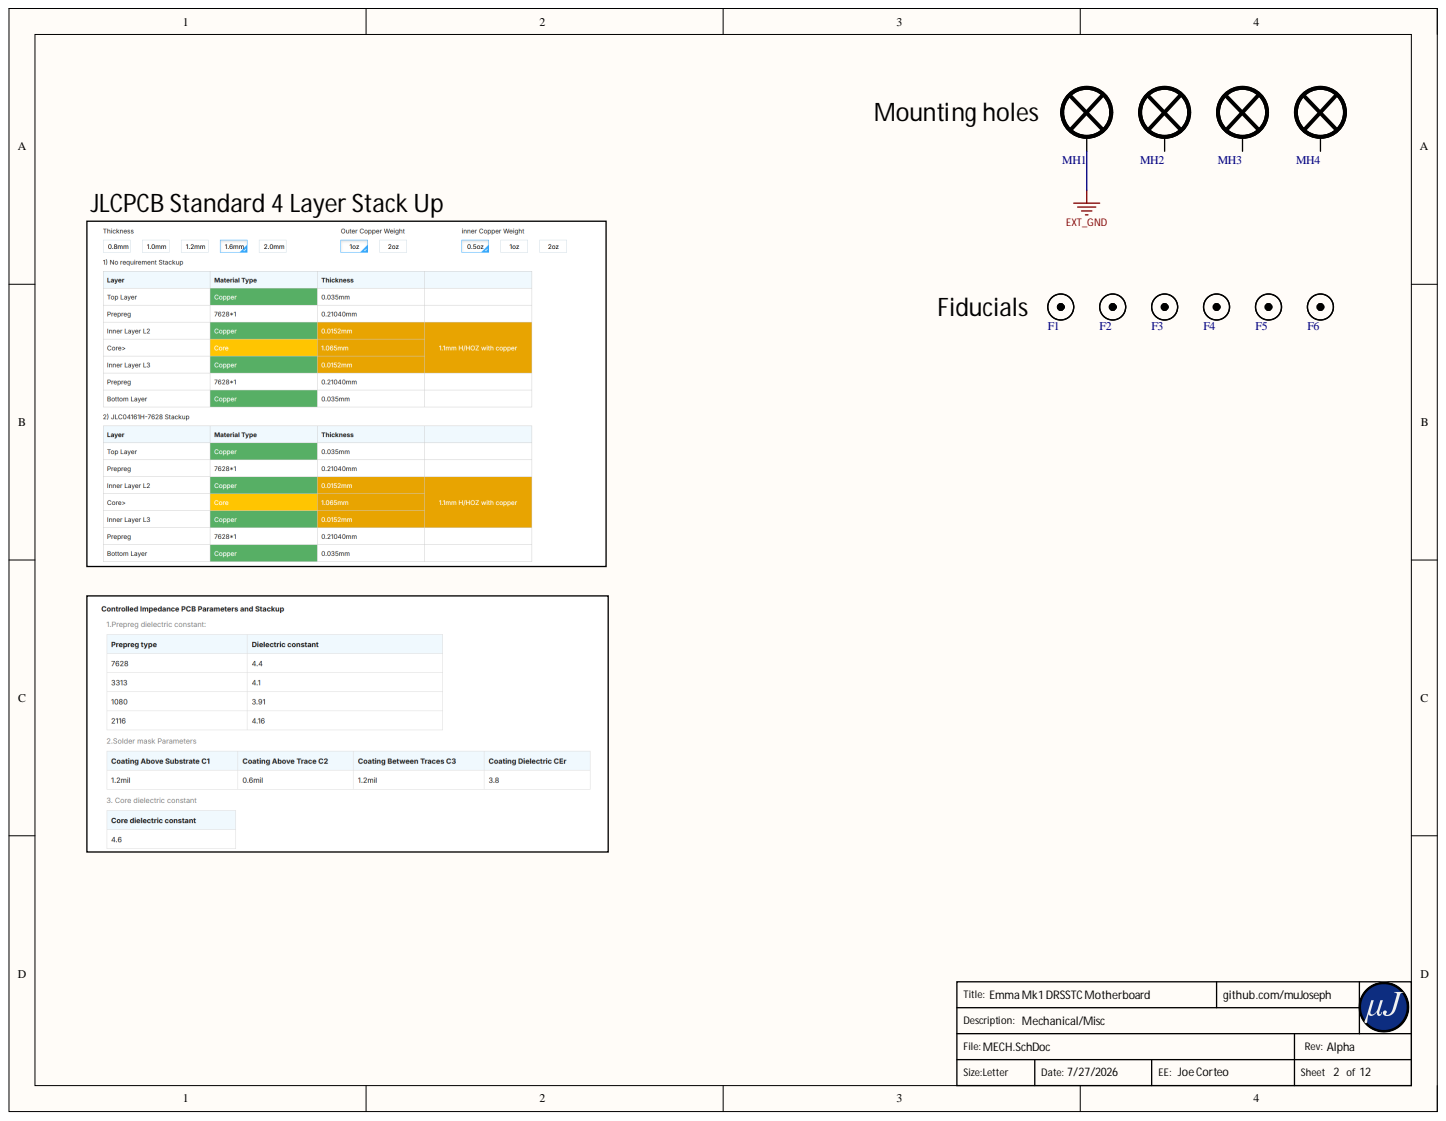
[picture p81: page 2]

JLCPCB Standard 4 Layer Stack Up

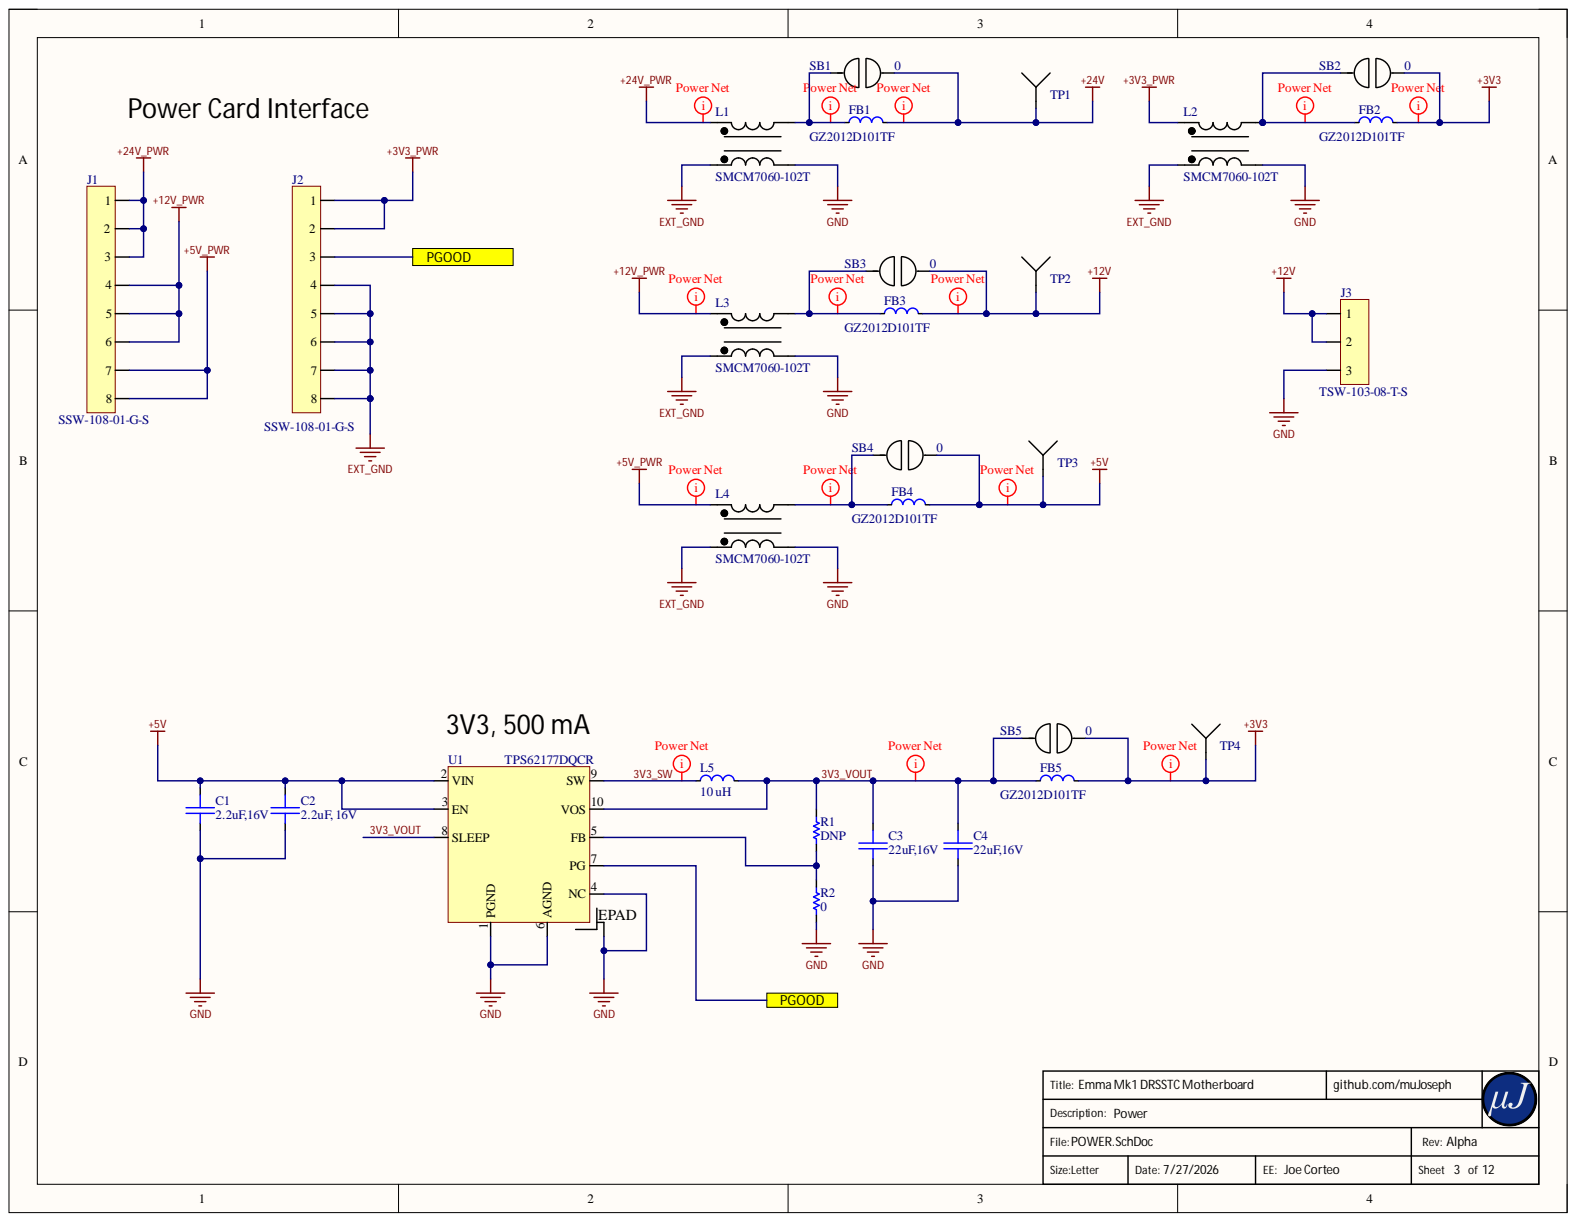
[picture p82: page 3]

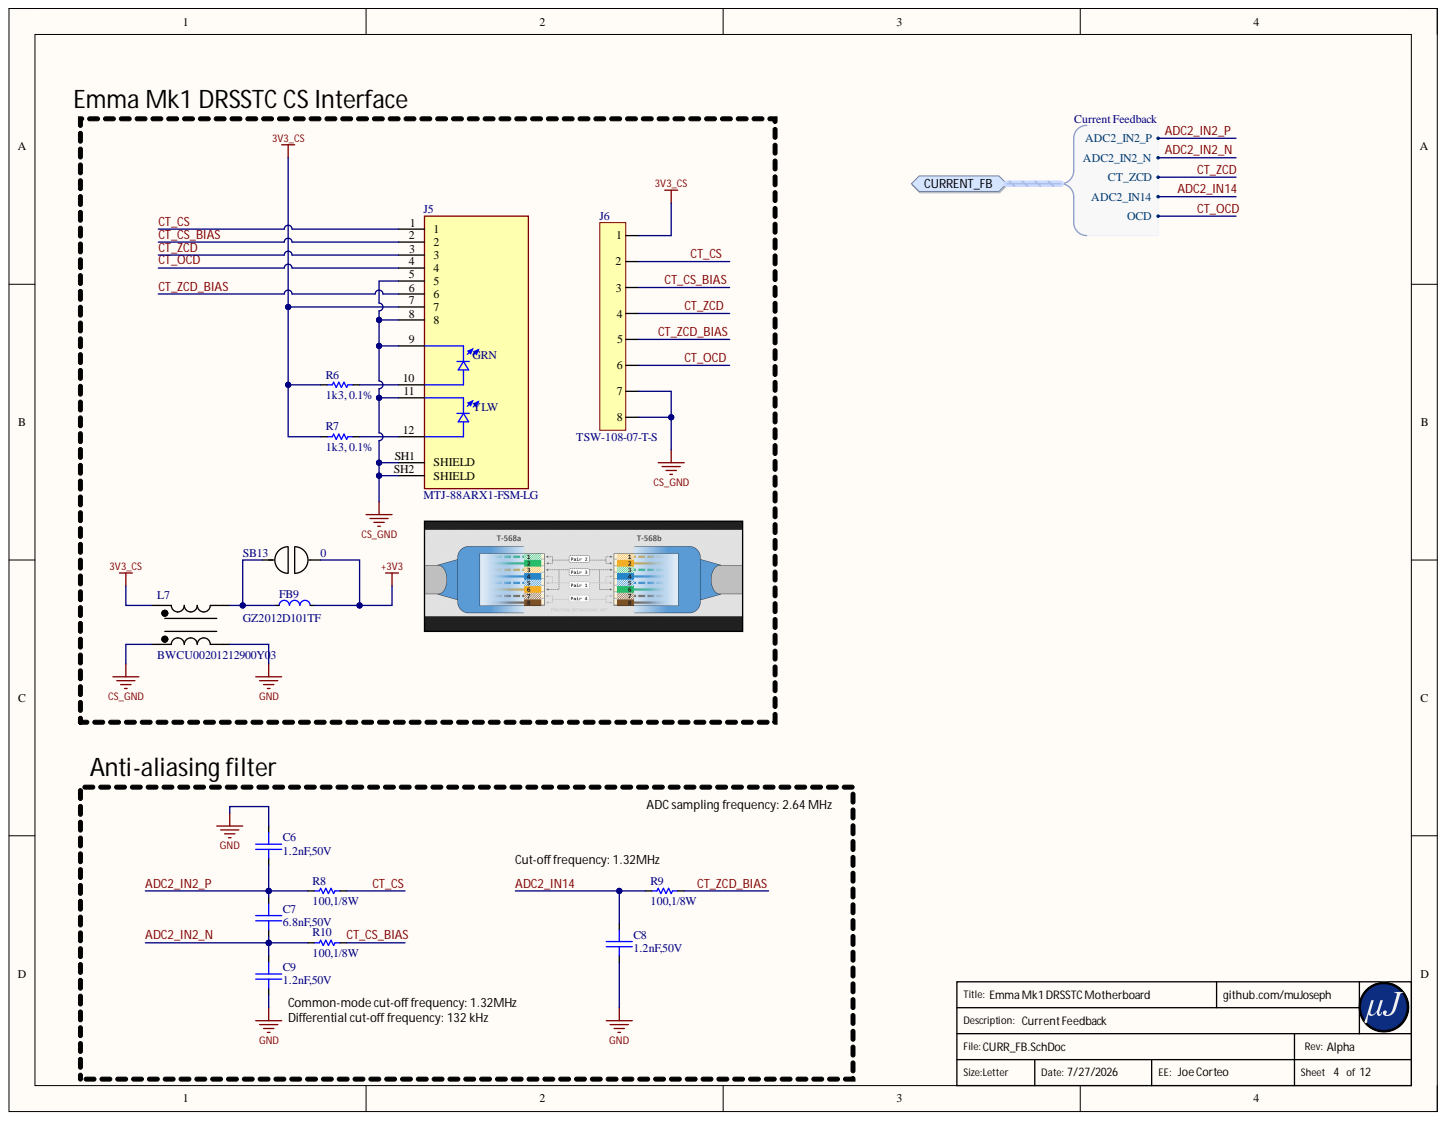
[picture p83: page 4]

Emma Mk1 DRSSTC CS Interface

2 2
3 3
4 4
5 5
6 6

ADC sampling frequency: 2.64 MHz

Common-mode cut-off frequency: 1.32MHz
Differential cut-off frequency: 132 kHz

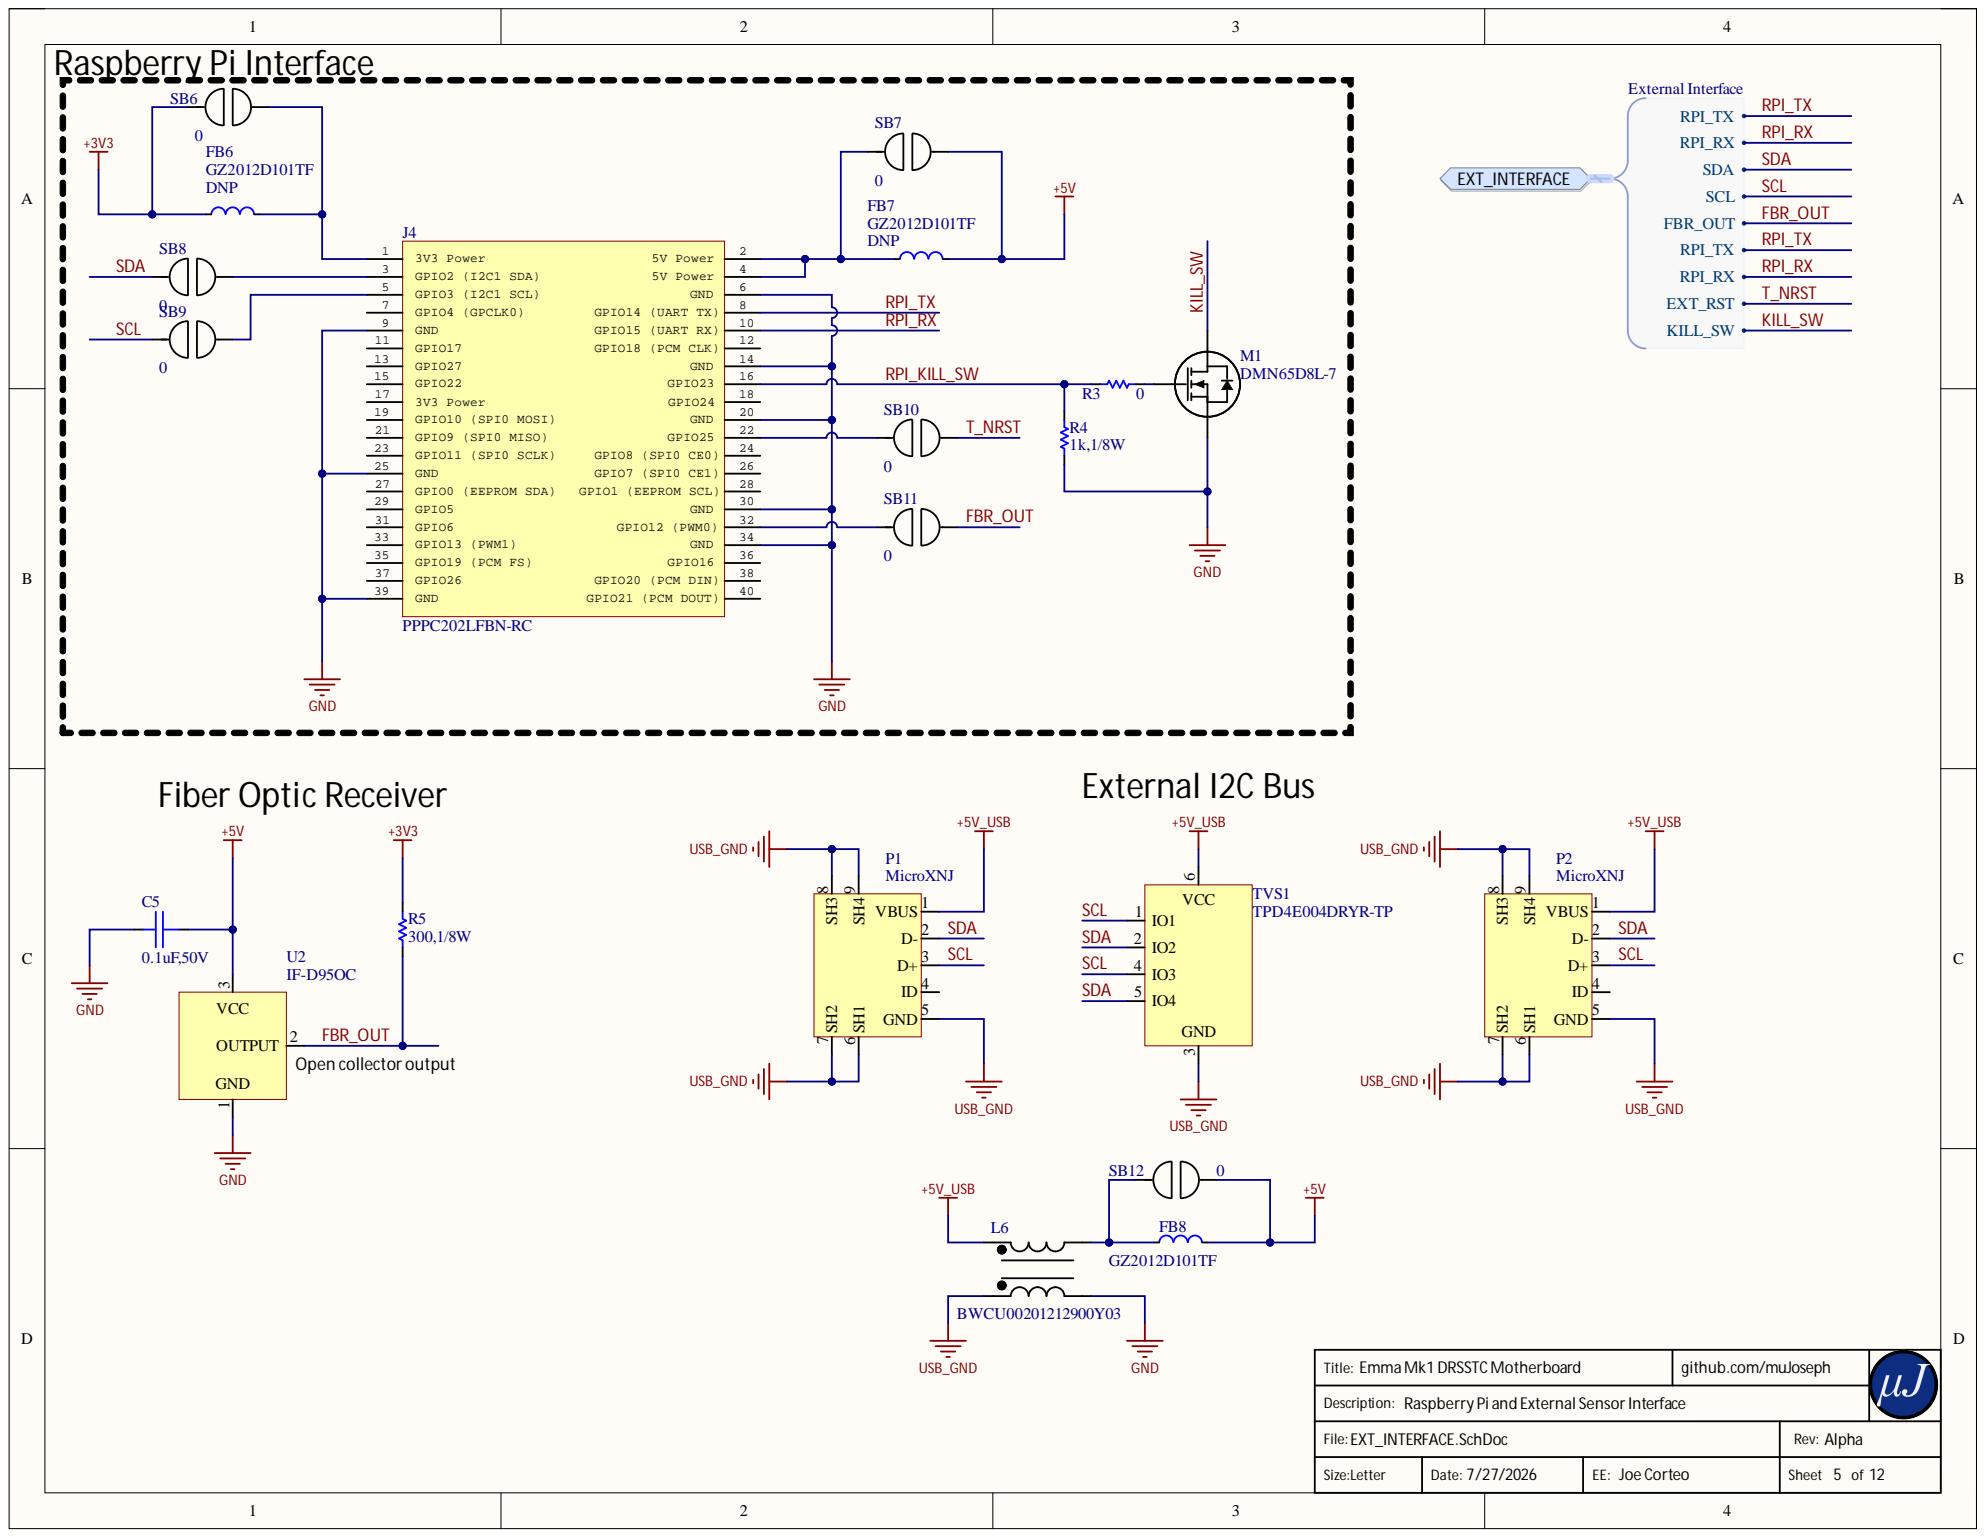
[picture p84: page 5]

Raspberry Pi and External SensorInterface

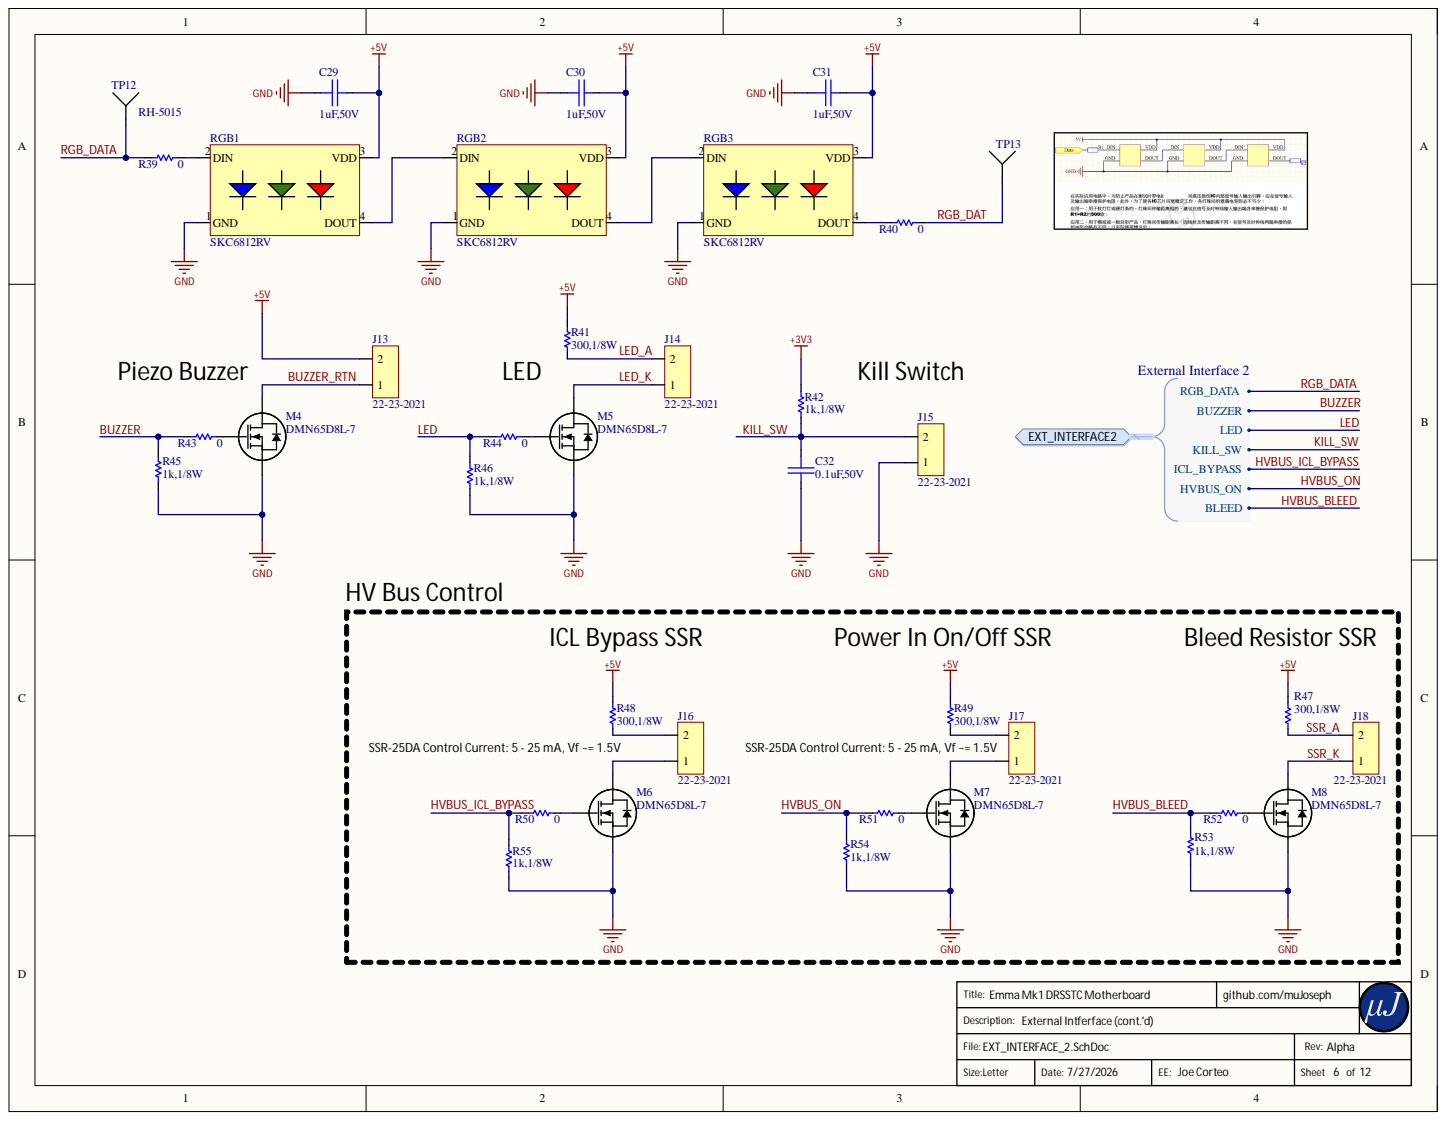
[picture p85: page 6]

Power In On/Off SSR

SSR-25DA Control Current: 5 - 25 mA, Vf ~= 1.5V

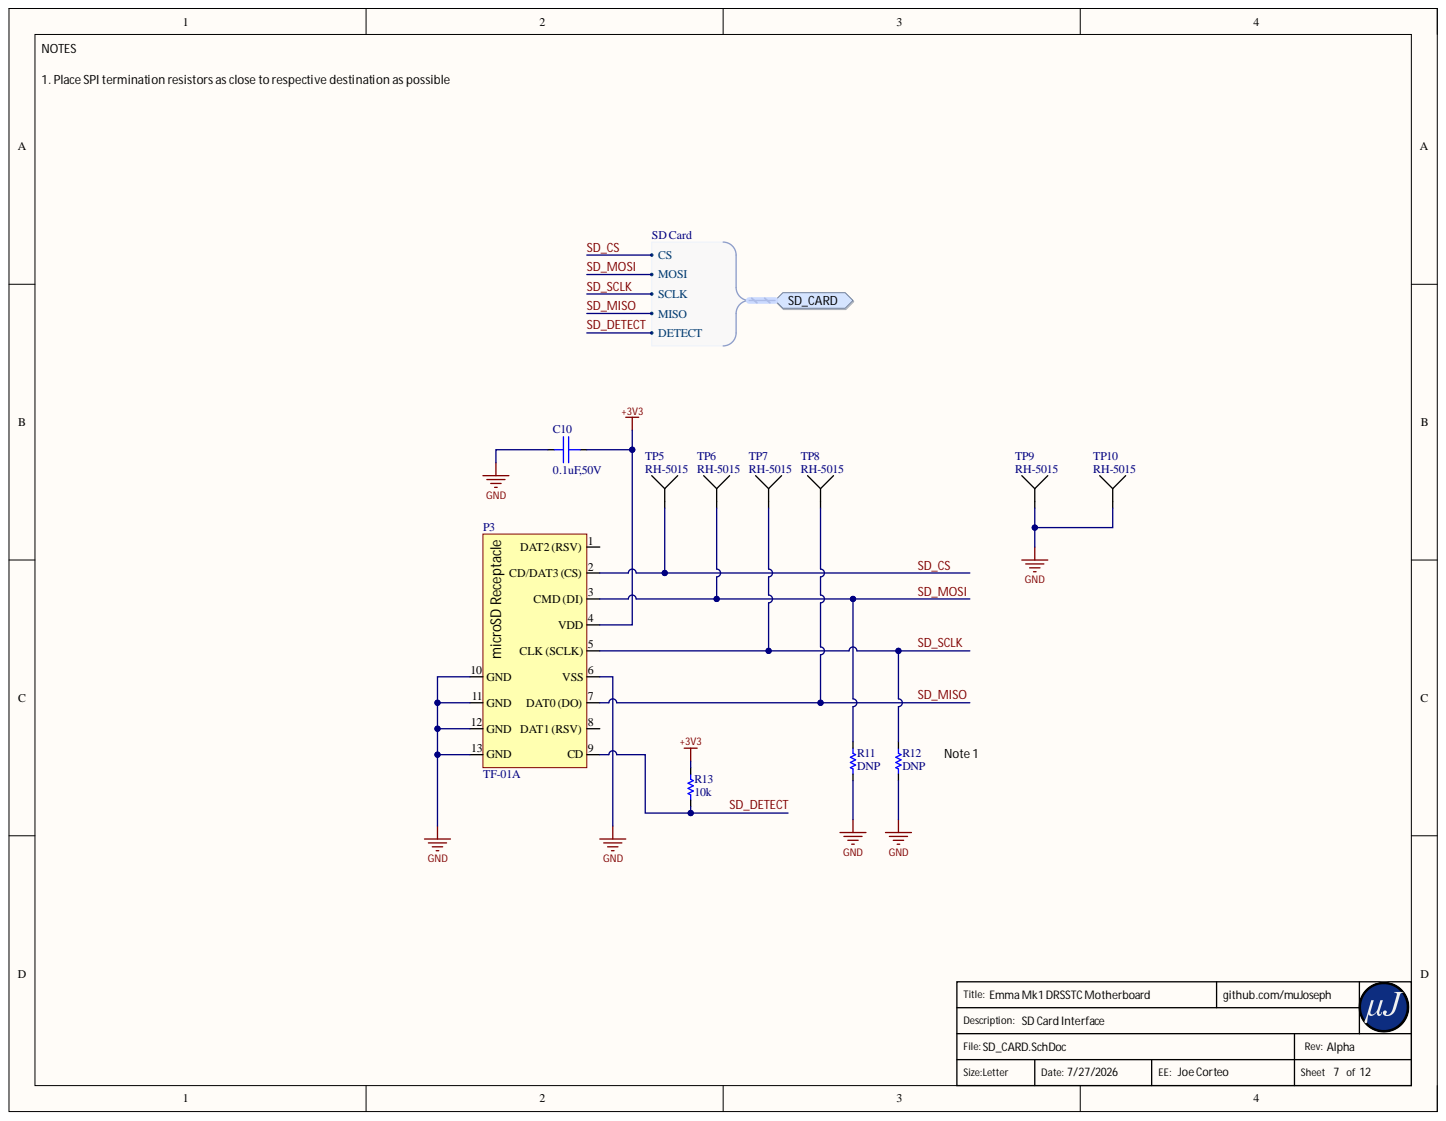
[picture p86: page 7]

1. Place SPI termination resistors as close to respective destination as possible

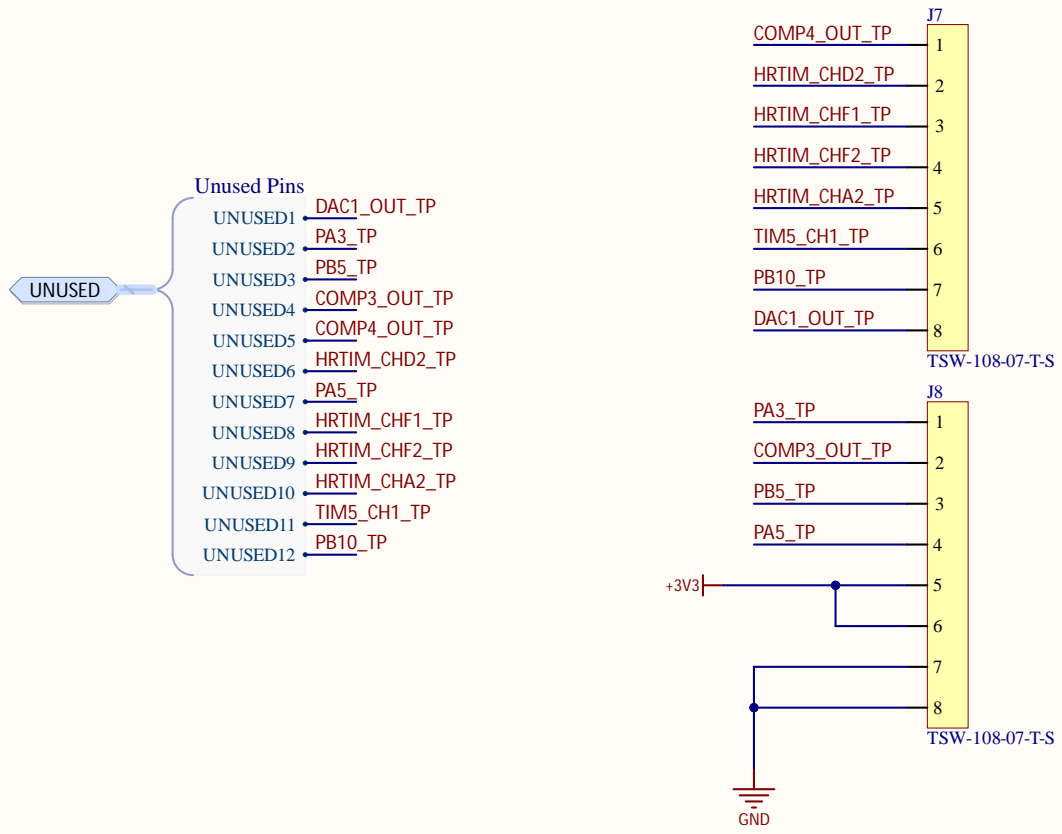
[picture p87: page 8]

Fi le: UNUSED_ PINS.Sch D o c | Rev: A l p h a

Si ze: Let ter | D ate: 7 / 2 7/ 2026 | E E : Jo e Co r te o | Sheet 8 o f 1 2

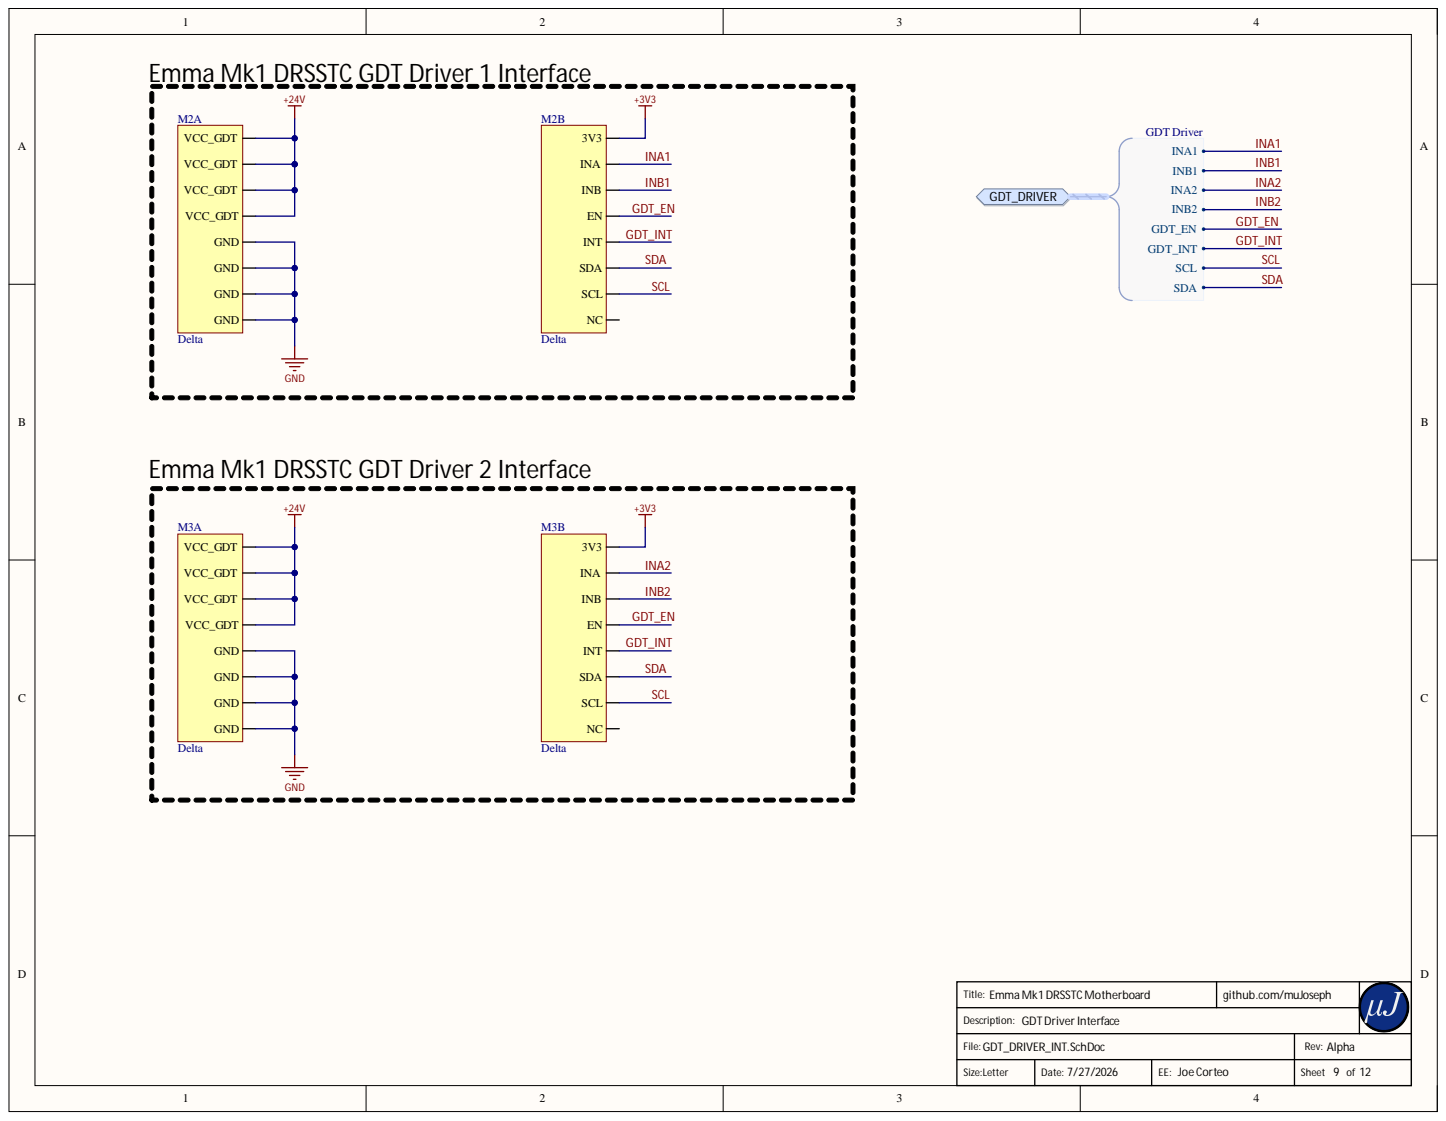
[picture p88: page 9]

Emma Mk1 DRSSTC GDT Driver 1 In

Emma Mk1 DRSSTC GDT Driver 2 In

Fi le: GDT_DRIVER_INT.Sch D o c | Rev: A l p h a

Si ze: Let ter | D ate: 7 / 2 7/ 2026 | E E : Jo e Co r te o | Sheet 9 o f 1 2

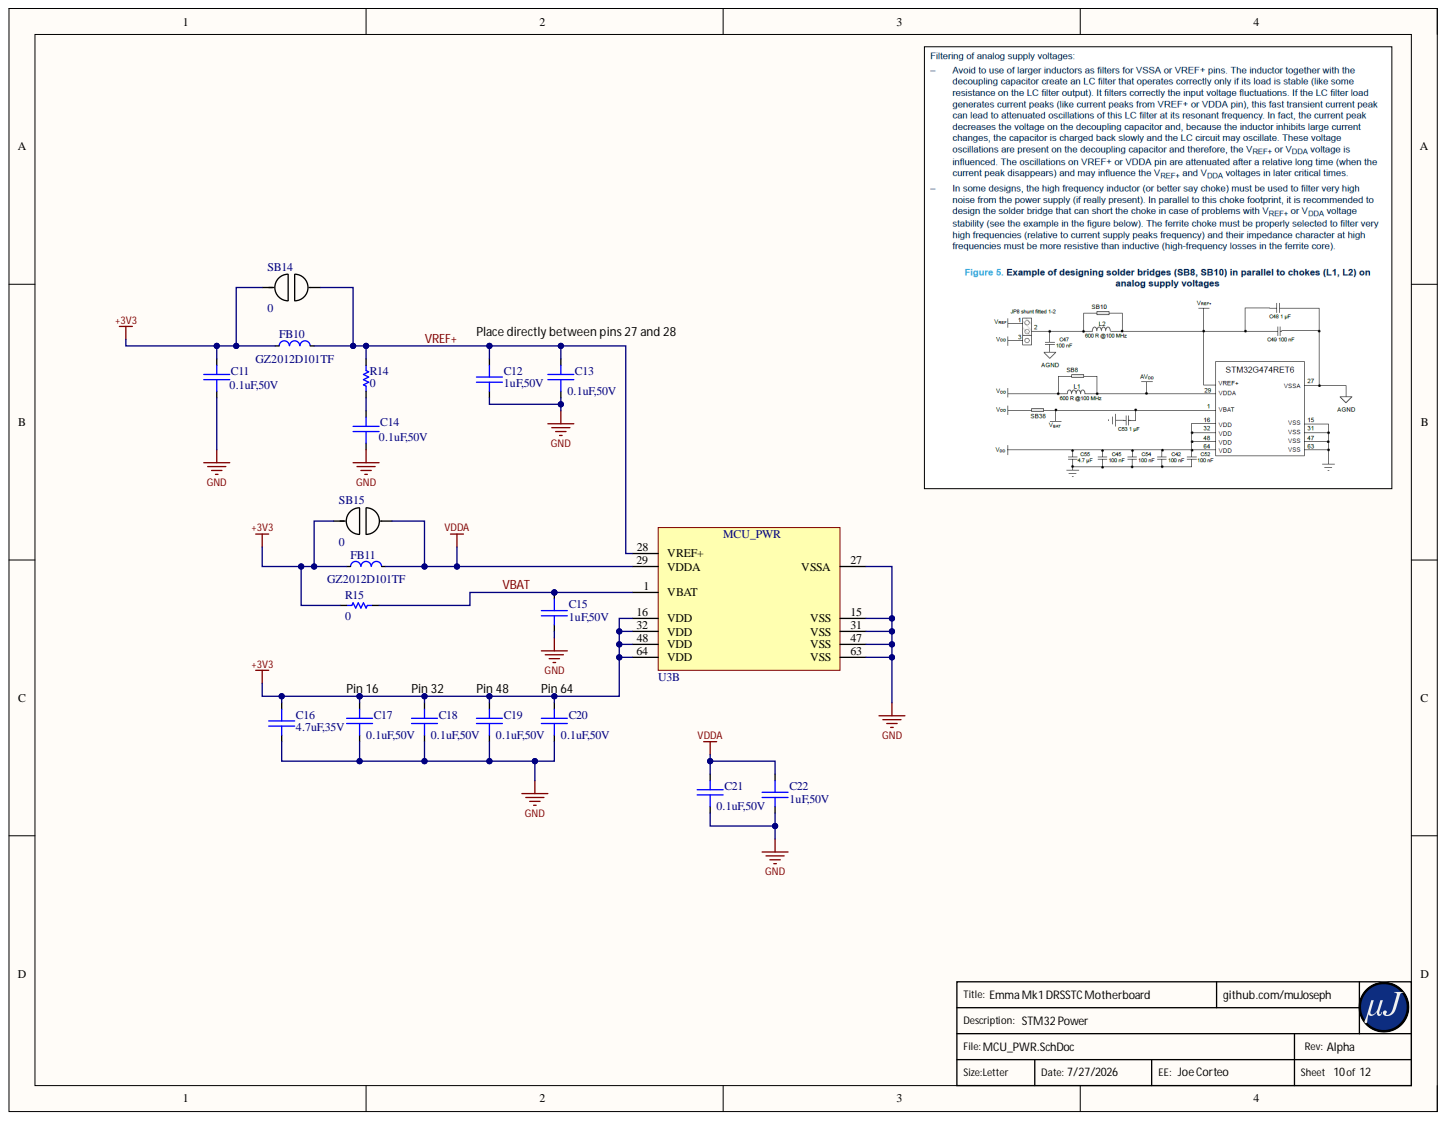
[picture p89: page 10]

Place directly between pins 27 and 28

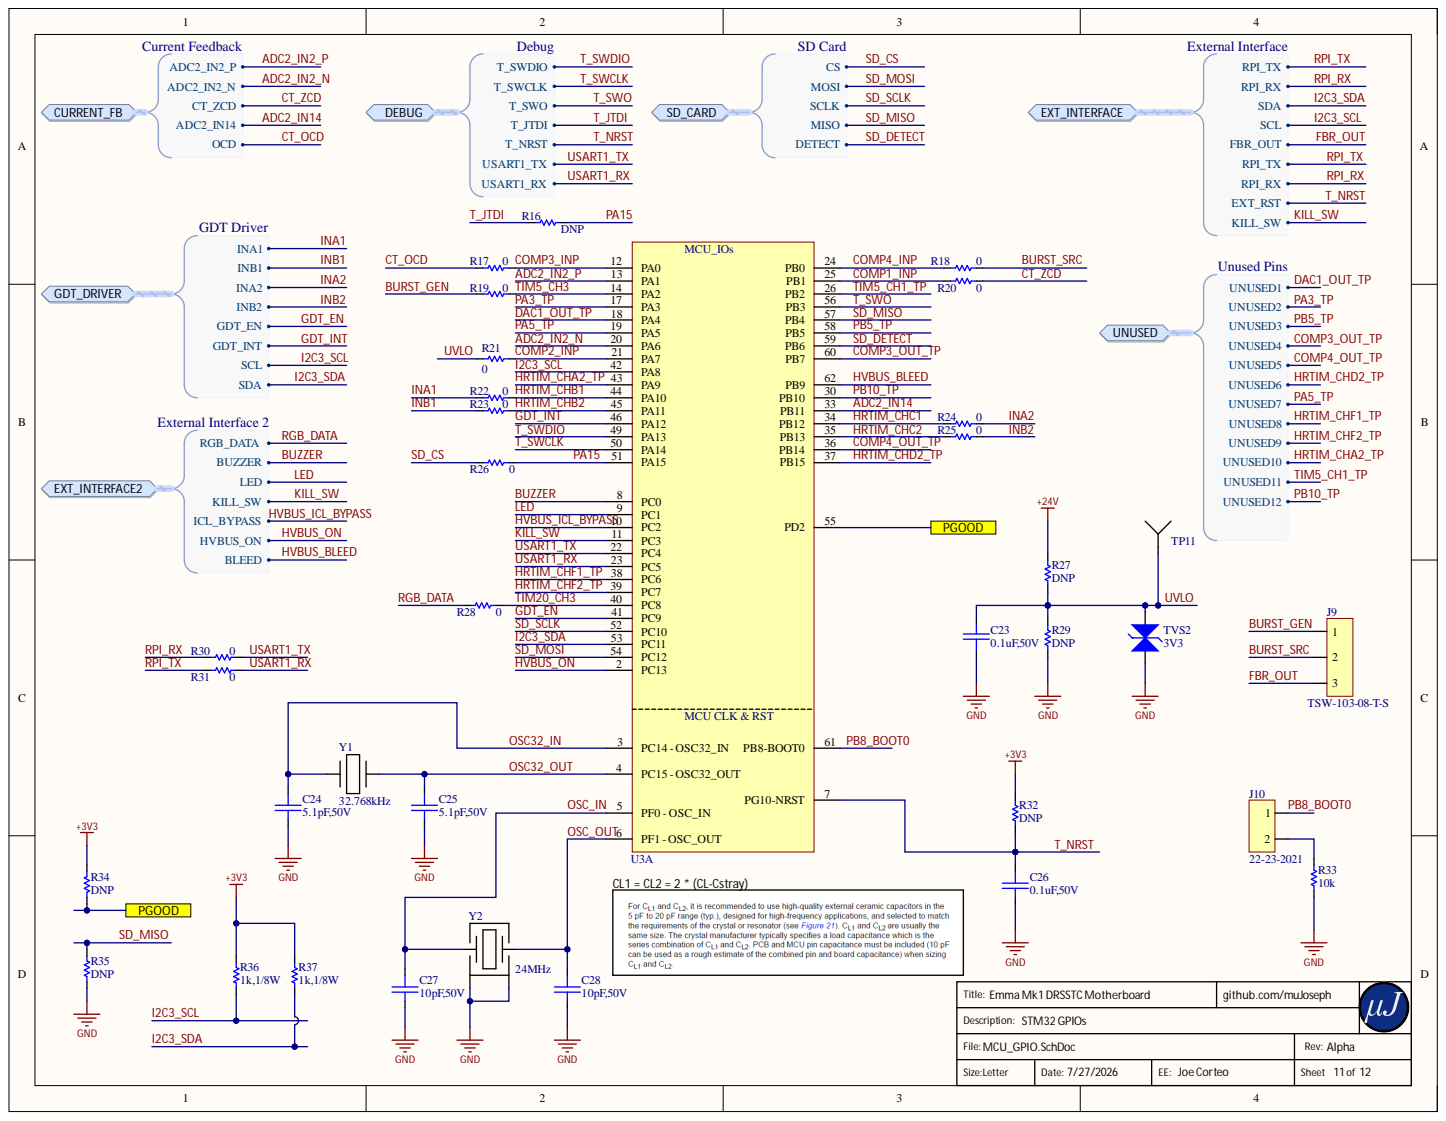
[picture p90: page 11]

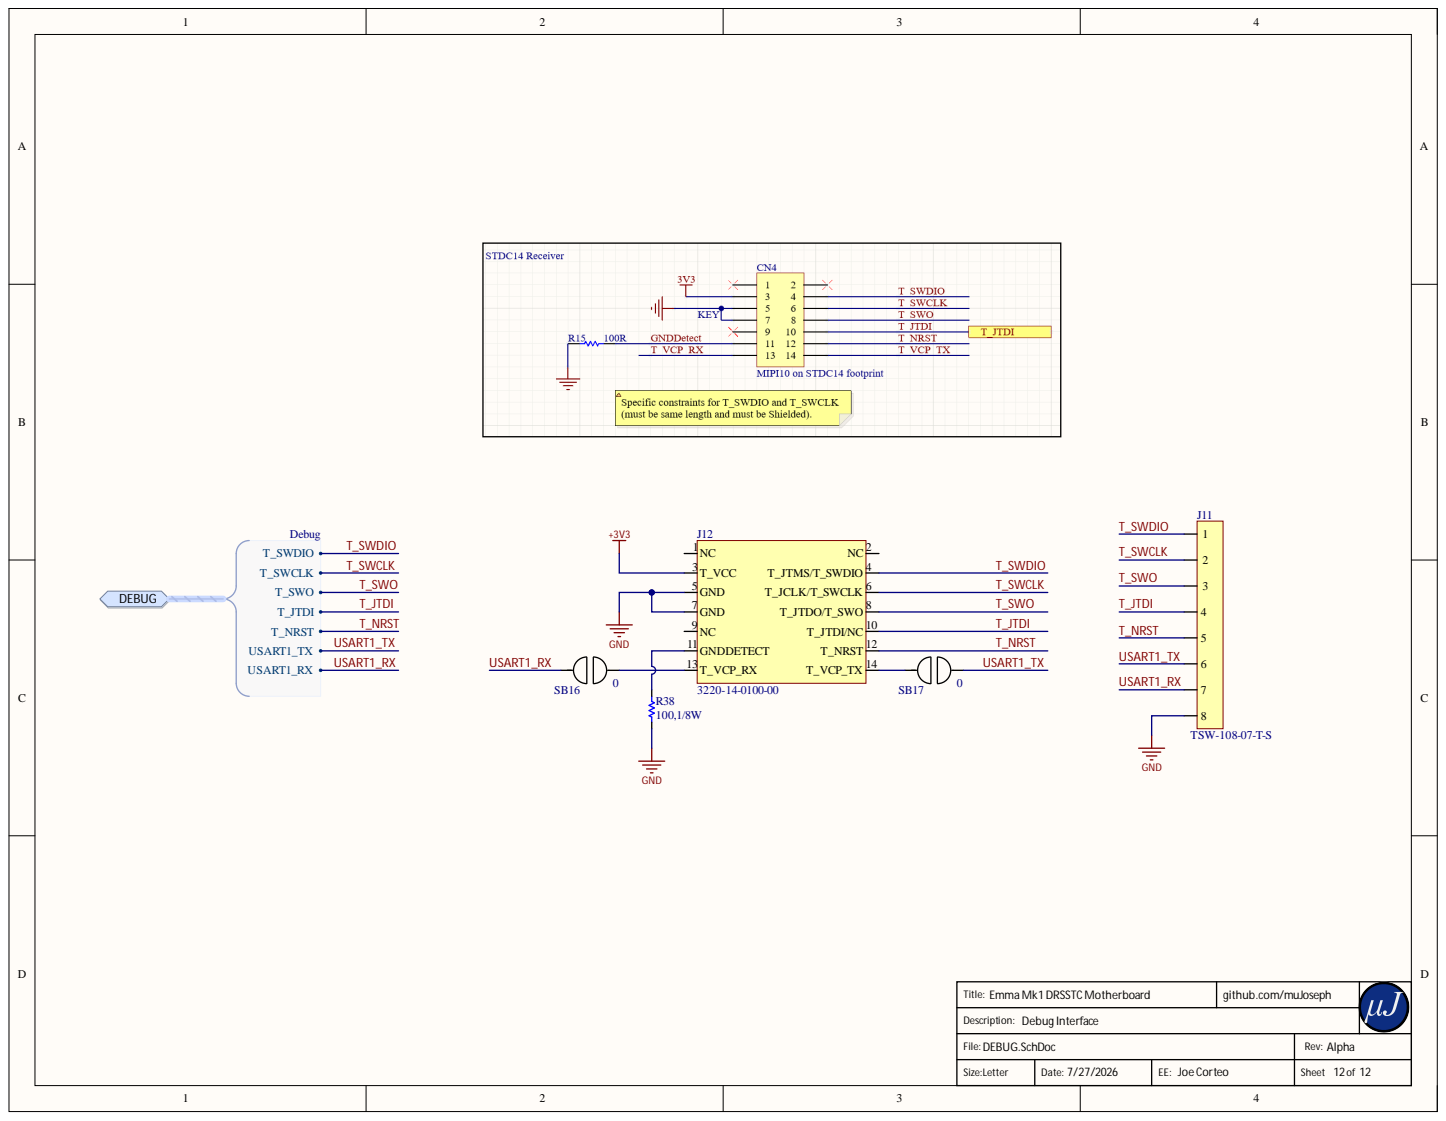
[picture p91: page 12]

Fi le: DEBUG.Sch D o c | Rev: A l p h a

Si ze: Let ter | D ate: 7 / 2 7/ 2026 | E E : Jo e Co r te o | Sheet 1 2 o f 1 2

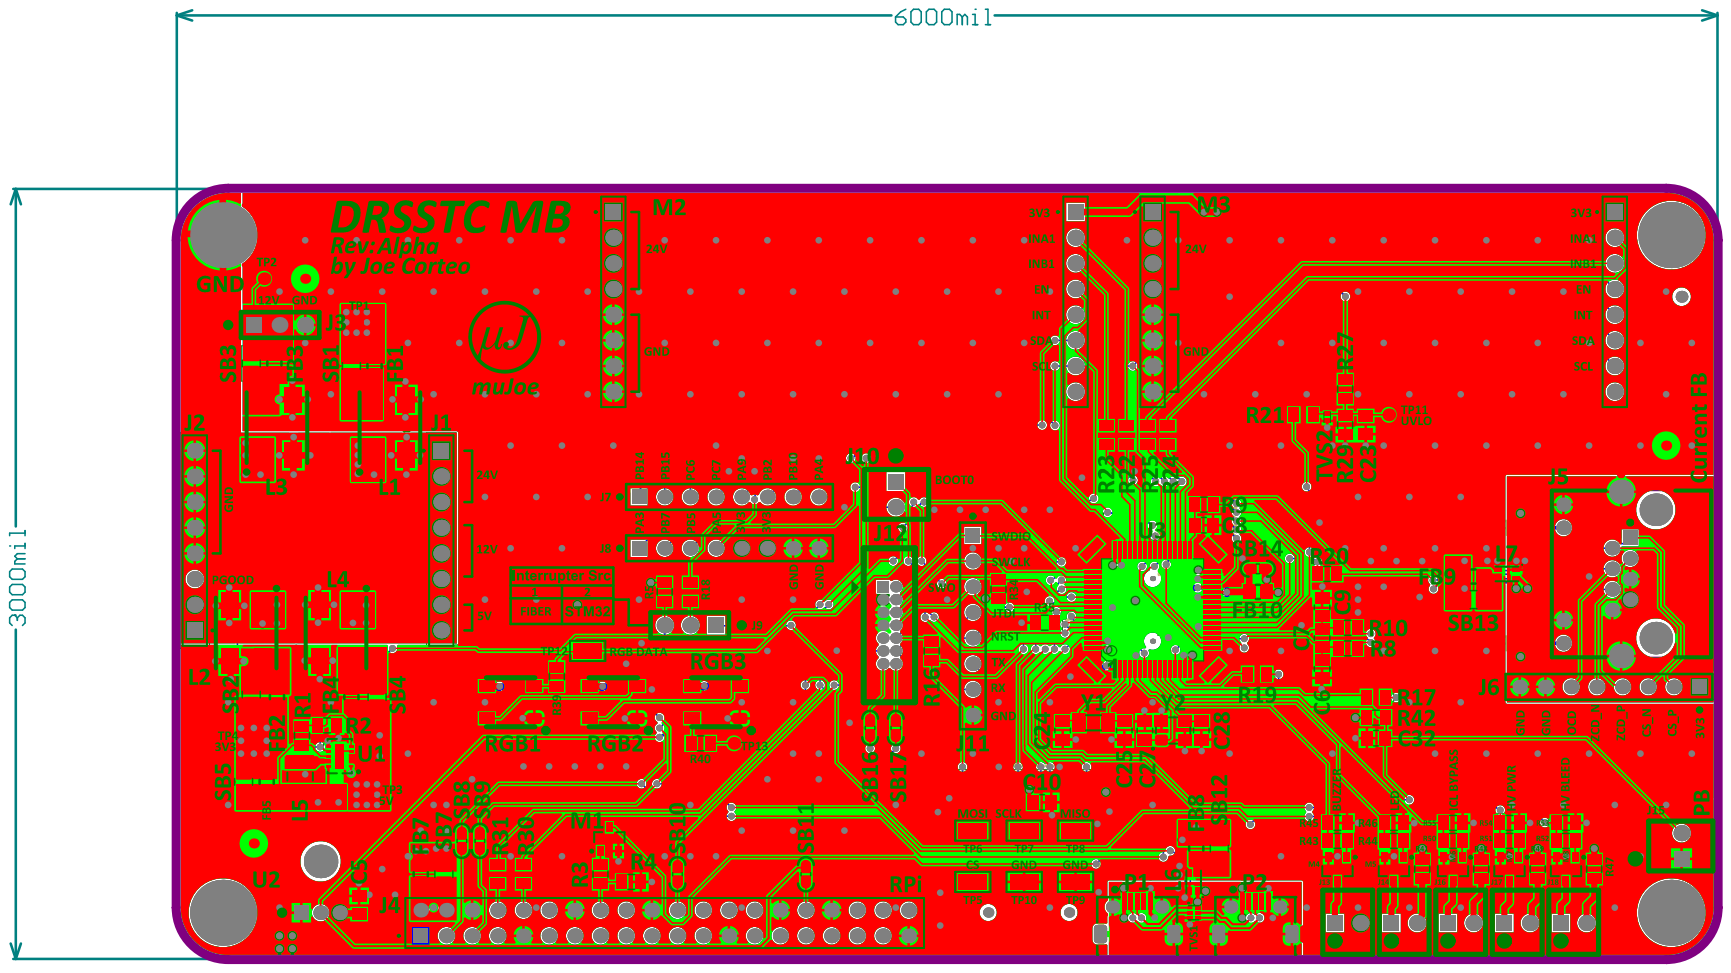
[picture p92: page 13]
