muJoseph/Emma-Mk1-DRSSTC/(commit log)

2026-07-28 - Initial commit
    [BOM-Emma Mk1 DRSSTC MB Rev A(JLCPCB Fabrication).xlsx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]
2026-07-28 - Added board files for Emma Mk1 DRSSTC Half Bridge Rev A
    [BOM-Emma Mk1 DRSSTC Half Bridge Rev A(IGBT Screw On Heatsink).xlsx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]
2026-07-28 - Added board files for Emma Mk1 DRSSTC Rev B - Updated file structure diagram in README.md
    [BOM-Emma Mk1 DRSSTC CS Rev B(Low Diff Gain).xlsx, BOM-Emma Mk1 DRSSTC CS Rev B.xlsx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]
2026-07-29 - Updated file structure diagram in README.md - Added board files for Emma Mk1 DRSSTC GDT Driver Rev D - Added board files for Emma Mk1 DRSSTC VDoubler Rev A - Added many mechanical component product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
    [Air Vent Cover Rev A1.3mf, BOM-Emma Mk1 DRSSTC GDT Driver Rev D(JLCPCB Fab).xlsx, BOM-Emma Mk1 DRSSTC GDT Driver Rev D.xlsx, BOM-Emma Mk1 DRSSTC VDoubler Rev A.xlsx, Back Hatch Rev A2.3mf, CS PCB Standoff Rev A1.3mf, Cap Cradle Bottom Foot Rev A1.3mf, Cap Cradle Top Foot Rev A1.3mf]
2026-07-31 - Added some images pertaining to the mechanical design and PCBs
2026-08-07 - Added board files for Emma Mk1 DRSSTC MMC Bank Rev B
    [BOM-Emma Mk1 DRSSTC MMC Bank Rev B.xlsx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]
2026-08-08 - Added images of renders for Voltage Doubler and GDT Driver PCBs
2026-08-08 - Added images of Motherboard PCB 3D renders
2026-08-13 - Added more images of renders of Emma Mk1 DRSSTC assembly
2026-08-13 - Added img of render of isolated PCB assembly
2026-09-01 - Added images of 3D renders for Current Sense and MMC PCBs
2026-10-07 - Added fab files for Secondary Coil Holder, Extender and Sleeve - Added STEP file for Primary Coil
    [Primary Coil.step, Sec Coil Holder Extender Rev A1.3mf, Sec Coil Holder Extender Rev A2.3mf, Sec Coil Holder Extender RevA3.3mf, Sec Coil Holder.3mf, Sec Coil Sleeve Rev A2.3mf]
2026-10-09 - Added fab files for two new secondary coil holder extenders. Used to further evaluate DRSSTC performance based on primary to secondary coil coupling.
    [Sec Coil Holder Extender Rev A3.3mf, Sec Coil Holder Extender Rev A4.3mf, Sec Coil Holder Extender Rev A5.3mf]
2026-10-23 - Added step files for Primary Coil Supports
    [EmmaMk1_Pri_Coil_Holder_NE_Rev_A1.step, EmmaMk1_Pri_Coil_Holder_NW_Rev_A1.step, EmmaMk1_Pri_Coil_Holder_SE_Rev_A1.step, EmmaMk1_Pri_Coil_Holder_SW_Rev_A1.step]
